nilotpal-n7/NanoD1/Project Outputs for NanoD1/Assembly Assembly/PCB 3D Print/NanoD1(Assembly).png

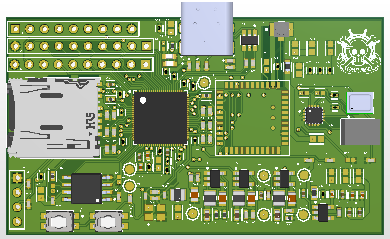
Project Outputs for NanoD1/Assembly Assembly/PCB 3D Print/NanoD1(Assembly).png
