nilotpal-n7/NanoD1/SBC/claude-gen/nano-d1-schematic.html

# Nano-D1

SG2002 · Schematic rev3 · I2S audio

—Parts

—Nets

—Pins

—Verify

Open items BOM Passives Clear

## Stackup

1.62 mm · 4L · 1 oz every layer. To scale. Click a copper layer to hide its nets.

Amber = verify before fab. Three items are unresolved and marked on the parts they affect.

Hover for value and notes · click to trace a net · drag to pan · scroll to zoom · Esc clears

+−⤢
