nilotpal-n7/NanoD1/Project Outputs for NanoD1/Assembly Assembly/Report Board Stack/NanoD1.xls

Board Stack Report
Stack Up |  | Layer Stack
Layer | Board Layer Stack | Name | Material | Thickness | Constant
1 |  | Top Overlay |  | 0mil
2 |  | Top Solder | SM-001 | 0.799mil | 3.8
3 |  | Top Layer | CF-004 | 1.378mil
4 |  | Dielectric 1 | PP-016 | 4.583mil | 4.16
5 |  | GND | CF-004 | 0.598mil
6 |  | Dielectric 2 | Core-043 | 49.803mil | 4.6
7 |  | POWER | CF-004 | 0.598mil
8 |  | Dielectric 3 | PP-016 | 4.583mil | 4.16
9 |  | Bottom Layer | CF-004 | 1.378mil
10 |  | Bottom Solder | SM-001 | 0.799mil | 3.8
11 |  | Bottom Overlay |  | 0mil
 | Height : 64.52mil
