nilotpal-n7/NanoD1/img0.bmp

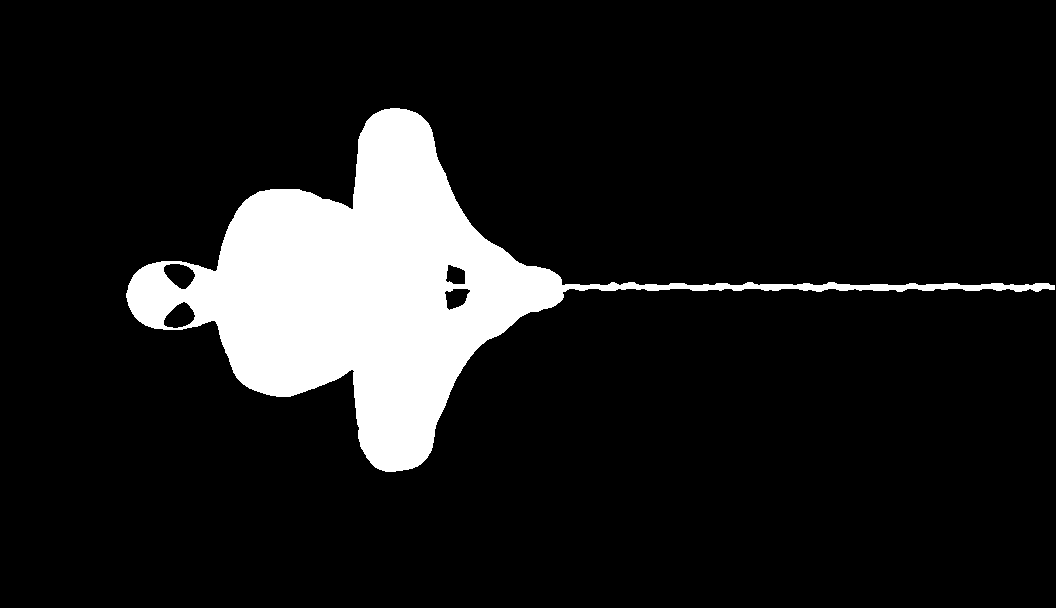
img0.bmp
