nilotpal-n7/NanoD1/img1.bmp

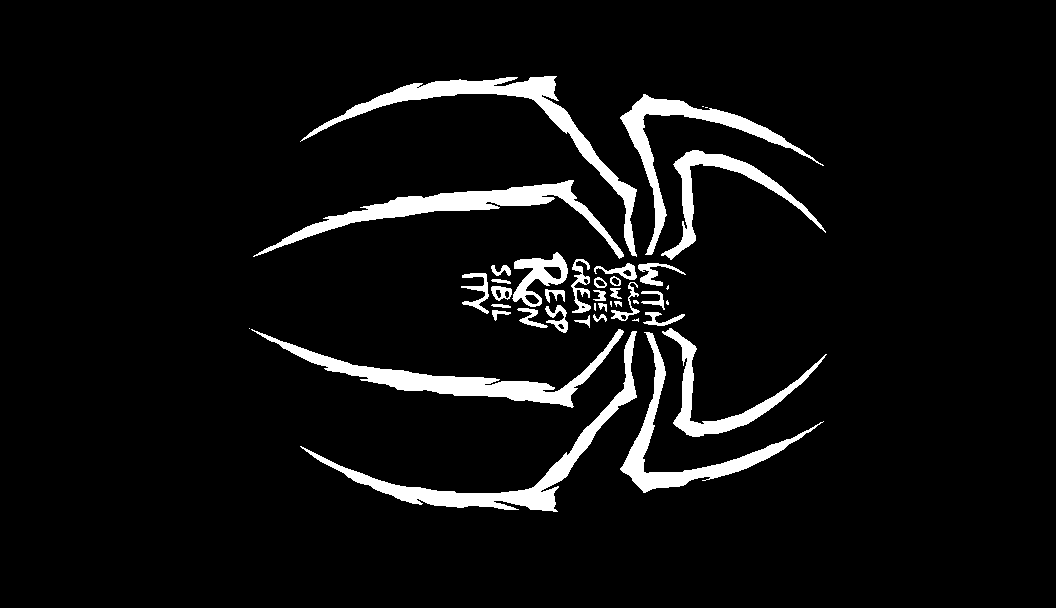
img1.bmp
