nilotpal-n7/NanoD1/Renders/NanoD1_bottom_black_nopour.png

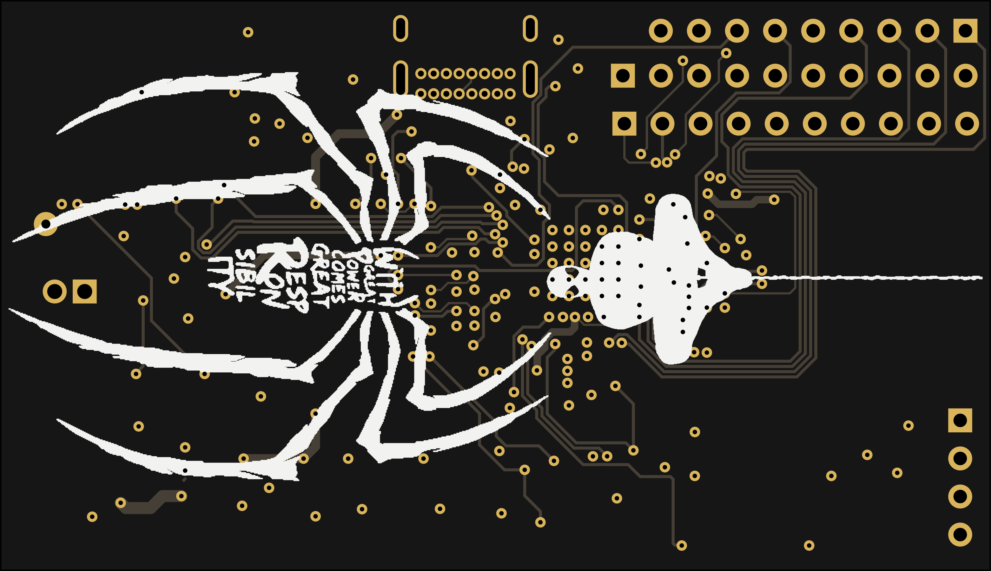
Renders/NanoD1_bottom_black_nopour.png
