nilotpal-n7/NanoD1/Renders/NanoD1_bottom_white_nopour.png

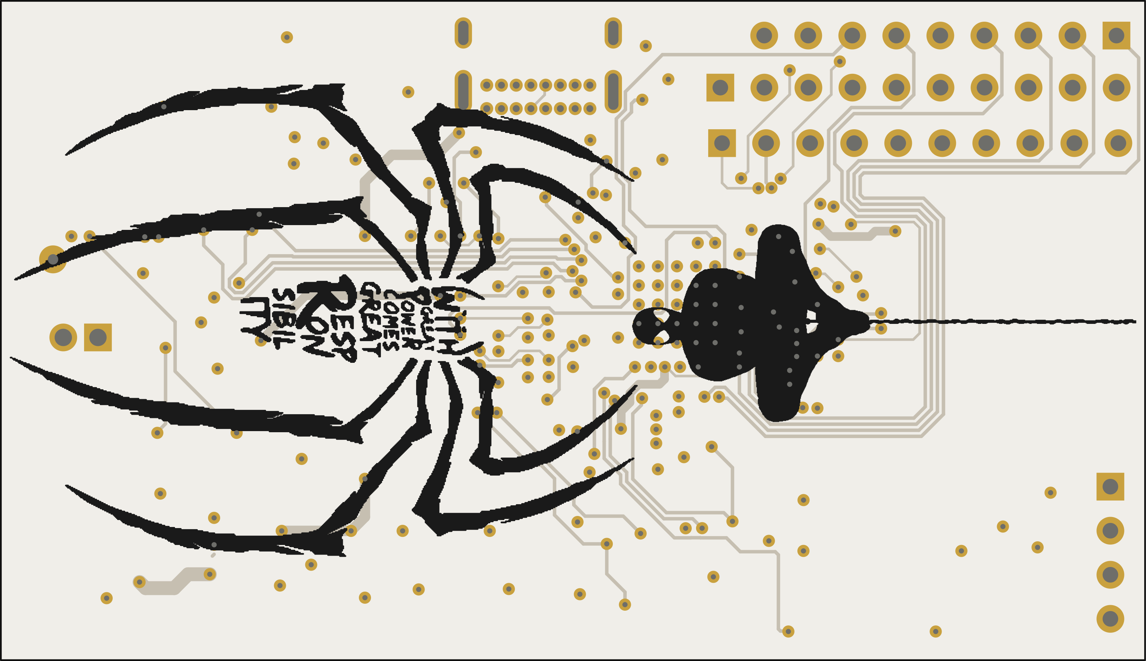
Renders/NanoD1_bottom_white_nopour.png
