nilotpal-n7/NanoD1/Renders/NanoD1_combined_top_black_pour_bottom_black_nopour.png

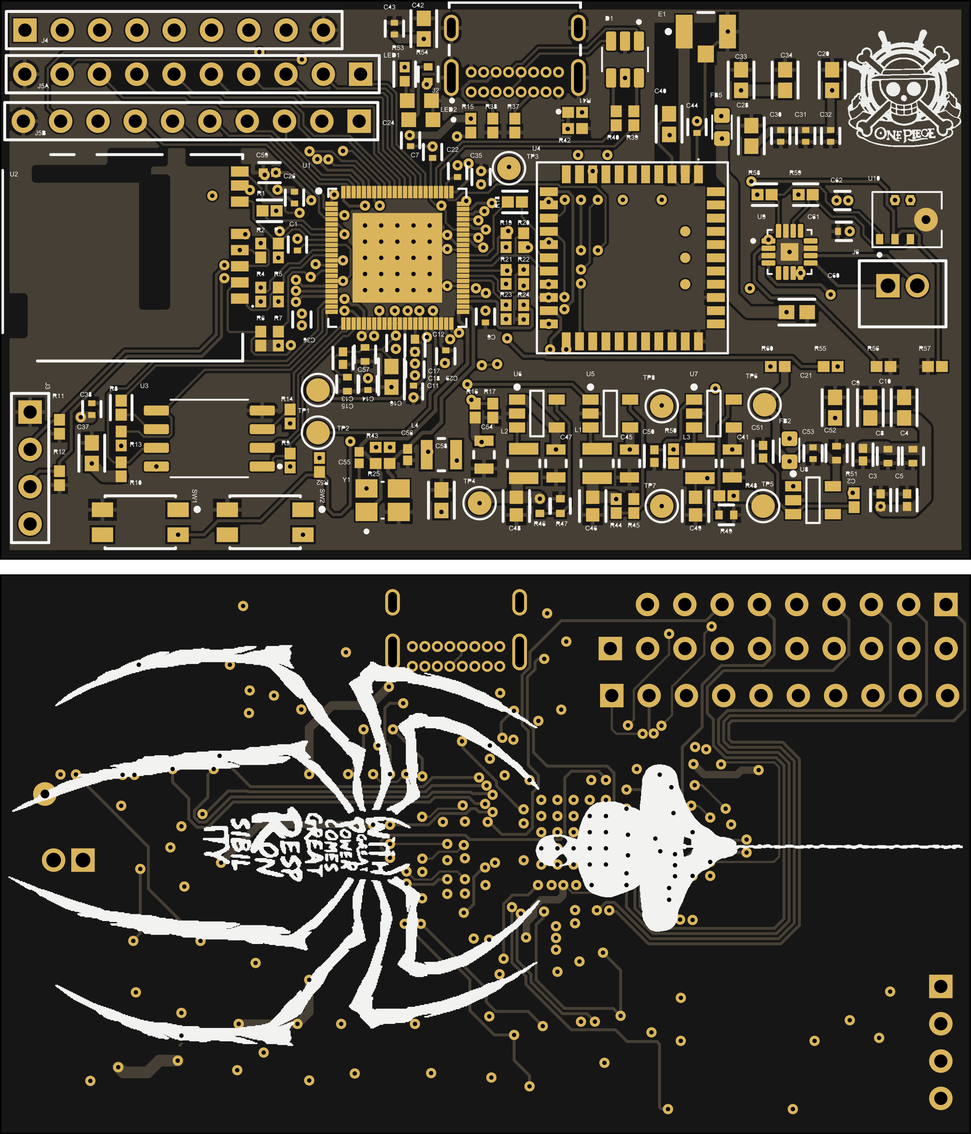
Renders/NanoD1_combined_top_black_pour_bottom_black_nopour.png
