nilotpal-n7/NanoD1/Renders/NanoD1_combined_top_white_pour_bottom_white_nopour.png

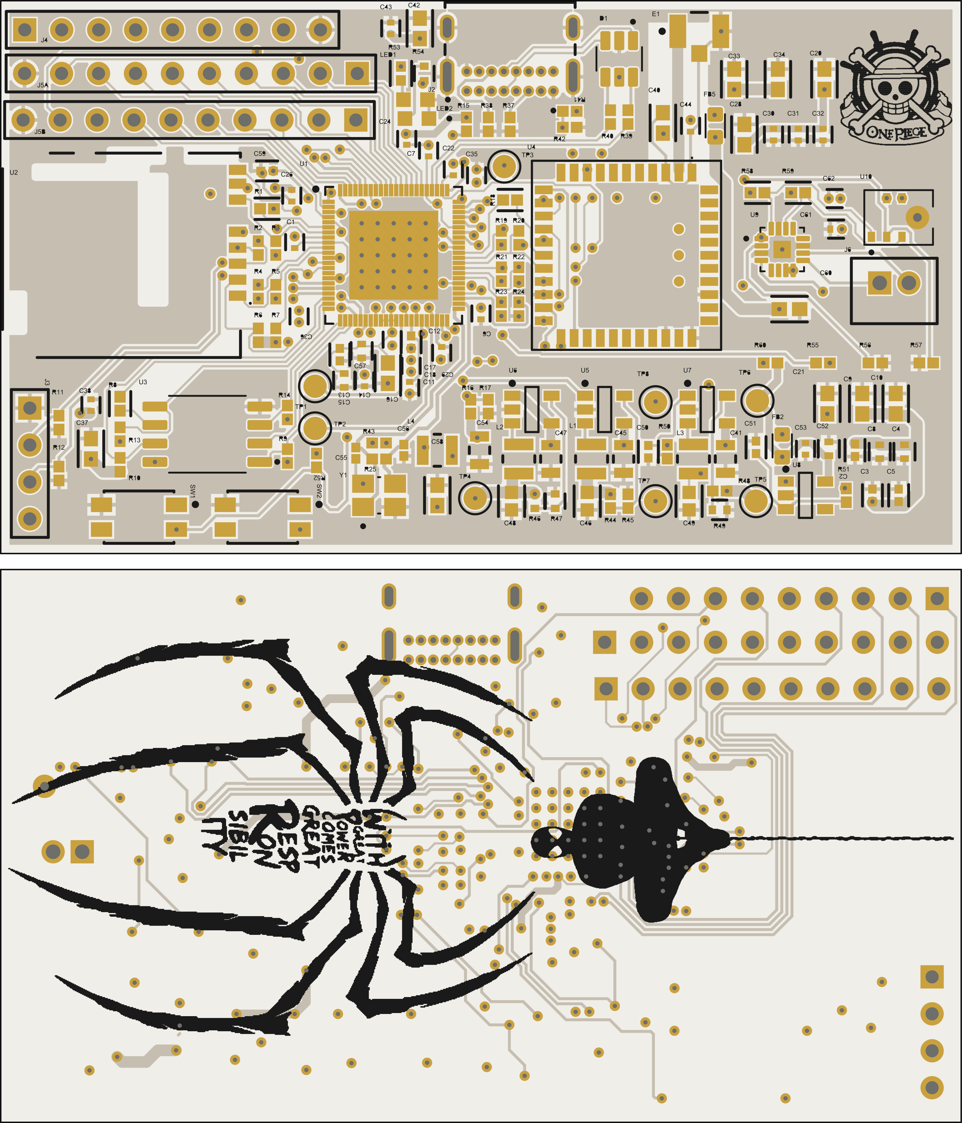
Renders/NanoD1_combined_top_white_pour_bottom_white_nopour.png
