nilotpal-n7/NanoD1/Renders/NanoD1_top_white_pour.png

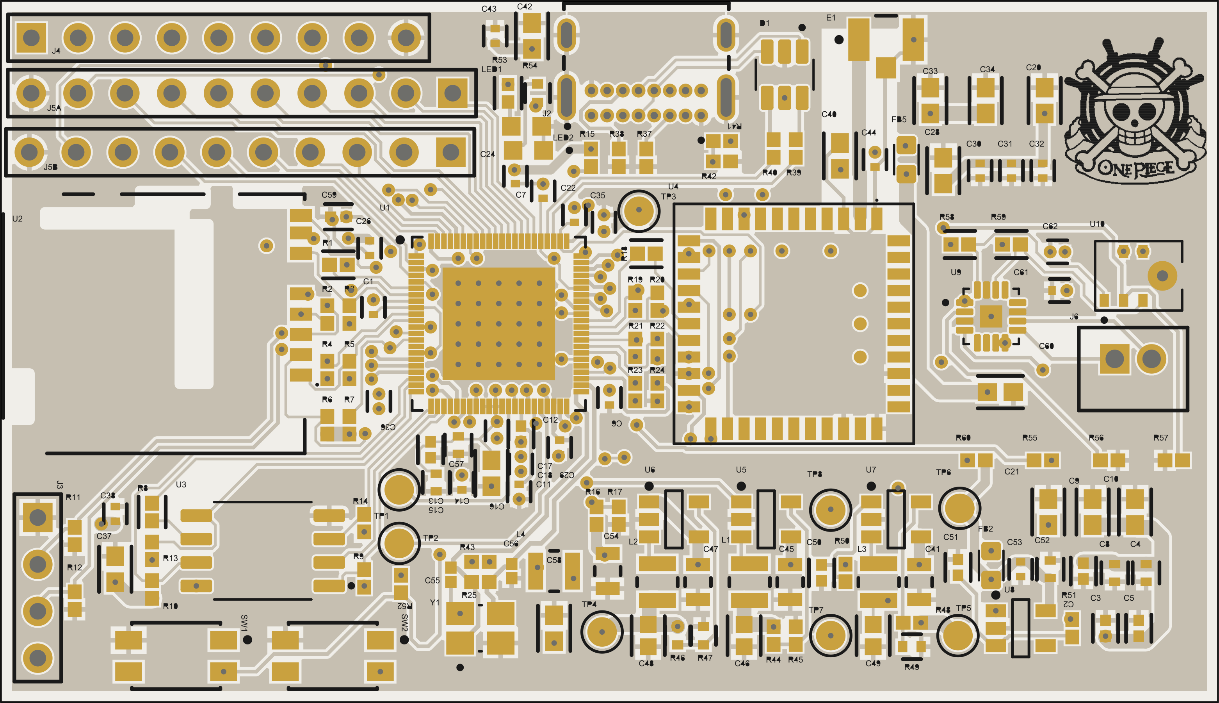
Renders/NanoD1_top_white_pour.png
