nilotpal-n7/NanoD1/SBC/components-doc/SCH_RK3576 SoM.pdf

RK3576 (Power) | RK3576 (GND)

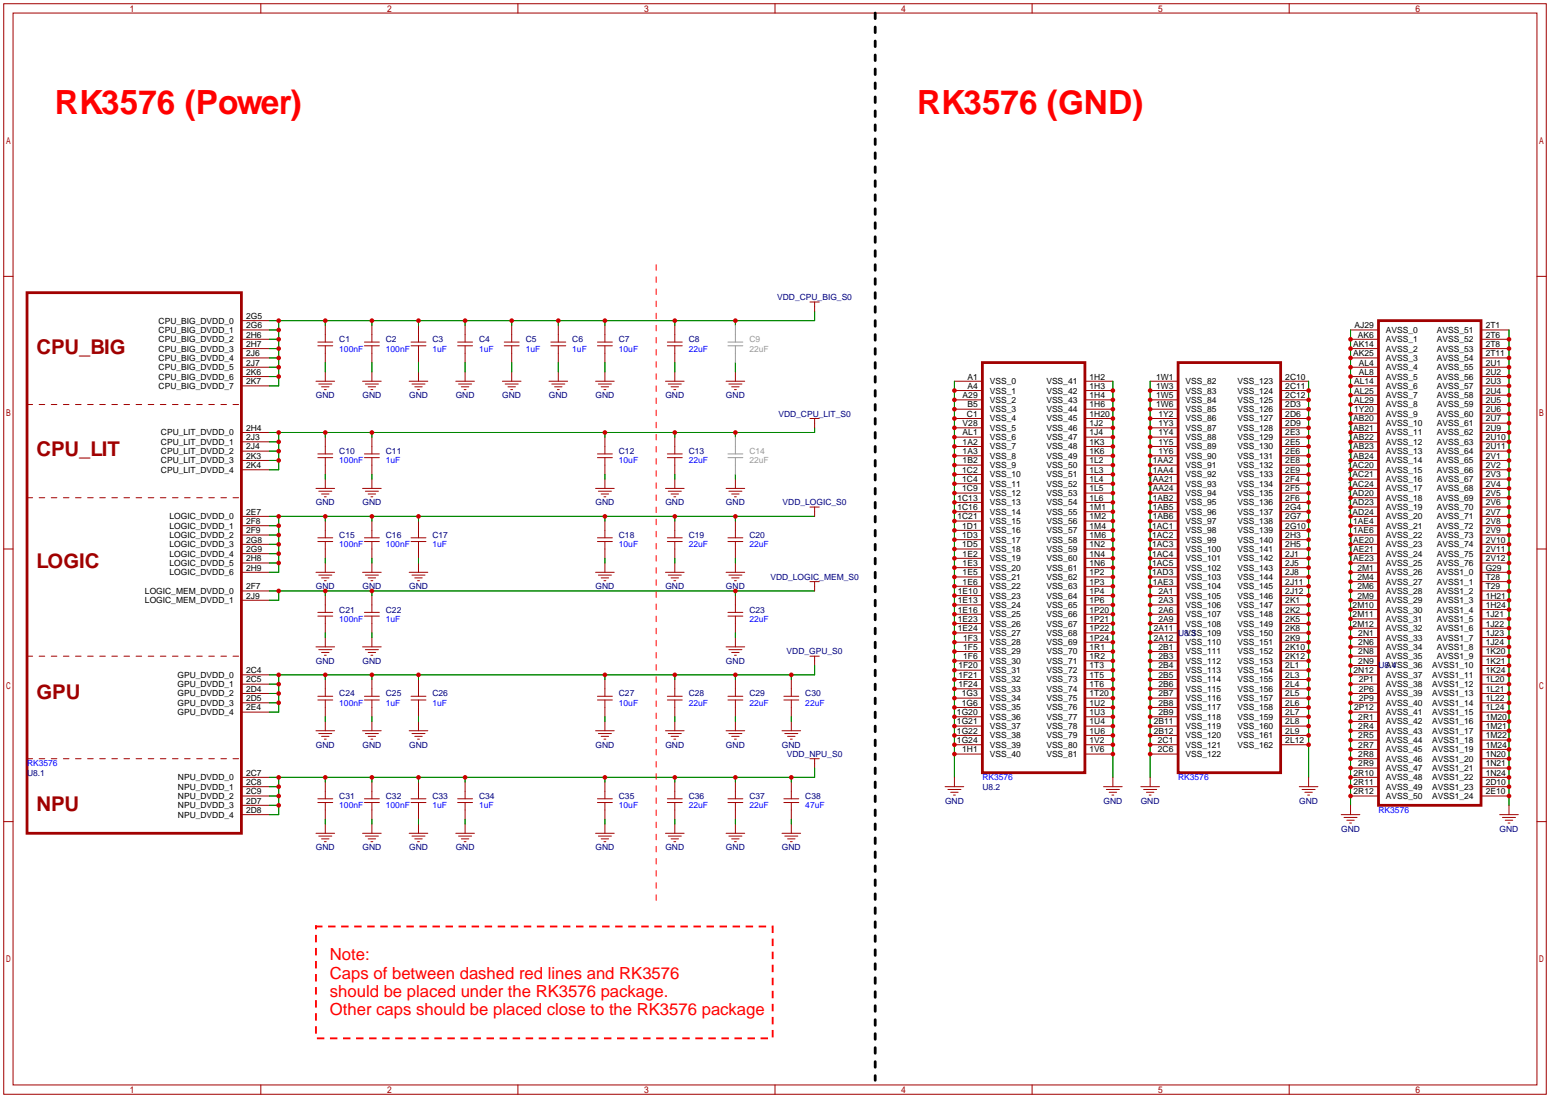
[picture p10: page 1]

Note:
Caps of between dashed red lines and RK3576
should be placed under the RK3576 package.
Other caps should be placed close to the RK3576 package

# PLL

## OSC PMUIO0 Domain

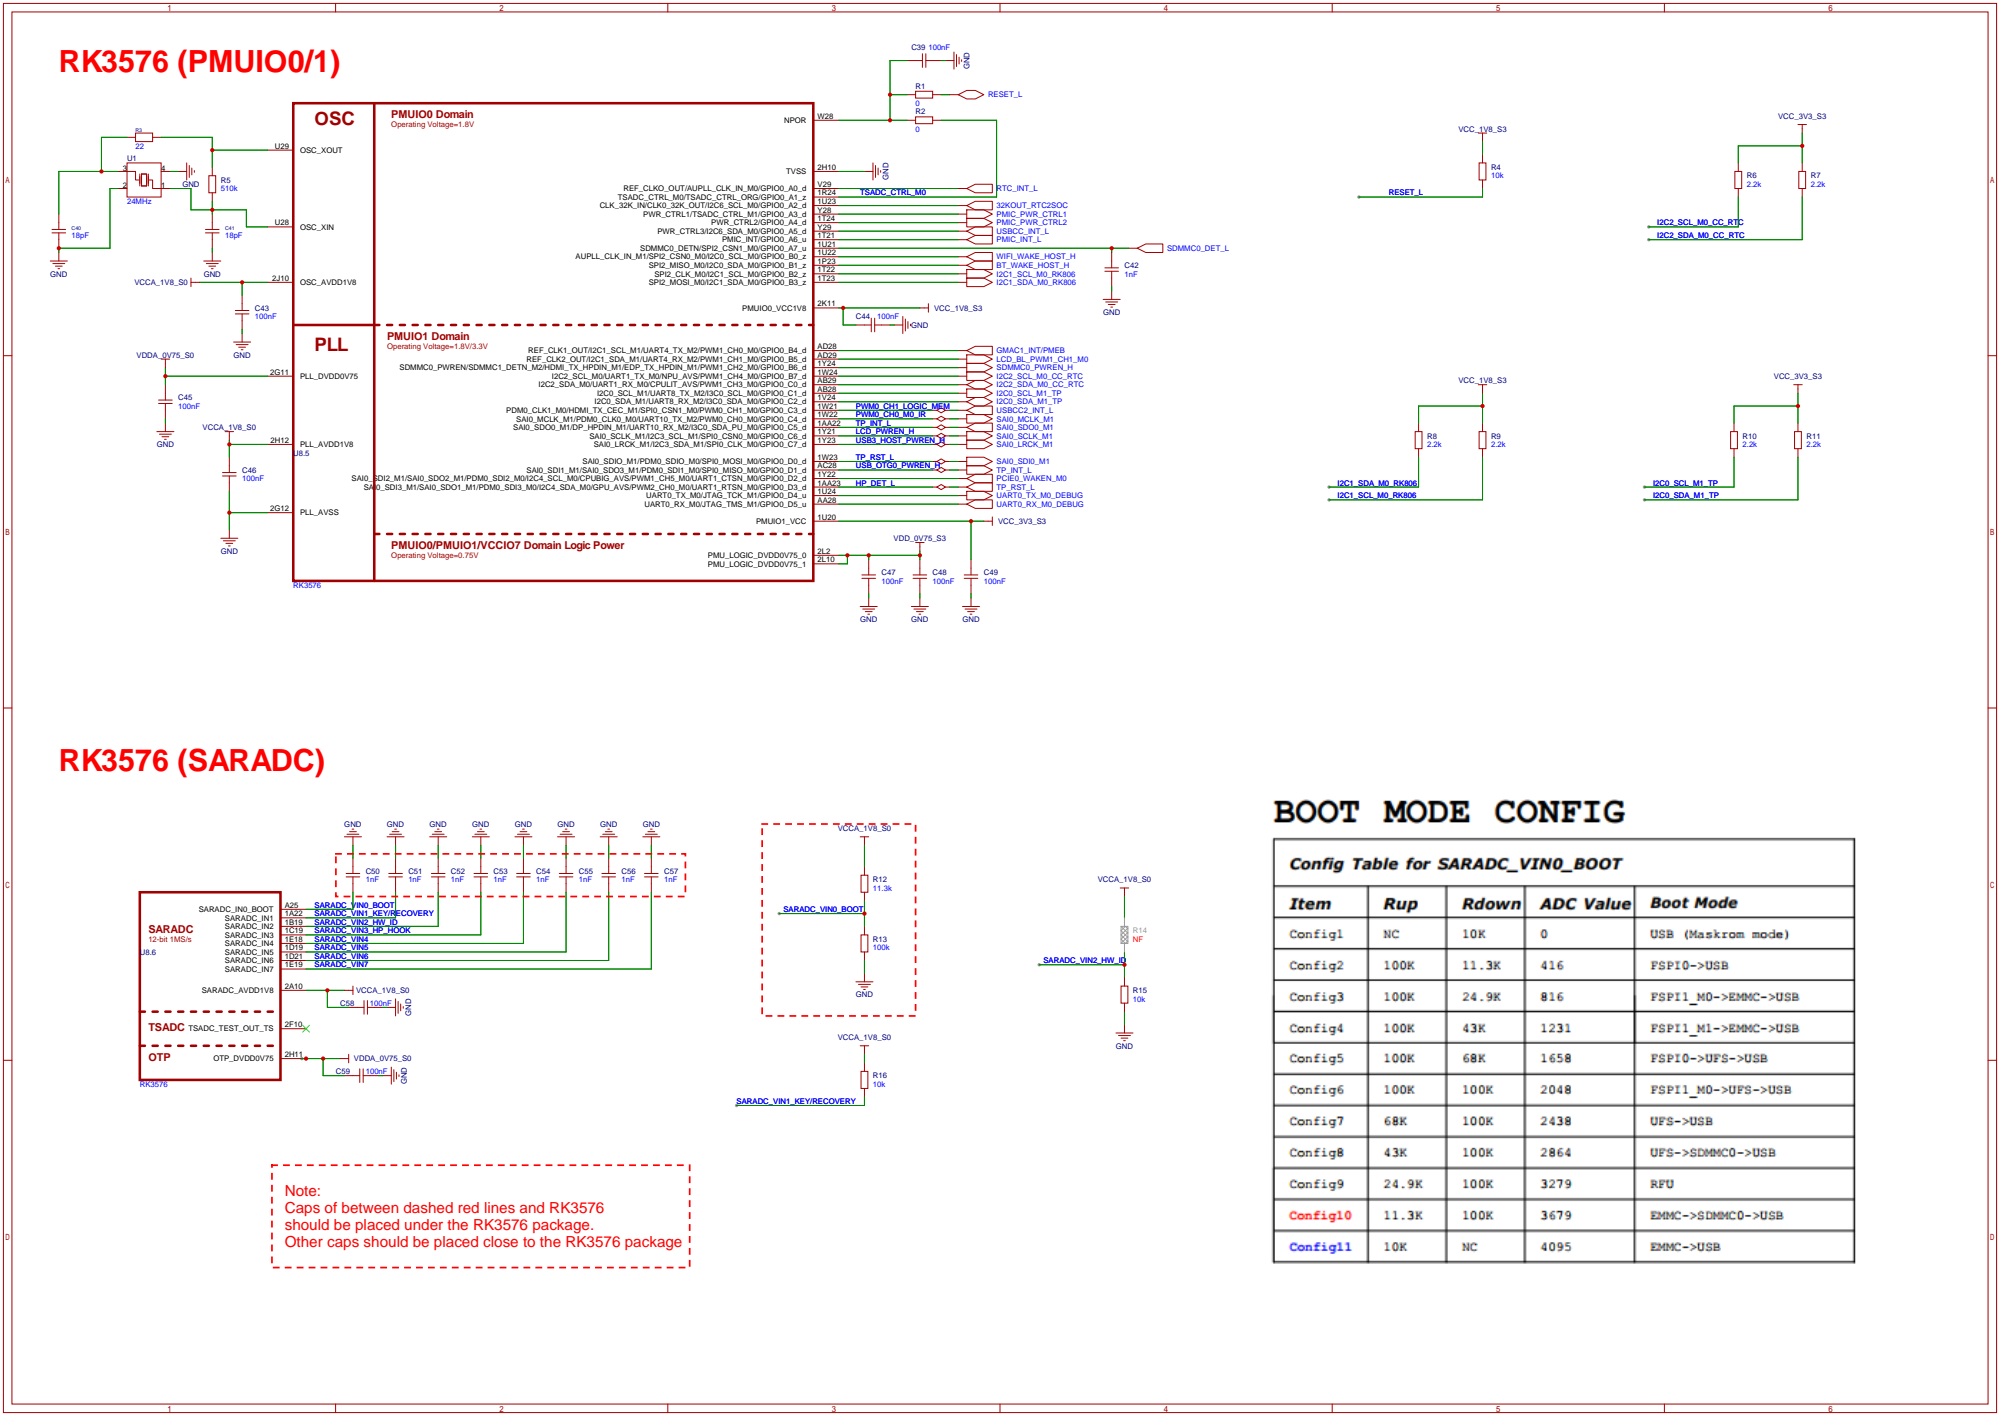
[picture p11: page 2]

Note:
Caps of between dashed red lines and RK3576
should be placed under the RK3576 package.
Other caps should be placed close to the RK3576 package

# RK3576 (DDRPHY)

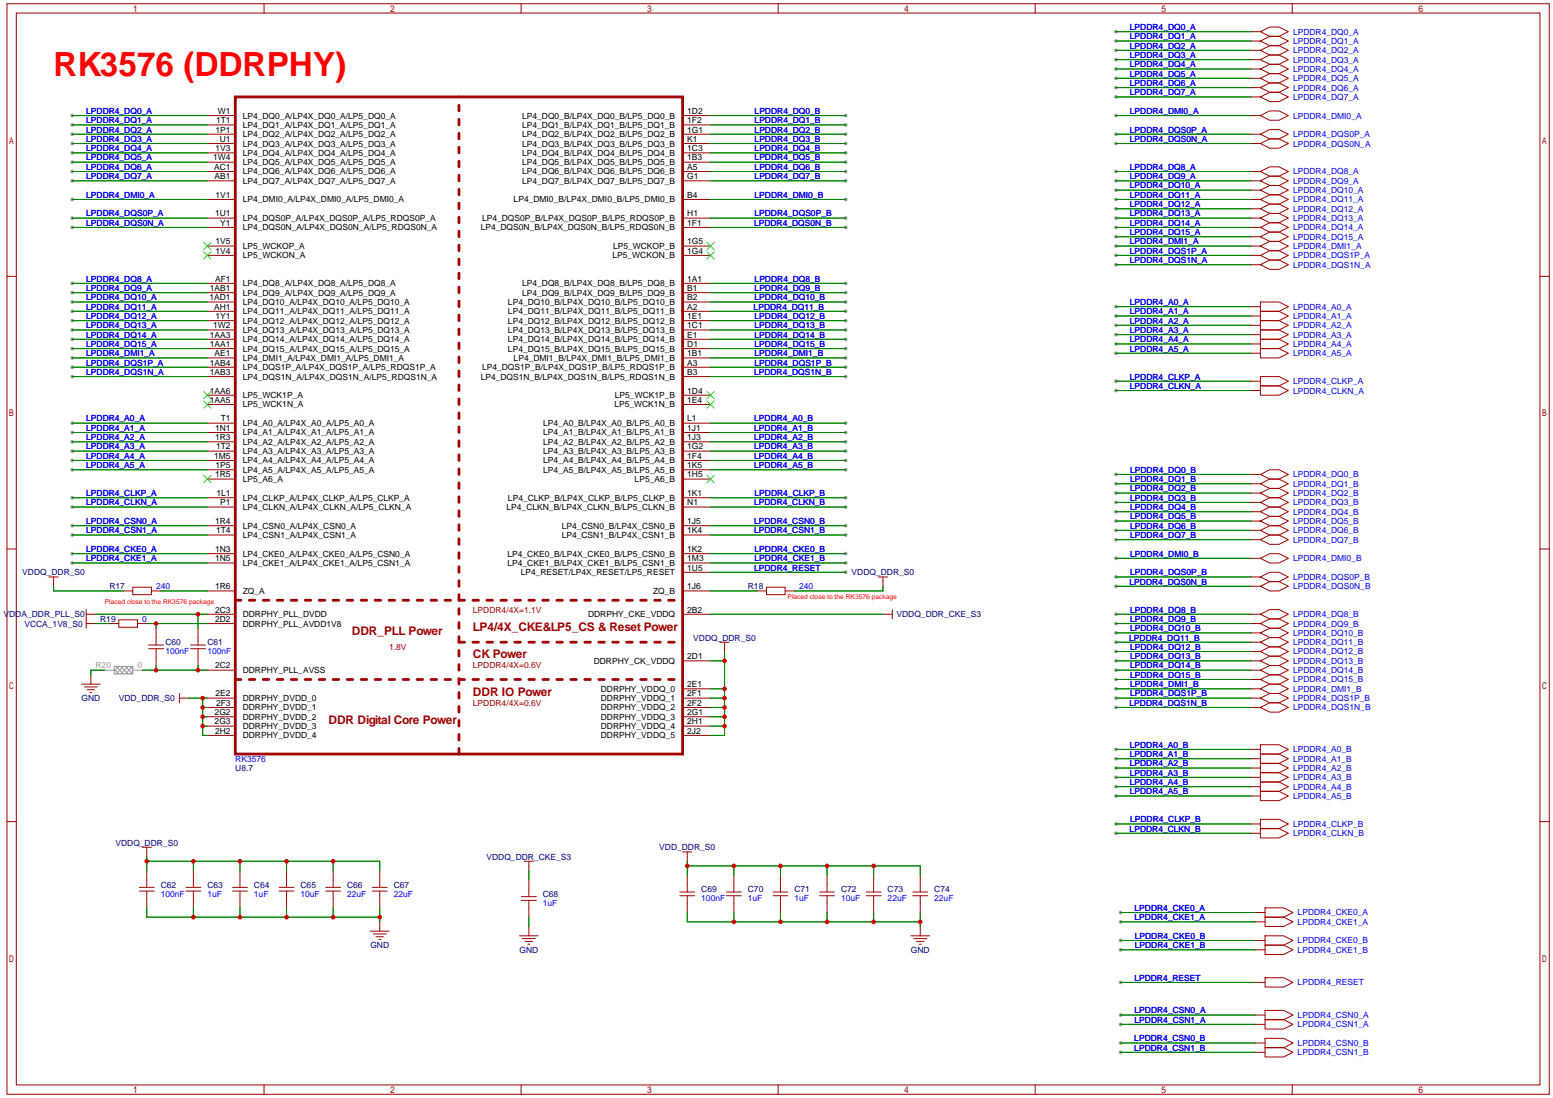
[picture p12: page 3]

Placed close to the RK3576 package

DDR Digital Core Power

## UFS2.1

## VCCIO7 Domain

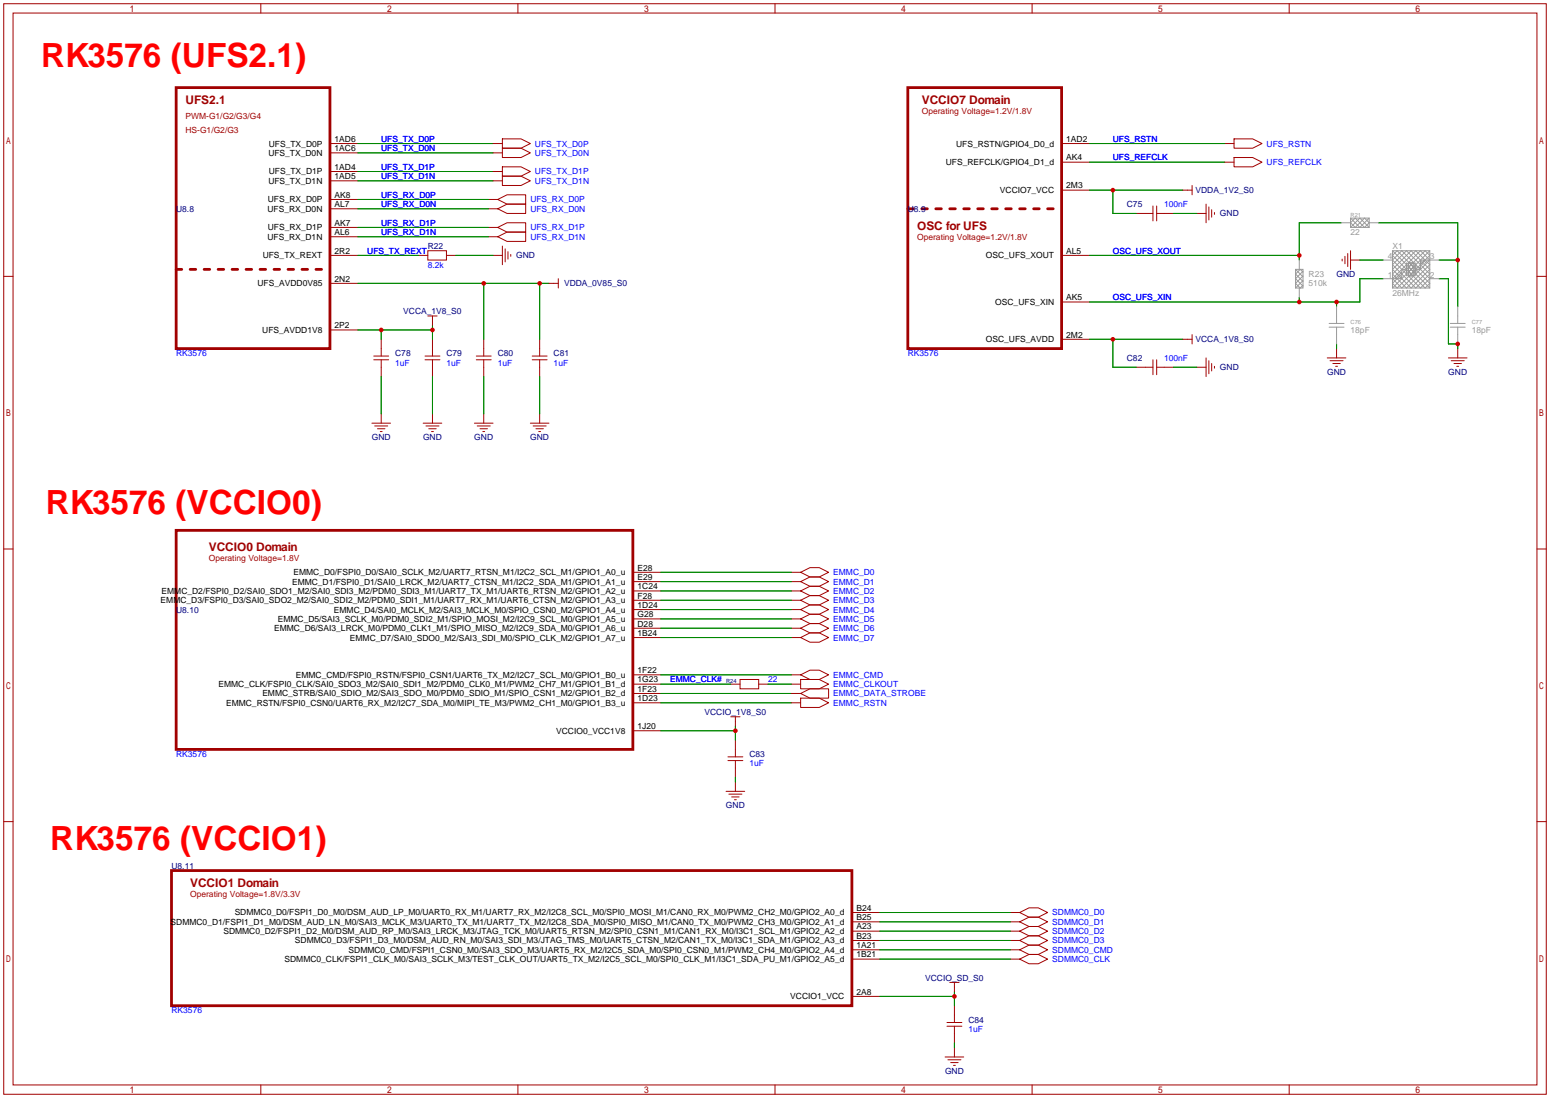
[picture p13: page 4]

# RK3576 (USB3/DP)

## USB3 OTG0/DP1.4 Alt

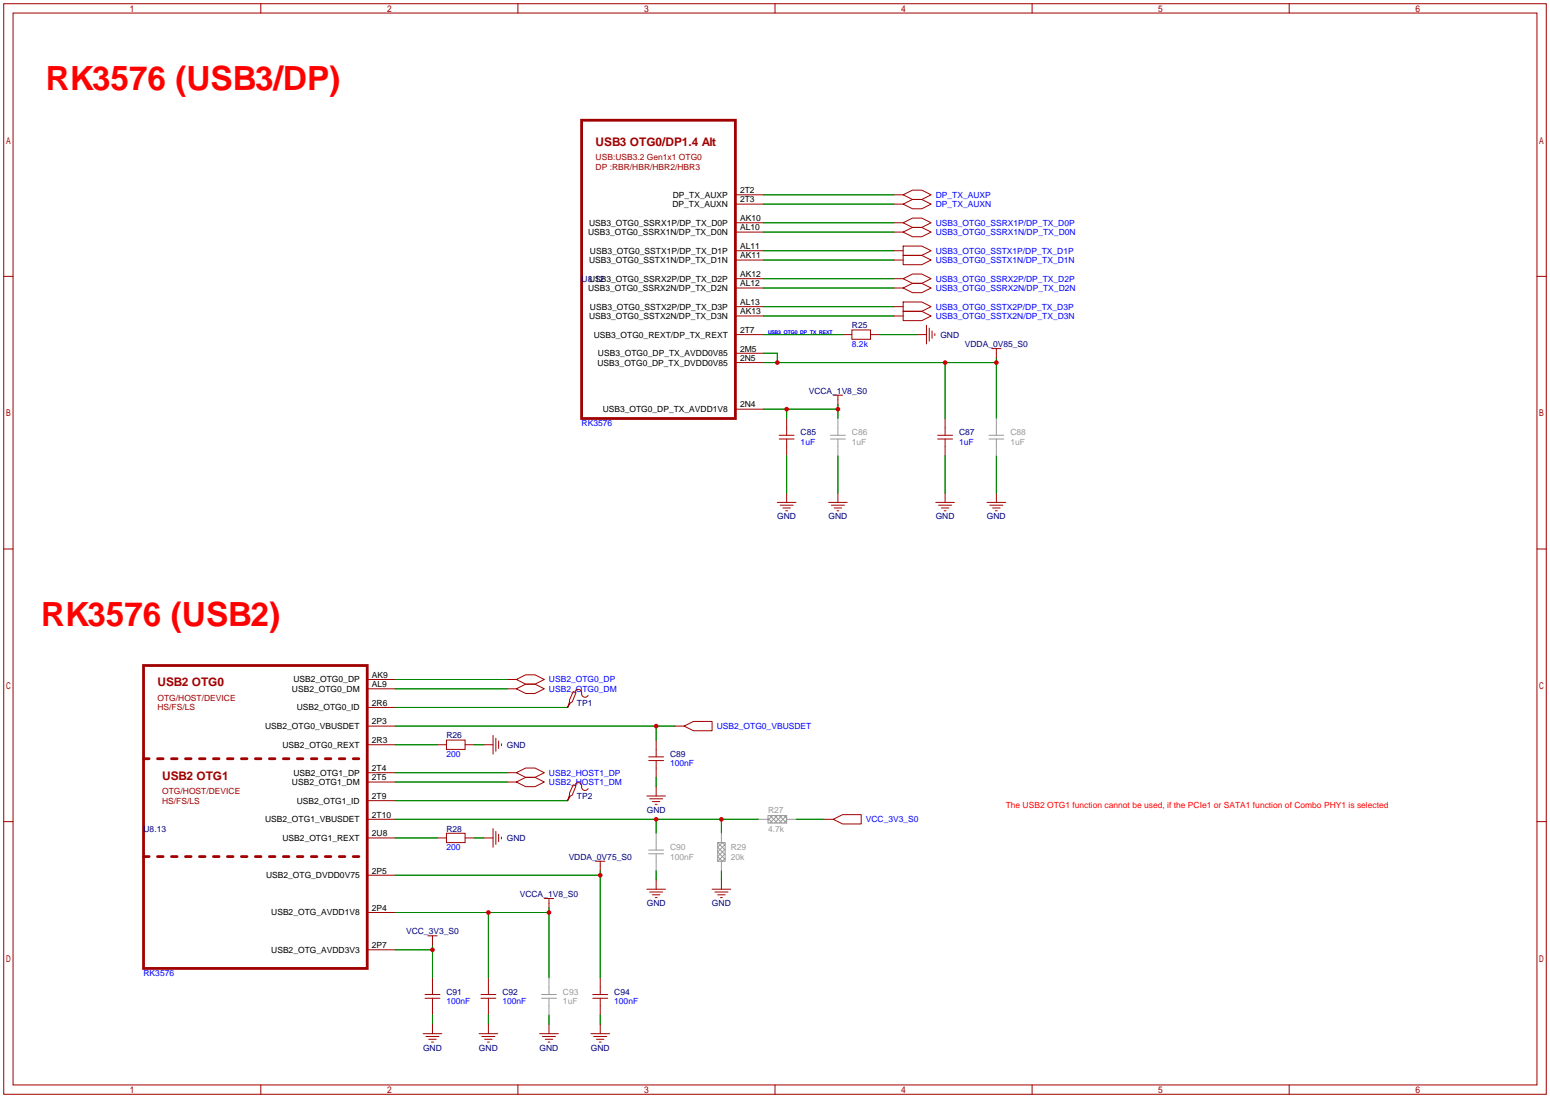
[picture p14: page 5]

The USB2 OTG1 function cannot be used, if the PCIe1 or SATA1 function of Combo PHY1 is selected

# RK3576 (MIPI DCPHY)

## MIPI DCPHY DSI TX

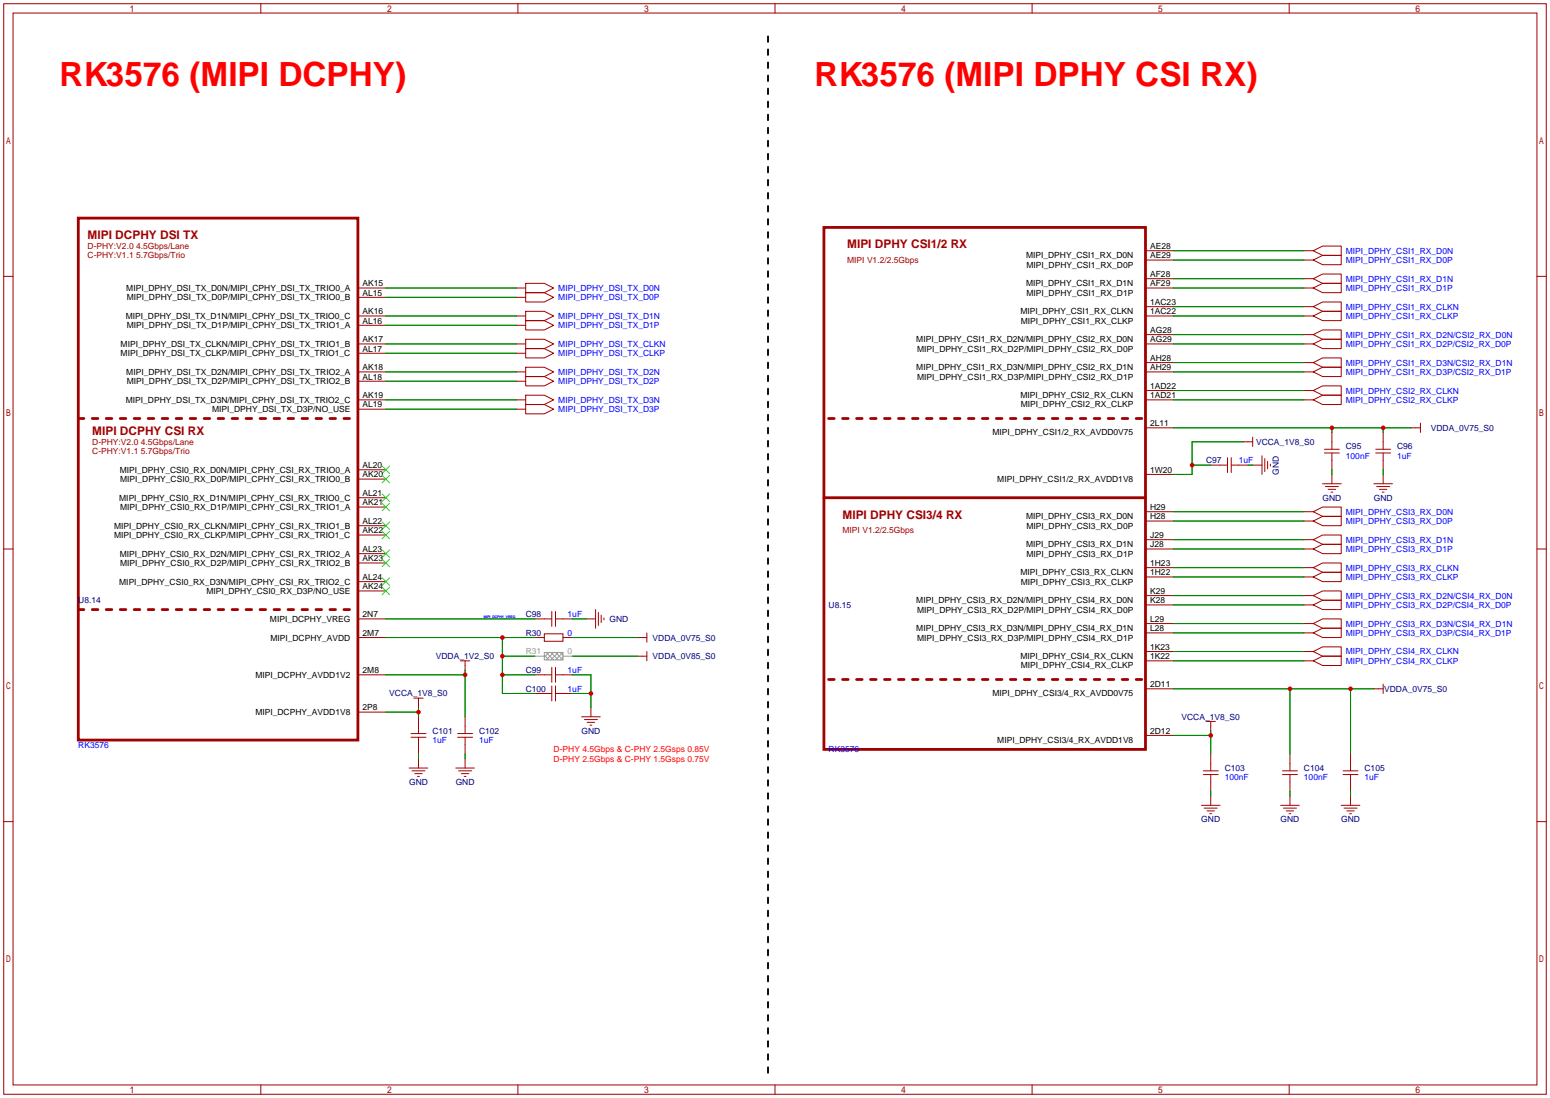
[picture p15: page 6]

RK3576 (MIPI DPHY CSI RX)

# RK3576 (HDMI/eDP)

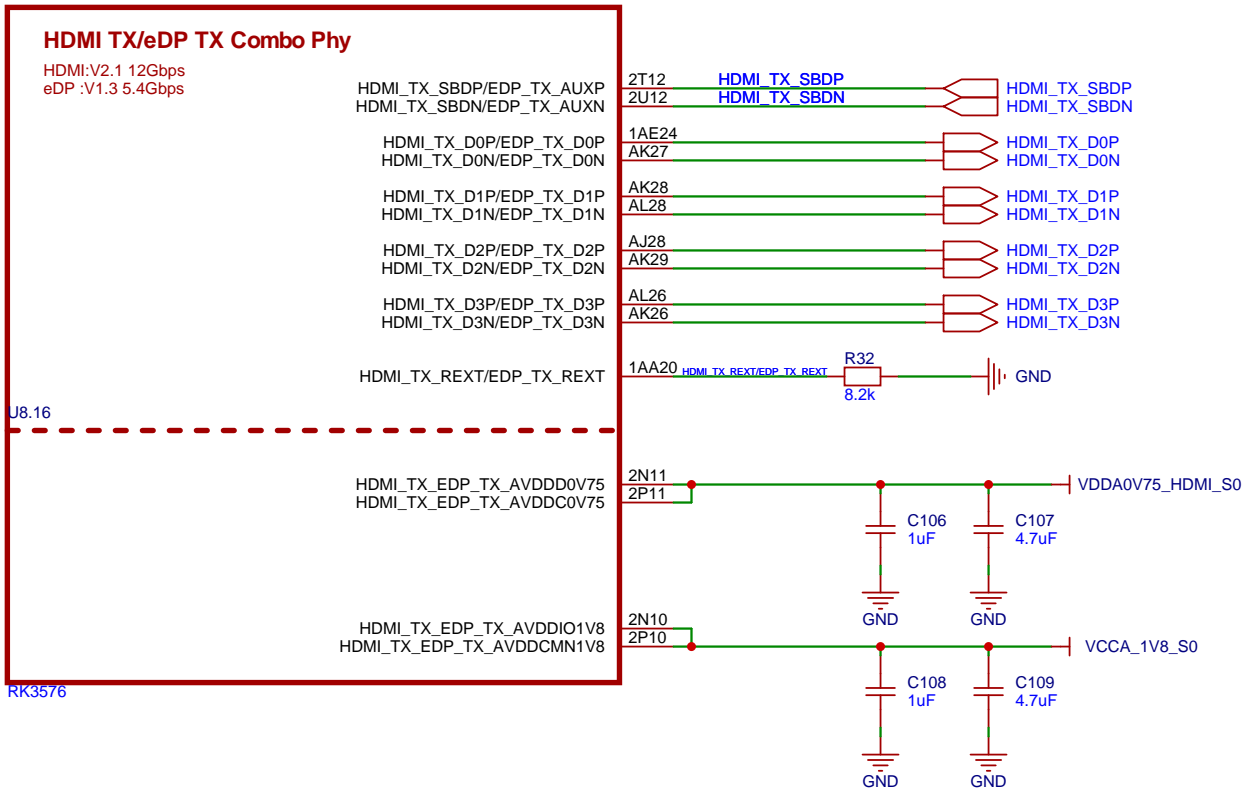
[picture p16: figure]
HDMI_TX_SBDP/EDP_TX_AUXP 2T12 HDMI_TX_SBDN/EDP_TX_AUXN 2U12; HDMI_TX_D0P/EDP_TX_D0P 1AE24 HDMI_TX_D0N/EDP_TX_D0N AK27; HDMI_TX_D1P/EDP_TX_D1P AK28 HDMI_TX_D1N/EDP_TX_D1N AL28; HDMI_TX_D2P/EDP_TX_D2P AJ28 HDMI_TX_D2N/EDP_TX_D2N AK29; HDMI_TX_D3P/EDP_TX_D3P AL26 HDMI_TX_D3N/EDP_TX_D3N AK26; HDMI_TX_REXT/EDP_TX_REXT 1AA20; HDMI_TX_EDP_TX_AVDDD0V75 2N11 HDMI_TX_EDP_TX_AVDDC0V75 2P11; HDMI_TX_EDP_TX_AVDDIO1V8 2N10 HDMI_TX_EDP_TX_AVDDCMN1V8 2P10; HDMI TX/eDP TX Combo Phy; HDMI:V2.1 12Gbps eDP :V1.3 5.4Gbps; HDMI_TX_D0P HDMI_TX_D0N; HDMI_TX_D1P HDMI_TX_D1N; HDMI_TX_D2P HDMI_TX_D2N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

# RK3576 (PCIe/SATA/USB3)

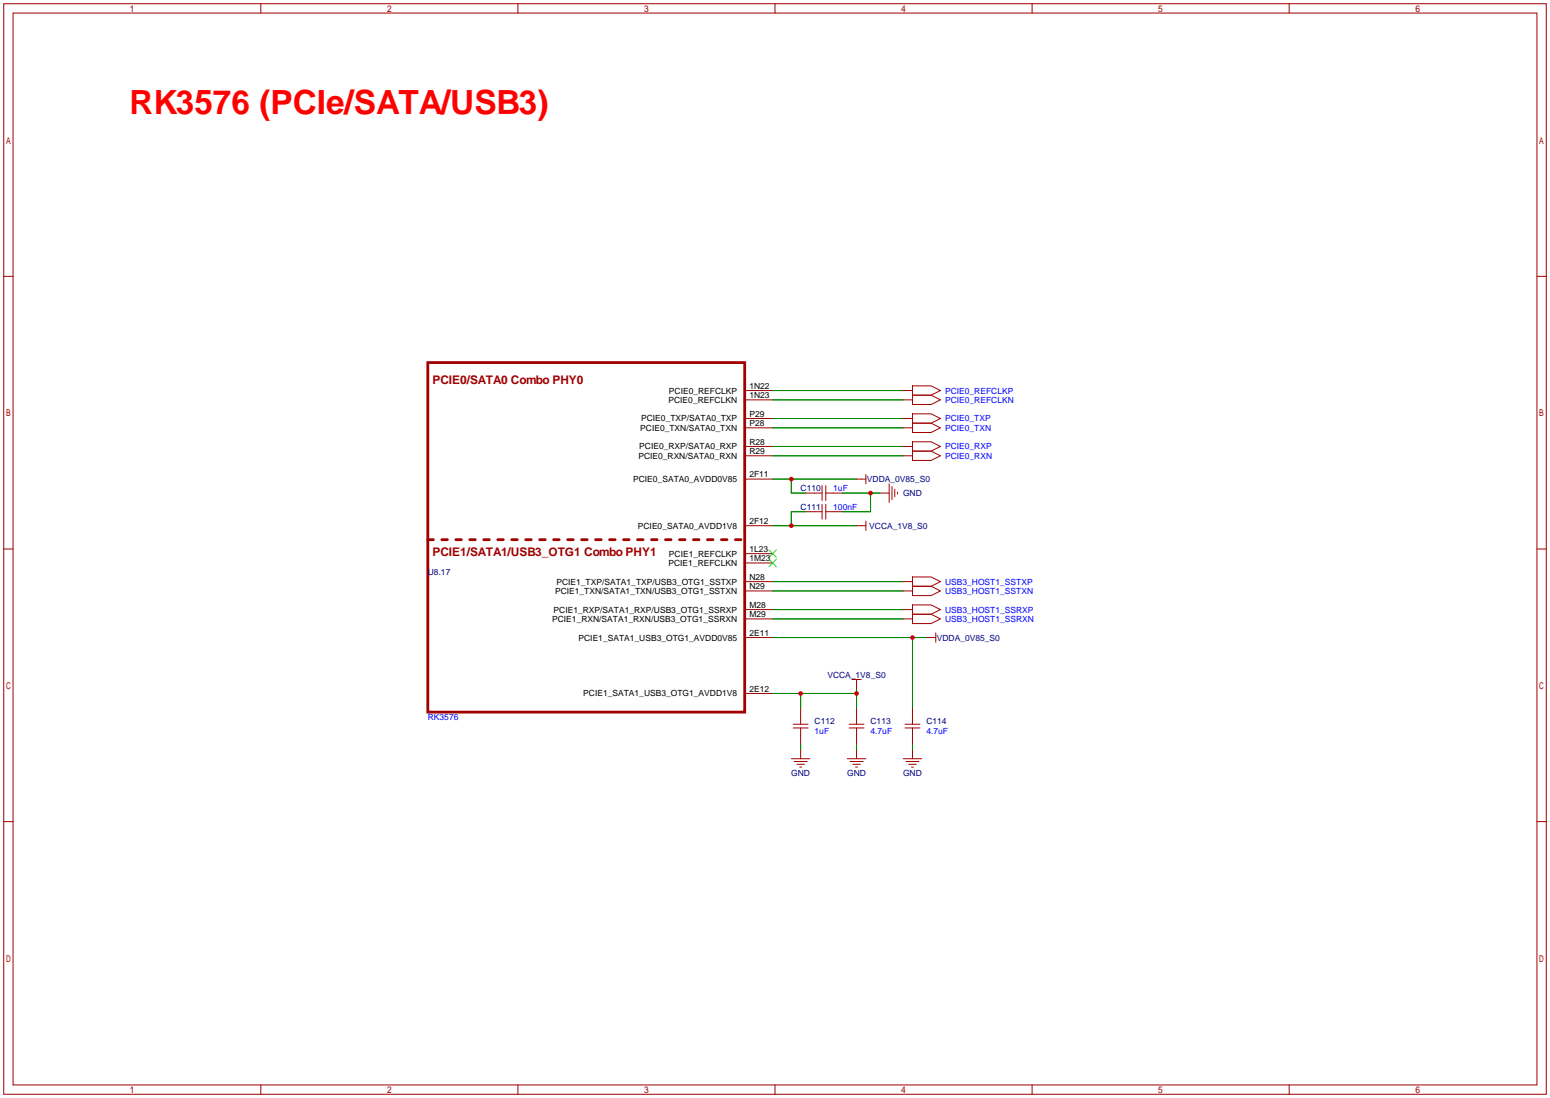
[picture p17: page 8]

SAI1_MCLK_M0/SAI4_MCLK_M0/AUPLL_CLK_IN_M2/PWM2_CH5_M0/GPIO4_A2_d 1D6 SAI1_SCLK_M0/FLEXBUS1_CSN_M4/SPI3_CSN0_M2/UART5_RTSN_M1/I2C2_SCL_M2/PWM2_CH4_M1/GPIO4_A3_d 1C6 SAI4_SCLK_M0/PDM1_SDI3_M1/FLEXBUS0_D13_M1/SPI3_MOSI_M2/UART6_TX_M0/I2C4_SCL_M1/CAN0_TX_M2/GPIO4_A4_d 1C5 SAI1_LRCK_M0/FLEXBUS1_D12_M1/SPI4_CSN1_M2/UART5_CTSN_M1/I2C2_SDA_M2/PCIE1_CLKREQN_M2/GPIO4_A5_d 1B6 SAI4_LRCK_M0/PDM1_CLK0_M1/FLEXBUS0_D14_M1/SPI3_MISO_M2/UART6_RX_M0/I2C4_SDA_M1/CAN0_RX_M2/GPIO4_A6_d 1B5 SAI1_SDO0_M0/SAI4_SDI_M0/SPI3_CLK_M2/PWM2_CH6_M0/GPIO4_A7_d A7 SAI1_SDO1_M0/SAI1_SDI3_M0/PDM1_CLK1_M1/FLEXBUS1_D13_M1/SPI4_CLK_M2/UART5_TX_M1/UART6_RTSN_M0/UART2_RTSN_M1/GPIO4_B0_d 1A5 SAI1_SDO2_M0/SAI1_SDI2_M0/PDM1_SDI2_M1/FLEXBUS1_D14_M1/SPI4_MOSI_M2/UART5_RX_M1/UART6_CTSN_M0/UART2_CTSN_M1/GPIO4_B1_d B7 SAI1_SDO3_M0/SAI1_SDI1_M0/PDM1_SDI1_M1/FLEXBUS1_D15_M1/SPI4_MISO_M2/MIPI_TE_M0/GPIO4_B2_d B6 SAI1_SDI0_M0/SAI4_SDO_M0/PDM1_SDI0_M1/SPI4_CSN0_M2/SPI3_CSN1_M2/PWM2_CH7_M0/GPIO4_B3_d 1A6 SPDIF_RX0_M0/FLEXBUS0_CSN_M4/UART2_RX_M1/I2C3_SDA_M0/CAN1_RX_M2/GPIO4_B4_d B8 SPDIF_TX0_M0/FLEXBUS0_D15_M1/UART2_TX_M1/I2C3_SCL_M0/PCIE0_CLKREQN_M2/CAN1_TX_M2/GPIO4_B5_d 1A4

## VCCIO2 Domain

Operating Voltage=1.8V/3.3V

VCCIO2_VCC 2A2

U8.18

RK3576

ETH1_RXD2_M1/SDMMC1_D0_M0/SAI3_SCLK_M1/I2C9_SDA_M1/SPI1_CLK_M0/PCIE1_CLKREQN_M1/PWM1_CH0_M1/GPIO1_B4_d A28 ETH1_RXD3_M1/SDMMC1_D1_M0/SAI3_LRCK_M1/I2C9_SCL_M1/SPI1_MOSI_M0/PWM1_CH1_M1/GPIO1_B5_d B27 ETH1_RXCLK_M1/SDMMC1_D2_M0/SAI3_SDO_M1/UART3_CTSN_M2/SPI1_MISO_M0/PCIE0_CLKREQN_M1/GPIO1_B6_d 1A23 ETH1_TXD2_M1/SDMMC1_D3_M0/SAI3_SDI_M1/UART3_RTSN_M2/SPI1_CSN0_M0/GPIO1_B7_d A27 ETH1_TXD3_M1/SDMMC1_CMD_M0/PDM0_SDI2_M2/UART3_TX_M2/SPI1_CSN1_M0/PWM0_CH0_M1/GPIO1_C0_d B26 ETH1_TXCLK_M1/SDMMC1_CLK_M0/SAI3_MCLK_M1/PDM0_CLK0_M2/UART3_RX_M2/GPIO1_C1_d 1B22 ETH1_PPSCLK_M1/SDMMC1_PWREN_M0/FSPI1_RSTN_M1/FSPI1_CSN1_M1/UART4_RTSN_M1/I2C6_SCL_M1/SPI2_CSN1_M1/PWM1_CH2_M1/GPIO1_C2_u B29 ETH1_PPSTRIG_M1/SDMMC1_DETN_M0/FSPI1_CSN0_M1/UART4_CTSN_M1/I2C6_SDA_M1/SPI2_CSN0_M1/GPIO1_C3_u 1C23 ETH1_TXD0_M1/FSPI1_D0_M1/UART4_TX_M1/UART2_RTSN_M0/SPI2_MOSI_M1/PCIE0_BUTTONRSTN/GPIO1_C4_d 1B23 ETH1_TXD1_M1/FSPI1_D1_M1/UART4_RX_M1/UART2_CTSN_M0/SPI2_MISO_M1/PCIE1_BUTTONRSTN/GPIO1_C5_d B28 ETH1_TXCTL_M1/FSPI1_D2_M1/PDM0_SDIO_M2/UART2_TX_M0/I2C8_SCL_M1/SATA_CPPOD/GPIO1_C6_d A26 ETH1_RXD0_M1/FSPI1_D3_M1/PDM0_SDI1_M2/UART2_RX_M0/I2C8_SDA_M1/SATA_CPDET/GPIO1_C7_d 1C22 ETH1_RXD1_M1/SAI2_SDO_M0/UART10_TX_M1/GPIO1_D0_d C29 ETH1_RXCTL_M1/SAI2_SCLK_M0/UART10_RX_M1/I3C0_SDA_PU_M1/GPIO1_D1_d 1D22 ETH1_MDC_M1/SAI2_LRCK_M0/I3C0_SCL_M1/PWM1_CH3_M1/GPIO1_D2_d 1A24 ETH1_MDIO_M1/SAI2_SDI_M0/I3C0_SDA_M1/PWM1_CH4_M1/GPIO1_D3_d C28 ETH1_MCLK_M1/SAI2_MCLK_M0/PDM0_SDI3_M2/SPDIF_RX1_M2/UART10_RTSN_M1/I2C5_SCL_M1/GPIO1_D4_d 1E21 ETH_CLK1_25M_OUT_M1/FSPI1_CLK_M1/PDM0_CLK1_M2/SPDIF_TX1_M2/UART10_CTSN_M1/I2C5_SDA_M1/SPI2_CLK_M1/SATA_MPSWITCH/CLK1_32K_OUT/GPIO1_D5_d 1E22

## VCCIO3 Domain

Operating Voltage=1.8V/3.3V

VCCIO3_VCC 2B10

U8.19

RK3576

DSM_AUD_LP_M1/SAI4_MCLK_M2/HDMI_TX_CEC_M0/I2C7_SCL_M3/SPI4_CSN1_M0/UART11_TX_M2/PWM1_CH5_M1/GPIO4_C0_d AK3 DSM_AUD_LN_M1/HDMI_TX_HPDIN_M0/PCIE1_CLKREQN_M3/I2C7_SDA_M3/EDP_TX_HPDIN_M0/UART11_RX_M2/PWM0_CH1_M1/GPIO4_C1_d AK2 DSM_AUD_RP_M1/HDMI_TX_SCL/I2C2_SCL_M3/CAN0_TX_M1/UART9_TX_M2/PWM2_CH0_M1/GPIO4_C2_d AL2 DSM_AUD_RN_M1/HDMI_TX_SDA/I2C2_SDA_M3/CAN0_RX_M1/UART9_RX_M2/PWM2_CH1_M1/GPIO4_C3_d 1AE2 ISP_PRELIGHT_TRIG_M1/SAI4_LRCK_M2/DP_HPDIN_M0/I2C3_SCL_M3/SPI4_CSN0_M0/UART6_TX_M3/PWM2_CH6_M1/GPIO4_C4_d AL3 ISP_FLASH_TRIGOUT_M1/SAI4_SDO_M2/VP0_SYNC_OUT/SATA1_ACTLED_M1/I2C3_SDA_M3/SPI4_MOSI_M0/UART6_RX_M3/PWM2_CH5_M1/GPIO4_C5_d AK1 SAI4_SDI_M2/VP1_SYNC_OUT/PCIE0_CLKREQN_M3/SATA0_ACTLED_M1/I2C6_SCL_M3/SPI4_MISO_M0/CAN1_TX_M1/PWM2_CH2_M1/GPIO4_C6_d 1AE1 SAI4_SCLK_M2/VP2_SYNC_OUT/I2C6_SDA_M3/SPI4_CLK_M0/CAN1_RX_M1/PWM2_CH3_M1/GPIO4_C7_d AJ1

VCCIO6_VCC 2N3

## VCCIO6 Domain

Operating Voltage=1.8V/3.3V

U8.20

RK3576

SAI1_MCLK_M0
SAI1_SCLK_M0
USB3_HOST_PWREN_H
SAI1_LRCK_M0
USB_OTG0_PWREN_H
SAI1_SDO0_M0
HP_DET_L
LED_RED_EN
LED_GREEN_EN
SAI1_SDI0_M0
I2C3_SCL_M0_AUDIO

I2C3_SDA_M0_AUDIO

C115
100nF

GND

VCCIO_AUDIO

R33
2.2k

R34
2.2k

VCCIO_AUDIO

I2C3_SCL_M0_AUDIO

I2C3_SDA_M0_AUDIO

SDMMC1_D0_M0
SDMMC1_D1_M0
SDMMC1_D2_M0
SDMMC1_D3_M0
SDMMC1_CMD_M0
SDMMC1_CLK_M0
UART4_RTSN_M1
UART4_TX_M1
WIFI_REG_ON_H

UART4_CTSN_M1
UART4_RX_M1
BT_REG_ON_H
SAI2_SDO_M0
SAI2_SCLK_M0

LCD_PWREN_H

SAI2_LRCK_M0
SAI2_SDI_M0
HOST_WAKE_BT_H

C116
100nF

GND

VCCIO_WL

HDMI_TX_CEC_M0
HDMI_TX_HPDIN_M0
HDMI_TX_SCL
HDMI_TX_SDA
SPI4_CSN0_M0
SPI4_MOSI_M0
SPI4_MISO_M0
SPI4_CLK_M0

C117
100nF

VCC_3V3_S0

# RK3576 (VCCIO2)

# RK3576 (VCCIO3)

# RK3576 (VCCIO6)

## VCCIO4 Domain

# RK3576 (VCCIO4)

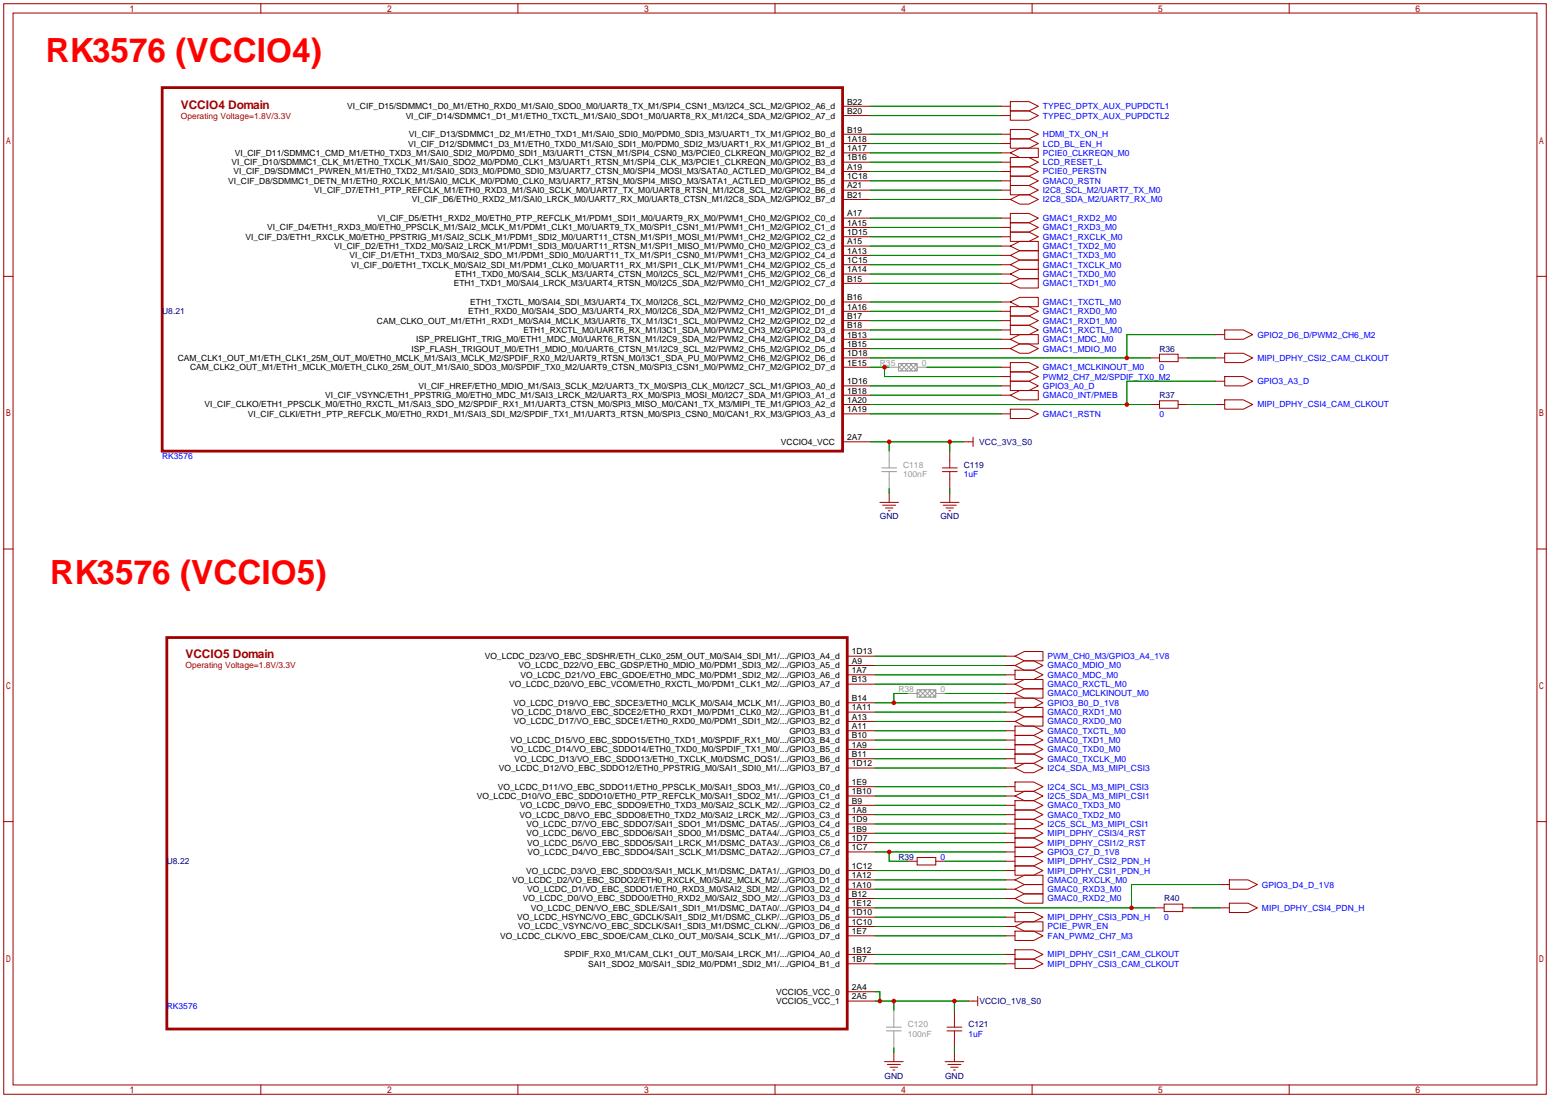
[picture p18: page 10]

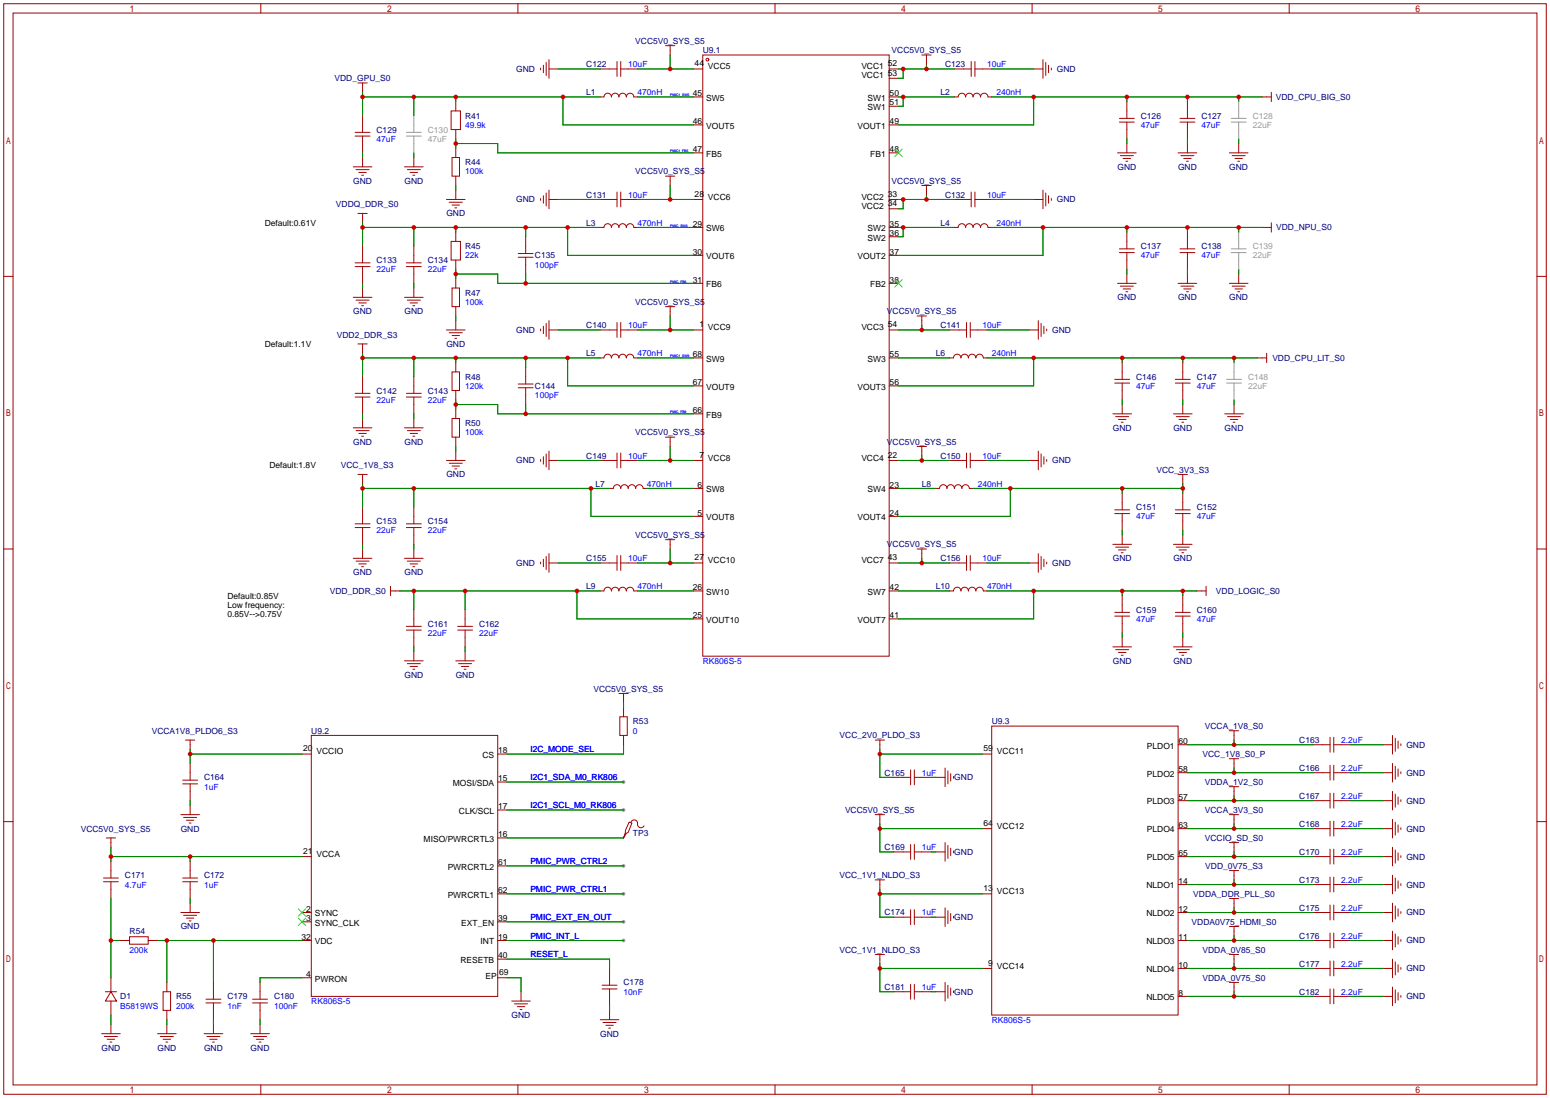
[picture p19: page 11]

VCC_2V0_PLDO_S3 | VCC_1V1_NLDO_S3

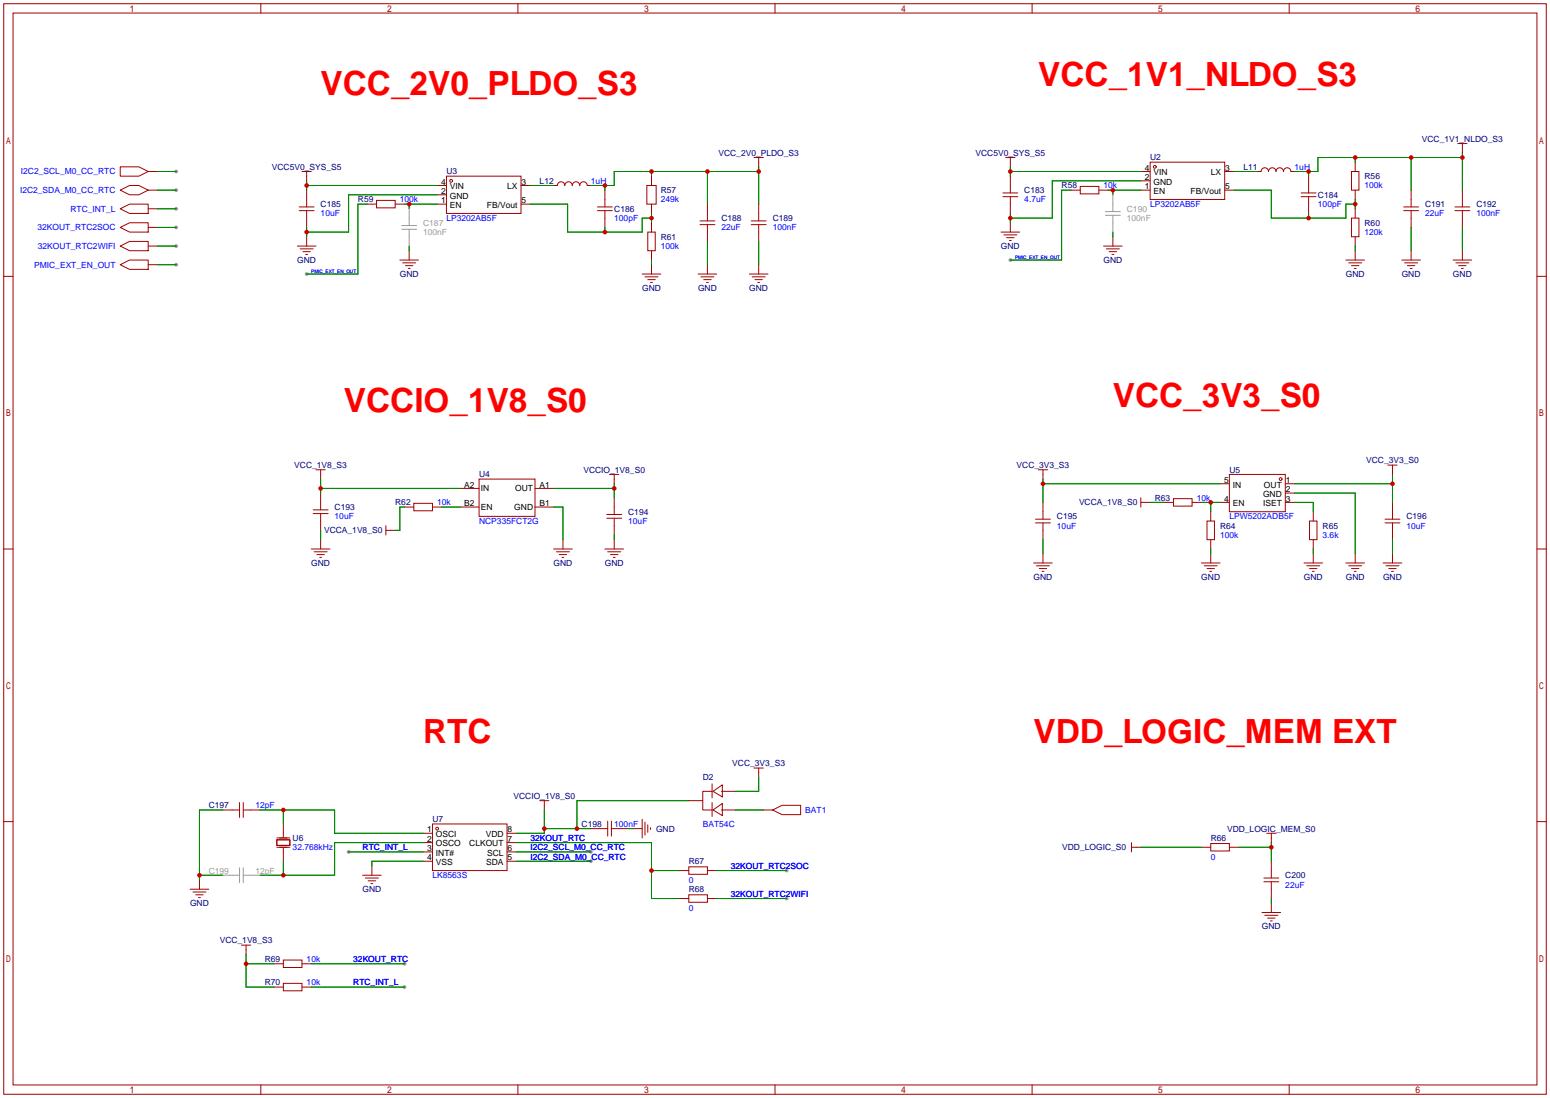
[picture p20: page 12]

# LPDDR4/4X

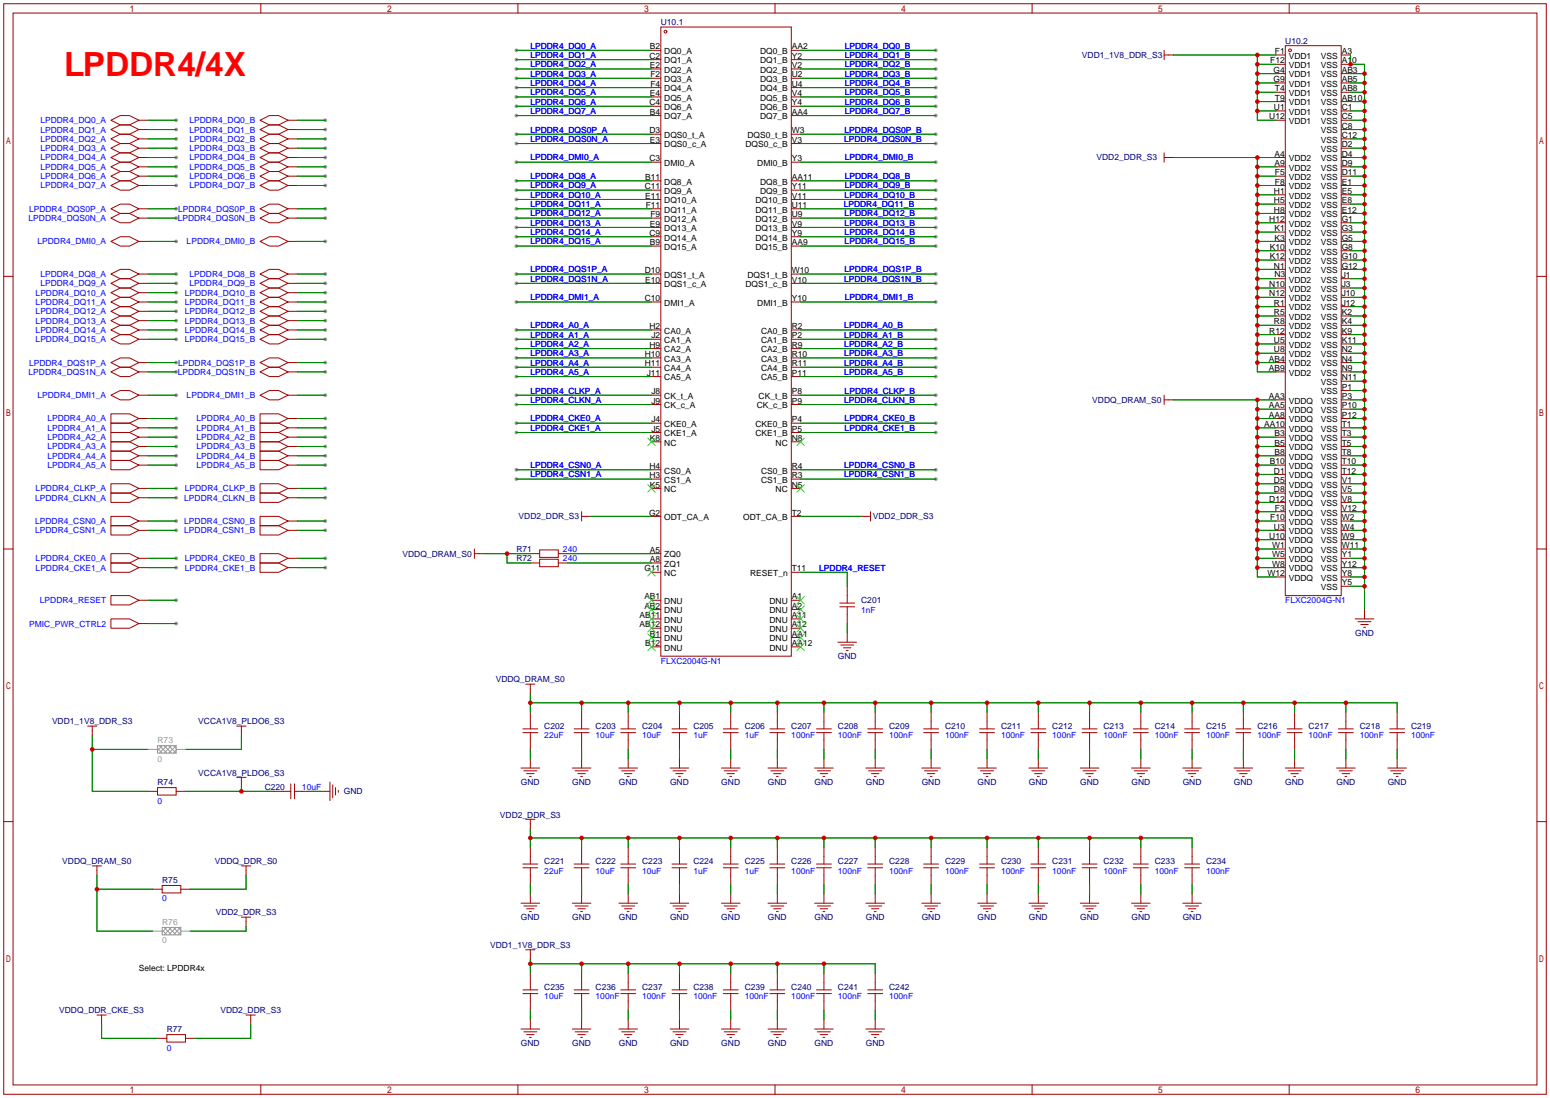
[picture p21: page 13]

DNU B12 DNU B1 DNU AB12 DNU AB11 DNU AB2 DNU AB1

DNU AA12 DNU AA1 DNU A12 DNU A11 DNU A2 DNU A1

# eMMC FLASH

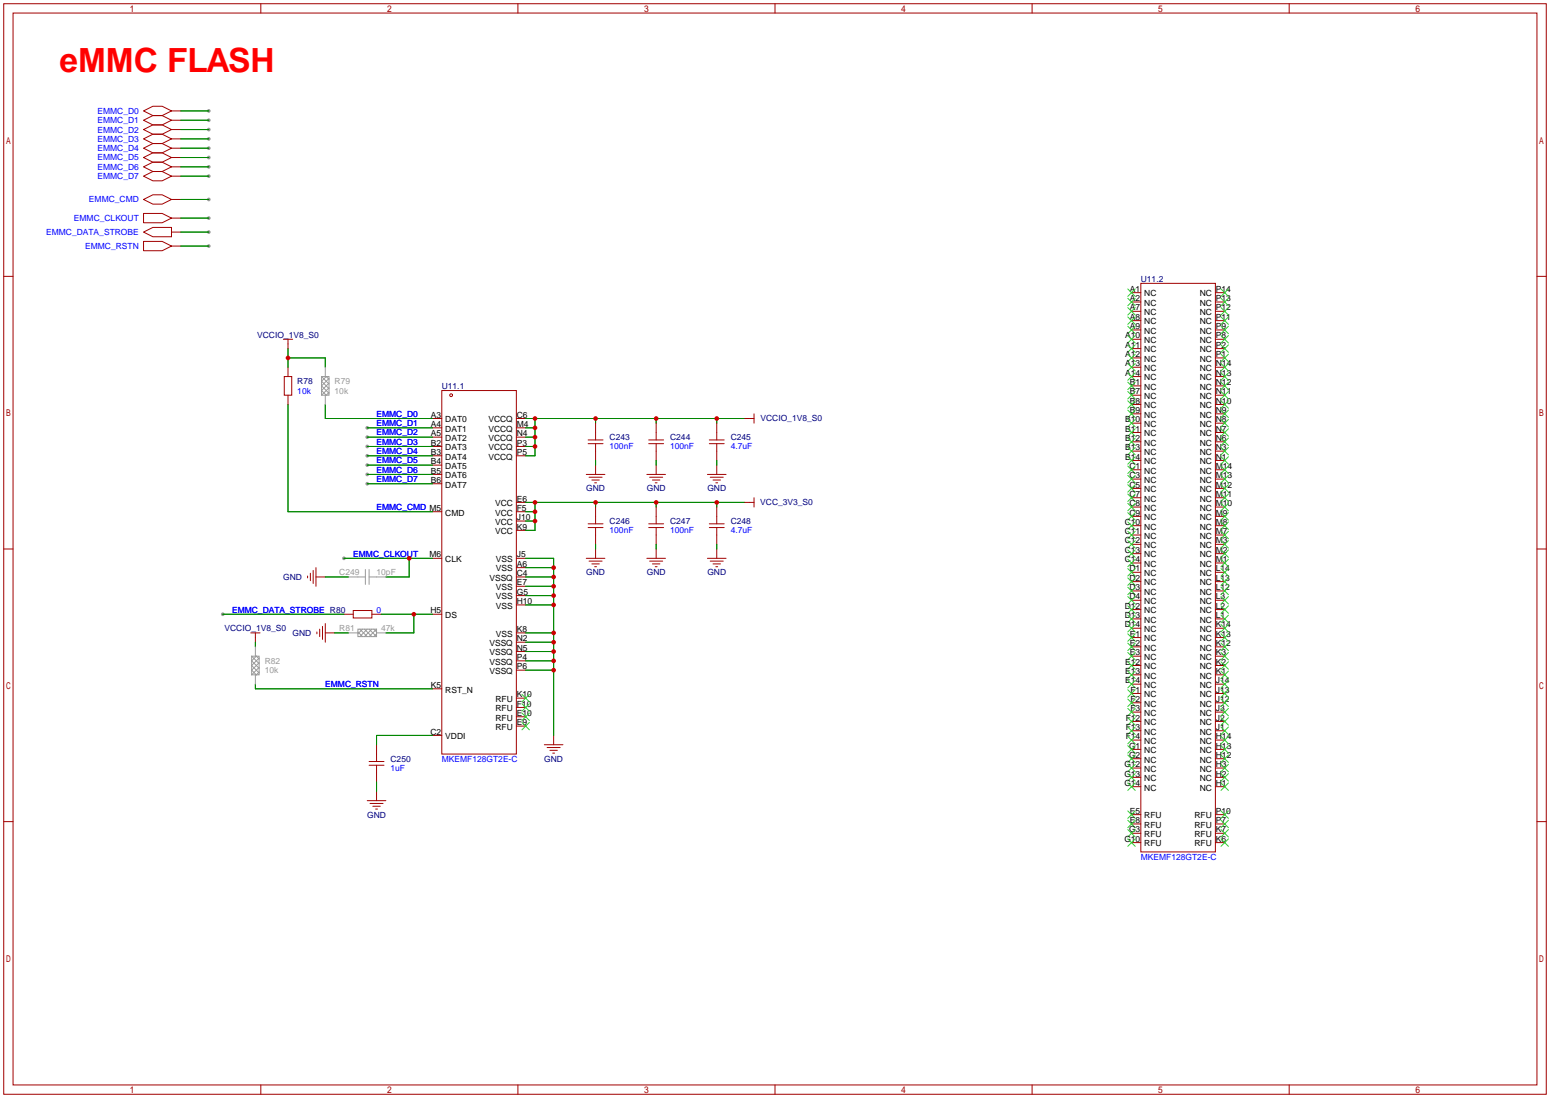
[picture p22: page 14]

50 50 51 51 52 52 53 53 54 54 55 55 56 56 57 57 58 58 59 59 60 60 61 61 62 62 63 63 64 64 65 65 66 66 67 67 68 68 69 69 70 70 71 71 72 72 73 73 74 74 75 75 76 76 77 77 78 78 79 79 80 80 81 81 82 82 83 83 84 84 85 85 86 86 87 87 88 88 89 89 90 90 91 91 92 92 93 93 94 94 95 95 96 96 97 97 98 98 99 99 100 100

# HDMI TX0

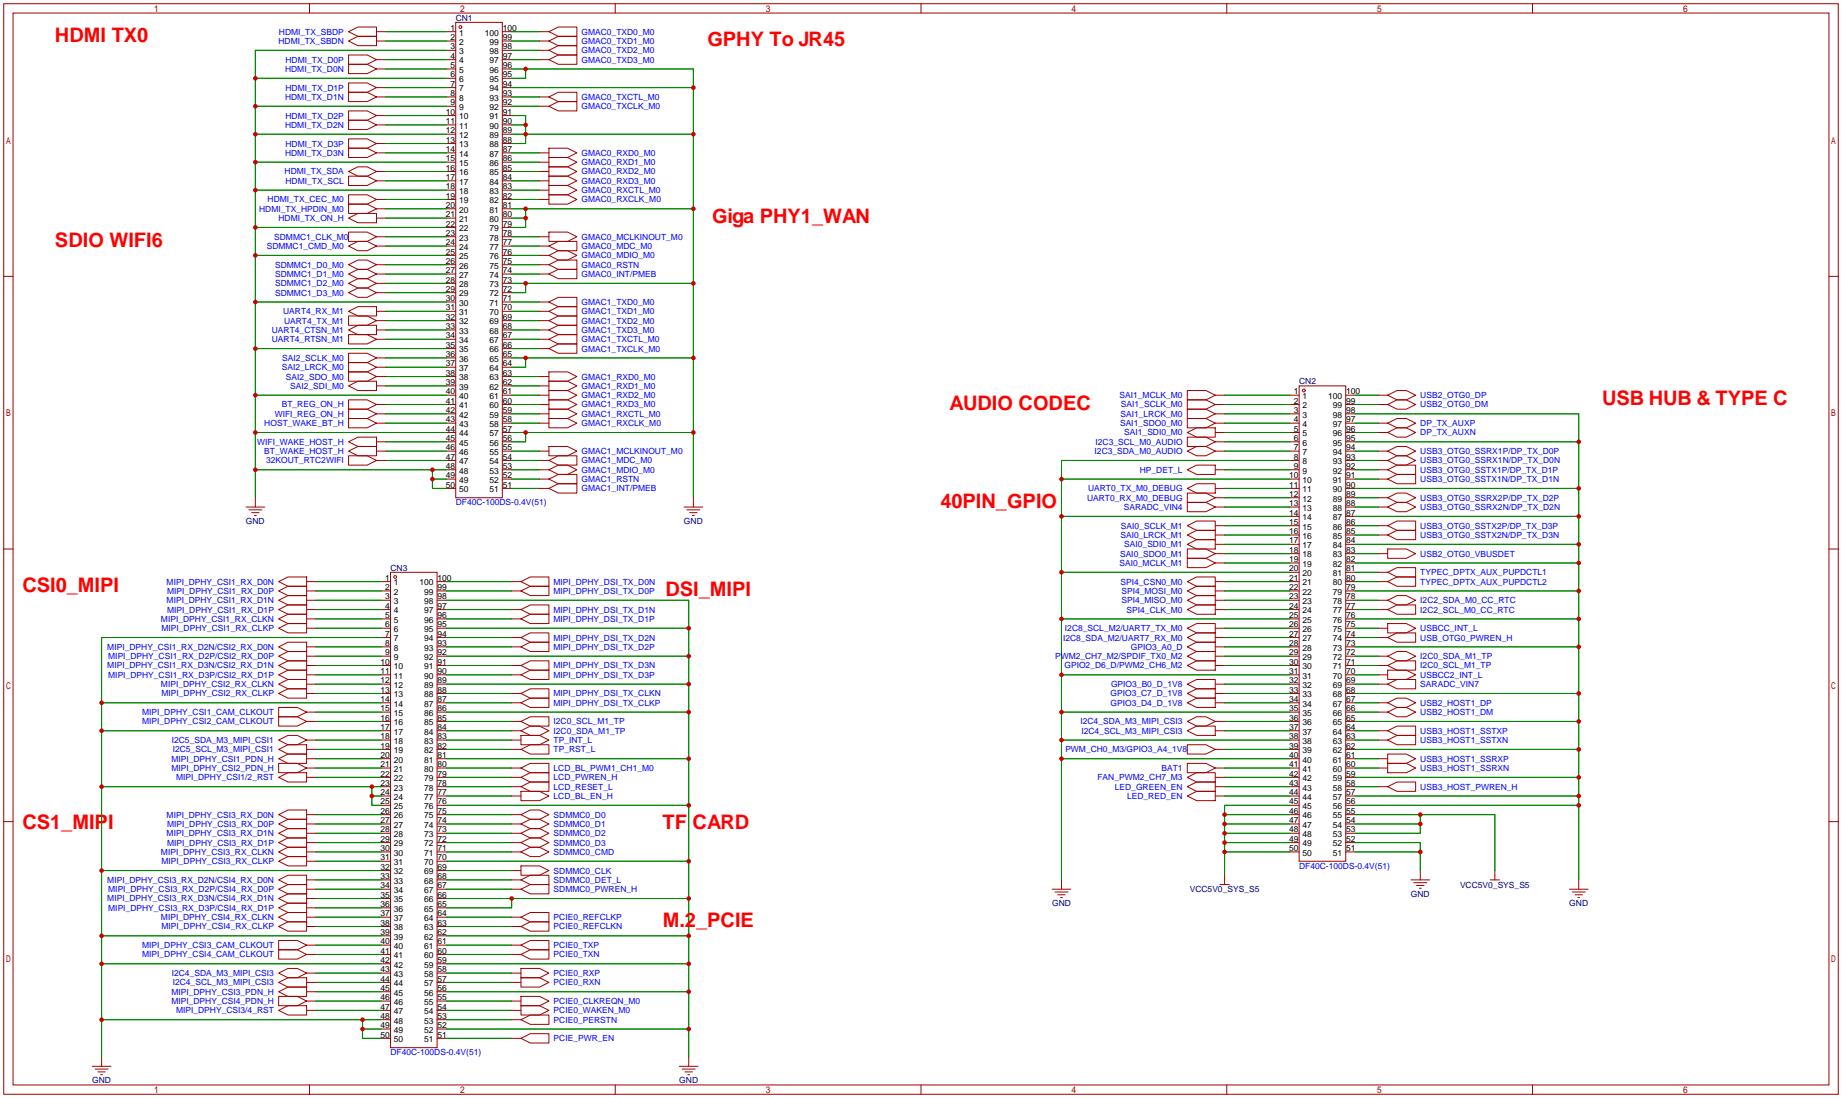
[picture p23: page 15]
