nilotpal-n7/NanoD1/Project Outputs for NanoD1/Assembly Assembly/BOM/Bill of Materials.PDF

Comment | Description | Designator | Footprint | LibRef | Quantity
100nF | CAPCER0.1UF16V
X7R0402

C1, C6, C7, C11, C12,
C18, C22, C24, C26,
C29, C30, C31, C32,
C35, C36, C38, C43,
C44, C53, C57, C61,
C62
FP-GRM15-MFG | CMP-2100-03641-2 | 22
1uF | CAPCER1UF10VX5R 0402 | C2, C3, C5, C13, C17, C50, C51, C59 | FP-GRM15-0_1-IPC_B | CMP-2008-04556-2 | 8
4.7uF | Chip Multilayer Ceramic Capacitors for General Purpose, 0402, 4.7uF, X5R, 15%, 20%, 10V | C4, C8, C14, C15, C52 | FP-GRM155-0_15-MFG | CMP-06035-003573-1 | 5
10uF | Chip Multilayer Ceramic Capacitors for General Purpose, 0603, 10uF, X5R, 15%, 20%, 10V | C9, C10, C16, C20, C21, C28, C33, C34, C37, C40, C42, C58, C60 | FP-GRM188-0_15-IPC_B | CMP-06035-003612-1 | 13
22uF | Chip Multilayer Ceramic Capacitors for General Purpose, 0805, 22uF, X5R, 15%, 20%, 10V | C41, C45, C47, C54 | FP-GRM21B-0_15-MFG | CMP-2000-06340-2 | 4
22uF | Chip Multilayer Ceramic Capacitors for General Purpose, 0603, 22uF, X5R, 15%, 20%, 10V | C46, C48, C49 | FP-GRM188-0_2-IPC_C | CMP-2000-06337-3 | 3
18pF | | C55, C56 | CAPC1005X55X25LL0 5T10 | CMP-2008-03918-1 | 2
USBLC6-2SC6 | 17VClamp5A (8/20Âµs) IppTvs DiodeSurface Mount SOT-23-6 | D1 | SOT95P280X145-6N | USBLC6-2SC6 | 1
U.FL-R-SMT-1(01) | UltraSmall Coaxial Connector, 6GHz, -40 to90degC, 3-Pin SMD, RoHS, Bulk | E1 | HRS-U.FL-R-SMT-3_V | CMP-2000-05153-1 | 1
600R@100MHz | 600Ohms@100MHz 1Power LineFerrite Bead0603(1608 Metric) 1A150mOhm | FB2, FB5 | INDC1608X95N | MPZ1608S601ATA00 | 2
USB4085-GF-A_REVA4 | USB-C(USBTYPE-C) USB2.0 Receptacle Connector 24(16+8 Dummy) Position ThroughHole, Right Angle, lowcost, 3.46mmprofile, 16 pin, horizontal, Top mount | J2 | GCT_USB4085-GF-A_REVA4 | USB4085-GF-A_REVA4 | 1
Header 4 | Header, 4-Pin | J3 | HDR1X4 | Header 4 | 1
Header 9 | Header, 9-Pin | J4 | HDR1X9 | Header 9 | 1
Header 10 | Header, 10-Pin | J5A, J5B | HDR1X10 | Header 10 | 2
B2B-PH-K-S(LF)(SN) | Male Header, Pitch 2 mm, 1x2Position, Height 6mm, Tail Length3.4 mm, -25to 85degC, RoHS, Bulk | J6 | JST-B2B-PH-K-S_V | CMP-2000-05162-1 | 1
2.2uH2A | Inductor | L1, L3 | FP-DFE252010C-MFG | Inductor | 2
1.0uH4A | Inductor | L2 | FP-DFE252010C-MFG | Inductor | 1
4.7uH | ShieldedWirewound Inductor 4.7uH 1100mA0.27Ω1008 (2520) | L4 | FP-DFE252010C-MFG | CMP-06042-014898-1 | 1
KP-1608SGC | KP-1608SGCGreen LED, 568nm1608 (0603), Rectangle LensSMDpackage | LED1, LED2 | LED_KP-1608SGC | KP-1608SGC | 2
22R | | R1, R8, R18 | FP-RC0402-0_4-IPC_A | CMP-2002-07520-2 | 3
10K | | R2, R3, R4, R5, R6, R19, R20, R21, R22, R23, R24, R25, R52 | RESC1005X40X25ML0 5T10 | CMP-2002-07353-1 | 13
10K1% | | R7, R17 | RESC1005X40X25ML0 5T10 | CMP-2002-07353-1 | 2
4.7K | | R9, R10, R11, R12, R15 | RESC1005X40X25ML0 5T10 | CMP-1011-00586-2 | 5
30K1% | | R16 | RESC1005X40X25ML0 5T10 | CMP-2002-07602-1 | 1
5K1 | | R37, R38 | RESC1005X40X25ML0 5T10 | CMP-2002-07753-1 | 2
5R1 | | R39, R40 | RESC1005X40X25ML0 5T10 | CMP-2002-07068-1 | 2
100K | | R41, R57 | RESC1005X40X25ML0 5T10 | CMP-2002-07343-1 | 2
47K | | R42 | RESC1005X40X25ML0 5T10 | CMP-2002-07701-1 | 1
1M | | R43 | RESC1005X40X25ML0 5T10 | CMP-2002-07490-1 | 1
100K1% | | R44 | RESC1005X40X25ML0 5T10 | CMP-2002-07343-1 | 1
22K61% | | R45 | RESC1005X40X25ML0 5T10 | CMP-2002-07516-1 | 1
11K81% | | R46 | FP-RC0402-0_4-MFG | CMP-2002-07909-2 | 1
20K1% | | R47 | FP-RC0402-0_4-MFG | CMP-2002-07501-2 | 1
15K1% | | R48 | RESC1005X40X25ML0 5T10 | CMP-2002-07410-1 | 1
12K1% | RESSMD12KOHM1% 1/16W0402 | R49 | FP-RC0402-0_4-MFG | CMP-2002-07378-2 | 1
33K | | R50, R51 | RESC1005X40X25ML0 5T10 | CMP-2002-07617-1 | 2
2K | RESSMD2KOHM1% 1/16W0402 | R53 | FP-RC_L0402-IPC_A | CMP-2002-07580-2 | 1
1K | RES1KOHM1% 1/16W0402 | R54 | FP-RC0402-0_4-MFG | CMP-2002-07472-3 | 1
300K | | R55 | RESC1005X40X25ML0 5T10 | CMP-2002-07008-1 | 1
0R | | R60 | RESC1005X40X25ML0 5T10 | CMP-1011-00001-2 | 1
Reset | EVQ-P2002MSwitch Tactile N.O. SPST ButtonJ-Bend0.02A 15VDC1NSMD AutomotiveEmbossed T/R | SW1 | FP-EVQ-P2002M-MFG | CMP-00287-40010164-1 | 1
Boot | EVQ-P2002MSwitch Tactile N.O. SPST ButtonJ-Bend0.02A 15VDC1NSMD AutomotiveEmbossed T/R | SW2 | FP-EVQ-P2002M-MFG | CMP-00287-40010164-1 | 1
TP | Test point, 1.5 mm exposedpad | TP1, TP2, TP3, TP4, TP5, TP6, TP7, TP8 | TP-1.5mm | TestPoint | 8
SG2002 | RISC-VC906/ Cortex-A53SoC, 256MBDDR3 SiP, QFN889x9 0.35mm | U1 | QFN88-9x9-0.35 | SG2002 | 1
DM3AT-SF-PEJM5(40) | CONNMICROSDR/A PUSH-PUSHSMD | U2 | FP-DM3AT-SF-PEJM5_40-MFG | CMP-11597-000006-1 | 1
W25Q128JVSIM_TR | FLASH- NORMemory IC128Mb(16Mx8) SPI - QuadI/O, QPI, DTR 133MHz8-SOIC | U3 | SOIC127P790X216-8N | W25Q128JVSIM_TR | 1
AP6212 | | U4 | AP6212-12x12 | AP6212 | 1
ETA3414S2F | 1.5A3MHz synchronous step-downconverter, SOT23-5 | U5, U6, U7 | SOT23-5 | ETA3414 | 3
ETA5050V18S2F | 1.8VfixedLDO, SOT23-5 | U8 | SOT23-5 | ETA5050V18 | 1
MAX98357AETE+T | Tiny, Low-Cost, PCM ClassDAmplifier with ClassABPerformance | U9 | QFN50P300X300X80-17N | MAX98357AETE+T | 1
INMP441ACEZ-R7 | 60Hz~15kHzDigital, I2SMicrophoneMEMS (Silicon) 1.62V~3.63 VOmnidirectional (-26dBÂ±3dB@94dB SPL) Solder Pads | U10 | MIC_INMP441ACEZ-R7 | INMP441ACEZ-R7 | 1
TSX-3225_25.0000MF20X-W | | Y1 | XTAL_TSX-3225_25.0000MF20X-W | TSX-3225_25.0000MF20X-W | 1
