nilotpal-n7/NanoD1/SBC/claude-gen/bom-corrected.csv

Designator | Value | Package | Footprint | MPN | Fitted | Height | Block | Status | Note
C1 | 100nF | 0402 | FP-GRM15-MFG | GRM155R71C104KA88D | Fitted |  |  | on board | X7R 16V
C2 | 1uF | 0402 | FP-GRM15-0_1-IPC_B | GRM155R61A105KE15D | Fitted |  |  | on board | X5R 10V
C3 | 1uF | 0402 | FP-GRM15-0_1-IPC_B | GRM155R61A105KE15D | Fitted |  |  | on board | X5R 10V
C4 | 4.7uF | 0402 | FP-GRM155-0_15-MFG | GRM155R61A475MEAAD | Fitted |  |  | on board | X5R 10V
C5 | 1uF | 0402 | FP-GRM15-0_1-IPC_B | GRM155R61A105KE15D | Fitted |  |  | on board | X5R 10V
C6 | 100nF | 0402 | FP-GRM15-MFG | GRM155R71C104KA88D | Fitted |  |  | on board | X7R 16V
C7 | 100nF | 0402 | FP-GRM15-MFG | GRM155R71C104KA88D | Fitted |  |  | on board | X7R 16V
C8 | 4.7uF | 0402 | FP-GRM155-0_15-MFG | GRM155R61A475MEAAD | Fitted |  |  | on board | X5R 10V
C9 | 10uF | 0603 | FP-GRM188-0_15-IPC_B | GRM188R61A106ME69D | Fitted |  |  | on board | X5R 10V
C10 | 10uF | 0603 | FP-GRM188-0_15-IPC_B | GRM188R61A106ME69D | Fitted |  |  | on board | X5R 10V
C11 | 100nF | 0402 | FP-GRM15-MFG | GRM155R71C104KA88D | Fitted |  |  | on board | X7R 16V
C12 | 100nF | 0402 | FP-GRM15-MFG | GRM155R71C104KA88D | Fitted |  |  | on board | X7R 16V
C13 | 1uF | 0402 | FP-GRM15-0_1-IPC_B | GRM155R61A105KE15D | Fitted |  |  | on board | X5R 10V
C14 | 4.7uF | 0402 | FP-GRM155-0_15-MFG | GRM155R61A475MEAAD | Fitted |  |  | on board | X5R 10V
C15 | 4.7uF | 0402 | FP-GRM155-0_15-MFG | GRM155R61A475MEAAD | Fitted |  |  | on board | X5R 10V
C16 | 10uF | 0603 | FP-GRM188-0_15-IPC_B | GRM188R61A106ME69D | Fitted |  |  | on board | X5R 10V
C17 | 1uF | 0402 | FP-GRM15-0_1-IPC_B | GRM155R61A105KE15D | Fitted |  |  | on board | X5R 10V
C18 | 100nF | 0402 | FP-GRM15-MFG | GRM155R71C104KA88D | Fitted |  |  | on board | X7R 16V
C20 | 10uF | 0603 | FP-GRM188-0_15-IPC_B | GRM188R61A106ME69D | Fitted |  |  | on board | X5R 10V
C21 | 10uF | 0603 | FP-GRM188-0_15-IPC_B | GRM188R61A106ME69D | Fitted |  |  | on board | X5R 10V
C22 | 100nF | 0402 | FP-GRM15-MFG | GRM155R71C104KA88D | Fitted |  |  | on board | X7R 16V
C24 | 100nF | 0402 | FP-GRM15-MFG | GRM155R71C104KA88D | Fitted |  |  | on board | X7R 16V
C26 | 100nF | 0402 | FP-GRM15-MFG | GRM155R71C104KA88D | Fitted |  |  | on board | X7R 16V
C28 | 10uF | 0603 | FP-GRM188-0_15-IPC_B | GRM188R61A106ME69D | Fitted |  |  | on board | X5R 10V
C29 | 100nF | 0402 | FP-GRM15-MFG | GRM155R71C104KA88D | Fitted |  |  | on board | X7R 16V
C30 | 100nF | 0402 | FP-GRM15-MFG | GRM155R71C104KA88D | Fitted |  |  | on board | X7R 16V
C31 | 100nF | 0402 | FP-GRM15-MFG | GRM155R71C104KA88D | Fitted |  |  | on board | X7R 16V
C32 | 100nF | 0402 | FP-GRM15-MFG | GRM155R71C104KA88D | Fitted |  |  | on board | X7R 16V
C33 | 10uF | 0603 | FP-GRM188-0_15-IPC_B | GRM188R61A106ME69D | Fitted |  |  | on board | X5R 10V
C34 | 10uF | 0603 | FP-GRM188-0_15-IPC_B | GRM188R61A106ME69D | Fitted |  |  | on board | X5R 10V
C35 | 100nF | 0402 | FP-GRM15-MFG | GRM155R71C104KA88D | Fitted |  |  | on board | X7R 16V
C36 | 100nF | 0402 | FP-GRM15-MFG | GRM155R71C104KA88D | Fitted |  |  | on board | X7R 16V
C37 | 10uF | 0603 | FP-GRM188-0_15-IPC_B | GRM188R61A106ME69D | Fitted |  |  | on board | X5R 10V
C38 | 100nF | 0402 | FP-GRM15-MFG | GRM155R71C104KA88D | Fitted |  |  | on board | X7R 16V
C40 | 10uF | 0603 | FP-GRM188-0_15-IPC_B | GRM188R61A106ME69D | Fitted |  |  | on board | X5R 10V
C41 | 22uF | 0805 | FP-GRM21B-0_15-MFG | GRM21BR61A226ME51L | Fitted |  |  | on board | X5R 10V
C42 | 10uF | 0603 | FP-GRM188-0_15-IPC_B | GRM188R61A106ME69D | Fitted |  |  | on board | X5R 10V
C43 | 100nF | 0402 | FP-GRM15-MFG | GRM155R71C104KA88D | Fitted |  |  | on board | X7R 16V
C44 | 100nF | 0402 | FP-GRM15-MFG | GRM155R71C104KA88D | Fitted |  |  | on board | X7R 16V
C45 | 22uF | 0805 | FP-GRM21B-0_15-MFG | GRM21BR61A226ME51L | Fitted |  |  | on board | X5R 10V
C46 | 22uF | 0603 | FP-GRM188-0_2-IPC_C | GRM188R61A226ME15D | Fitted |  |  | on board | X5R 10V
C47 | 22uF | 0805 | FP-GRM21B-0_15-MFG | GRM21BR61A226ME51L | Fitted |  |  | on board | X5R 10V
C48 | 22uF | 0603 | FP-GRM188-0_2-IPC_C | GRM188R61A226ME15D | Fitted |  |  | on board | X5R 10V
C49 | 22uF | 0603 | FP-GRM188-0_2-IPC_C | GRM188R61A226ME15D | Fitted |  |  | on board | X5R 10V
C50 | 1uF | 0402 | FP-GRM15-0_1-IPC_B | GRM155R61A105KE15D | Fitted |  |  | on board | X5R 10V
C51 | 1uF | 0402 | FP-GRM15-0_1-IPC_B | GRM155R61A105KE15D | Fitted |  |  | on board | X5R 10V
C52 | 4.7uF | 0402 | FP-GRM155-0_15-MFG | GRM155R61A475MEAAD | Fitted |  |  | on board | X5R 10V
C53 | 100nF | 0402 | FP-GRM15-MFG | GRM155R71C104KA88D | Fitted |  |  | on board | X7R 16V
C54 | 22uF | 0805 | FP-GRM21B-0_15-MFG | GRM21BR61A226ME51L | Fitted |  |  | on board | X5R 10V
C55 | 18pF | 0402 | CAPC1005X55X25LL05T10 | GRM1555C1H180JA01D | Fitted | 0.55 |  | on board | C0G/NP0 — must not be X7R
C56 | 18pF | 0402 | CAPC1005X55X25LL05T10 | GRM1555C1H180JA01D | Fitted | 0.55 |  | on board | C0G/NP0 — must not be X7R
C57 | 100nF | 0402 | FP-GRM15-MFG | GRM155R71C104KA88D | Fitted |  |  | on board | X7R 16V
C58 | 10uF | 0603 | FP-GRM188-0_15-IPC_B | GRM188R61A106ME69D | Fitted |  |  | on board | X5R 10V
C59 | 1uF | 0402 | FP-GRM15-0_1-IPC_B | GRM155R61A105KE15D | Fitted |  |  | on board | X5R 10V
C60 | 10uF | 0603 | C0603 | GRM188R61A106ME69D | Fitted |  | Audio | NOT YET PLACED | Amp VDD bulk, at pins 7/8. 0603 reuses a part already in the BOM
C61 | 100nF | 0402 | C0402 | GRM155R71C104KA88D | Fitted |  | Audio | NOT YET PLACED | Amp VDD, at the pin
C62 | 100nF | 0402 | C0402 | GRM155R71C104KA88D | Fitted |  | Audio | NOT YET PLACED | Mic VDD bypass — datasheet asks for pin 7 decoupled to PIN 6 specifically
D1 | USBLC6-2SC6 | SOT23-6 | SOT95P280X145-6N | USBLC6-2SC6 | Fitted |  |  | on board
E1 | U.FL-R-SMT-1(01) | U.FL | HRS-U.FL-R-SMT-3_V | U.FL-R-SMT-1(01) | Fitted | 1.25 | Wireless | on board | WiFi antenna connector
FB2 | 600R@100MHz | 0603 | INDC1608X95N | MPZ1608S601ATA00 | Fitted |  |  | on board
FB5 | 600R@100MHz | 0603 | INDC1608X95N | MPZ1608S601ATA00 | Fitted |  |  | on board
J2 | USB4085-GF-A | USB-C 24P | GCT_USB4085-GF-A_REVA4 | USB4085-GF-A | Fitted | 3.46 | USB | on board | USB 2.0 receptacle, sink only, no PD
J3 | Header 4 | 2.54mm 1x4 | HDR1X4 | HDR1X4 | Fitted |  | Debug | on board | UART0: GND / TX / RX / 3V3, square pad on pin 1
J4 | Header 9 | 2.54mm 1x9 | HDR1X9 | HDR1X9 | Fitted |  | IO | on board | Was P4. Renamed — confirm this was intentional
J6 | JST-PH 2-pin | PH 2.0mm | TO BE ADDED | B2B-PH-K-S | Fitted |  | Audio | NOT YET PLACED | Speaker. >=2 vias on the amp-to-connector run
L1 | 2.2uH 2A | 2520 | FP-DFE252010C-MFG | WPN252012H2R2MT | Fitted |  |  | on board
L2 | 1.0uH 4A | 2520 | FP-DFE252010C-MFG | WPN252012H1R0MT | Fitted |  |  | on board
L3 | 2.2uH 2A | 2520 | FP-DFE252010C-MFG | WPN252012H2R2MT | Fitted |  |  | on board
L4 | 4.7uH | 2520 | FP-DFE252010C-MFG | DFE252010P-4R7M | Fitted |  |  | on board | AP6212 internal buck
LED1 | green | 0603 | LED_KP-1608SGC | KP-1608SGC | Fitted | 1.10 |  | on board
LED2 | green | 0603 | LED_KP-1608SGC | KP-1608SGC | Fitted | 1.10 |  | on board
R1 | 22R | 0402 | FP-RC0402-0_4-IPC_A | RC0402FR-0722RL | Fitted |  |  | on board
R2 | 10k | 0402 | RESC1005X40X25ML05T10 | RC0402FR-0710KL | Fitted | 0.40 |  | on board
R3 | 10k | 0402 | RESC1005X40X25ML05T10 | RC0402FR-0710KL | Fitted | 0.40 |  | on board
R4 | 10k | 0402 | RESC1005X40X25ML05T10 | RC0402FR-0710KL | Fitted | 0.40 |  | on board
R5 | 10k | 0402 | RESC1005X40X25ML05T10 | RC0402FR-0710KL | Fitted | 0.40 |  | on board
R6 | 10k | 0402 | RESC1005X40X25ML05T10 | RC0402FR-0710KL | Fitted | 0.40 |  | on board
R7 | 10k | 0402 | RESC1005X40X25ML05T10 | RC0402FR-0710KL | Fitted | 0.40 |  | on board
R8 | 22R | 0402 | FP-RC0402-0_4-IPC_A | RC0402FR-0722RL | Fitted |  |  | on board
R9 | 4.7k | 0402 | RESC1005X40X25ML05T10 | RC0402FR-074K7L | Fitted | 0.40 |  | on board
R10 | 4.7k | 0402 | RESC1005X40X25ML05T10 | RC0402FR-074K7L | Fitted | 0.40 |  | on board
R11 | 4.7k | 0402 | RESC1005X40X25ML05T10 | RC0402FR-074K7L | Fitted | 0.40 |  | on board
R12 | 4.7k | 0402 | RESC1005X40X25ML05T10 | RC0402FR-074K7L | Fitted | 0.40 |  | on board
R13 | 4.7k | 0402 | RESC1005X40X25ML05T10 | RC0402FR-074K7L | NotFitted | 0.40 |  | on board | boot strap — footprint only
R14 | 4.7k | 0402 | RESC1005X40X25ML05T10 | RC0402FR-074K7L | NotFitted | 0.40 |  | on board | boot strap — footprint only
R15 | 4.7k | 0402 | RESC1005X40X25ML05T10 | RC0402FR-074K7L | Fitted | 0.40 |  | on board
R16 | 30k 1% | 0402 | RESC1005X40X25ML05T10 | RC0402FR-0730KL | Fitted | 0.40 |  | on board | VBAT divider upper
R17 | 10k 1% | 0402 | RESC1005X40X25ML05T10 | RC0402FR-0710KL | Fitted | 0.40 |  | on board | VBAT divider lower
R18 | 22R | 0402 | FP-RC0402-0_4-IPC_A | RC0402FR-0722RL | Fitted |  |  | on board
R19 | 10k | 0402 | RESC1005X40X25ML05T10 | RC0402FR-0710KL | Fitted | 0.40 |  | on board
R20 | 10k | 0402 | RESC1005X40X25ML05T10 | RC0402FR-0710KL | Fitted | 0.40 |  | on board
R21 | 10k | 0402 | RESC1005X40X25ML05T10 | RC0402FR-0710KL | Fitted | 0.40 |  | on board
R22 | 10k | 0402 | RESC1005X40X25ML05T10 | RC0402FR-0710KL | Fitted | 0.40 |  | on board
R23 | 10k | 0402 | RESC1005X40X25ML05T10 | RC0402FR-0710KL | Fitted | 0.40 |  | on board
R24 | 10k | 0402 | RESC1005X40X25ML05T10 | RC0402FR-0710KL | Fitted | 0.40 |  | on board
R25 | 10k | 0402 | RESC1005X40X25ML05T10 | RC0402FR-0710KL | Fitted | 0.40 |  | on board
R37 | 5k1 | 0402 | RESC1005X40X25ML05T10 | RC0402FR-075K1L | Fitted | 0.40 |  | on board
R38 | 5k1 | 0402 | RESC1005X40X25ML05T10 | RC0402FR-075K1L | Fitted | 0.40 |  | on board
R39 | 5R1 | 0402 | RESC1005X40X25ML05T10 | RC0402FR-075R1L | Fitted | 0.40 |  | on board
R40 | 5R1 | 0402 | RESC1005X40X25ML05T10 | RC0402FR-075R1L | Fitted | 0.40 |  | on board
R41 | 100k | 0402 | RESC1005X40X25ML05T10 | RC0402FR-07100KL | Fitted | 0.40 |  | on board
R42 | 47k | 0402 | RESC1005X40X25ML05T10 | RC0402FR-0747KL | Fitted | 0.40 |  | on board
R43 | 1M | 0402 | RESC1005X40X25ML05T10 | RC0402FR-071ML | Fitted | 0.40 |  | on board
R44 | 100k 1% | 0402 | RESC1005X40X25ML05T10 | RC0402FR-07100KL | Fitted | 0.40 |  | on board | 3V3 FB upper
R45 | 22k6 1% | 0402 | RESC1005X40X25ML05T10 | RC0402FR-0722K6L | Fitted | 0.40 |  | on board | 3V3 FB lower
R46 | 11k8 1% | 0402 | FP-RC0402-0_4-MFG | RC0402FR-0711K8L | Fitted |  |  | on board | CORE FB upper — sets 0.954V
R47 | 20k 1% | 0402 | FP-RC0402-0_4-MFG | RC0402FR-0720KL | Fitted |  |  | on board | CORE FB lower
R48 | 15k 1% | 0402 | RESC1005X40X25ML05T10 | RC0402FR-0715KL | Fitted | 0.40 |  | on board | 1V35 FB upper
R49 | 12k 1% | 0402 | FP-RC0402-0_4-MFG | RC0402FR-0712KL | Fitted |  |  | on board | 1V35 FB lower
R50 | 33k | 0402 | RESC1005X40X25ML05T10 | RC0402FR-0733KL | Fitted | 0.40 |  | on board | RC soft-start
R51 | 33k | 0402 | RESC1005X40X25ML05T10 | RC0402FR-0733KL | Fitted | 0.40 |  | on board | RC soft-start
R52 | 10k | 0402 | RESC1005X40X25ML05T10 | RC0402FR-0710KL | Fitted | 0.40 |  | on board
R53 | 2k | 0402 | FP-RC_L0402-IPC_A | RC0402FR-072KL | Fitted |  |  | on board
R54 | 1k | 0402 | FP-RC0402-0_4-MFG | RC0402FR-071KL | Fitted |  |  | on board
R55 | 300k | 0402 | R0402 | RC0402FR-07300KL | Fitted |  | Audio | NOT YET PLACED | SD_MODE pull-up to pin 48 = (L/2+R/2) mono downmix. 69k8 would give right channel only
R56 | 100k | 0402 | R0402 | RC0402FR-07100KL | NotFitted |  | Audio | NOT YET PLACED | GAIN_SLOT to GND. DNP = 9dB. Populated = 15dB
R57 | 100k | 0402 | R0402 | RC0402FR-07100KL | Fitted |  | Audio | NOT YET PLACED | Pull-down on I2S_DIN. Required by the INMP441 datasheet: SD tri-states when not driving
R58 | 22R | 0402 | R0402 | RC0402FR-0722RL | NotFitted |  | Audio | NOT YET PLACED | Series on I2S_BCLK near the SoC. DNP
R59 | 22R | 0402 | R0402 | RC0402FR-0722RL | NotFitted |  | Audio | NOT YET PLACED | Series on I2S_LRCK near the SoC. DNP
R60 | 0R | 0402 | R0402 | RC0402JR-070RL | Fitted |  | Audio | NOT YET PLACED | INMP441 CHIPEN (pin 8) tie to VDD1V8. NOT optional — low or floating = mic in power-down. 0R keeps the option of jumpering to SoC pin 49 later
SW1 | Reset | EVQ-P2002M | FP-EVQ-P2002M-MFG | EVQ-P2002M | Fitted |  | Control | on board | Tactile SPST
SW2 | Boot | EVQ-P2002M | FP-EVQ-P2002M-MFG | EVQ-P2002M | Fitted |  | Control | on board | Tactile SPST
TP1 | TP | 1.5mm pad | TP-1.5MM | — | Fitted |  | Test | on board | Rail test point — see 05-signoff-checklist D6
TP2 | TP | 1.5mm pad | TP-1.5MM | — | Fitted |  | Test | on board | Rail test point — see 05-signoff-checklist D6
TP3 | TP | 1.5mm pad | TP-1.5MM | — | Fitted |  | Test | on board | Rail test point — see 05-signoff-checklist D6
TP4 | TP | 1.5mm pad | TP-1.5MM | — | Fitted |  | Test | on board | Rail test point — see 05-signoff-checklist D6
TP5 | TP | 1.5mm pad | TP-1.5MM | — | Fitted |  | Test | on board | Rail test point — see 05-signoff-checklist D6
TP6 | TP | 1.5mm pad | TP-1.5MM | — | Fitted |  | Test | on board | Rail test point — see 05-signoff-checklist D6
TP7 | TP | 1.5mm pad | TP-1.5MM | — | Fitted |  | Test | on board | Rail test point — see 05-signoff-checklist D6
TP8 | TP | 1.5mm pad | TP-1.5MM | — | Fitted |  | Test | on board | Rail test point — see 05-signoff-checklist D6
U1 | SG2002 | QFN88 9x9 | QFN88-9X9-0.35 | SG2002 | Fitted | 0.90 | SoC | on board | RISC-V C906 / Cortex-A53, 256MB DDR3 SiP
U2 | DM3AT-SF-PEJM5(40) | microSD R/A | FP-DM3AT-SF-PEJM5_40-MFG | DM3AT-SF-PEJM5(40) | Fitted |  | Storage | on board | Hirose push-push, right-angle
U3 | W25Q128JVSIM_TR | SOIC-8 208mil | SOIC127P790X216-8N | W25Q128JVSIM_TR | Fitted | 2.16 | Storage | on board | MUST be the (1T) die per Sophgo flash support list — check the suffix
U4 | AP6212 | LGA 12x12 | AP6212-12X12 | AP6212 | Fitted |  | Wireless | on board | Only SDIO module on the validated list with a mainline driver
U5 | ETA3414S2F | SOT23-5 | SOT23-5 | ETA3414S2F | Fitted | 1.25 |  | on board
U6 | ETA3414S2F | SOT23-5 | SOT23-5 | ETA3414S2F | Fitted | 1.25 |  | on board
U7 | ETA3414S2F | SOT23-5 | SOT23-5 | ETA3414S2F | Fitted | 1.25 |  | on board
U8 | ETA5050V18S2F | SOT23-5 | SOT23-5 | ETA5050V18S2F | Fitted | 1.25 |  | on board
U9 | MAX98357A | TQFN 3x3 | TO BE ADDED | MAX98357AETE+T | Fitted |  | Audio | NOT YET PLACED | I2S class-D amp on VDD3V3. NOT the 1.345x1.435mm WLP
U10 | INMP441 | 6-pin bottom-port | TO BE ADDED | INMP441 | Fitted |  | Audio | NOT YET PLACED | MUST be on VDD1V8 - VIH is 0.7xVDD. Bottom port: needs an acoustic hole
Y1 | 25MHz | 3225 | XTAL_TSX-3225_25.0000MF20X-W | TSX-3225_25.0000MF20X-W | Fitted | 0.60 | Clock | on board | <+/-30ppm, 4-pad, both GND pads bonded
