nilotpal-n7/NanoD1/SBC/cadence-imports/Imported SG2002_QFN88_38_20230301_4L_V1.3_16.2.PrjPcb/Project Outputs for SG2002_QFN88_38_20230301_4L_V1.3_16.2/SG2002_QFN88_38_20230301_4L_V1.3_16.2.csv

Line # | Name | Description | Designator | Quantity | Manufacturer 1 | Manufacturer Part Number 1 | Manufacturer Lifecycle 1 | Supplier 1 | Supplier Part Number 1 | Supplier Unit Price 1 | Supplier Subtotal 1
 | 0.1uF | C0201 | C1, C9, C10, C11, C15, C16, C19, C23, C29, C30, C32 | 11
 | 2.2uF | C0402 | C2, C3, C7, C20, C21 | 5
 | 1uF | C0402 | C4, C13, C37, C69, C74 | 5
 | 4.7uF | C0603 | C5 | 1
 | 0.1uF | C0603 | C6, C40 | 2
 | 4.7uF | C0402 | C12, C25, C44, C68 | 4
 | 12pF | C0402 | C17, C18 | 2
 | 0.1uF | C0402 | C22, C36, C43, C45, C48, C53, C56, C60, C62, C66, C71, C73 | 12
 | 4.7uF | C0201 | C24 | 1
 | 1uF | C0201 | C26, C28, C31 | 3
 | NC_0.1uF | C0402 | C33, C75 | 2
 | 22uF | C0402 | C35 | 1
 | 22uF | C0603 | C39, C47 | 2
 | 100pF | C0603 | C41 | 1
 | 100pF | C0402 | C46, C57 | 2
 | 22uF/16V | C0805 | C49 | 1
 | 0.1uF/16V | C0402 | C50, C79 | 2
 | 10uF | C0805 | C51 | 1
 | NC/33pF | C0402 | C54 | 1
 | 10uF | C0603 | C55, C61, C65, C67, C70, C72 | 6
 | 22uF | C0805 | C58 | 1
 | NC_2.2uF | C0402 | C63 | 1
 | NC_0.1uF | 贴片电容 CAP CER 0.1UF 16V 10% X7R 0402 | C77, C78 | 2
 | 1nF/2KV | C1206 | C80 | 1
 | 0.1uF | CAP CER 0.1UF 16V 10% X7R 0402 | C81, C84, C86, C88, C98 | 5
 | 10uF | 22UF,16V,10%,X5R,0805 | C82 | 1
 | 10uF | 贴片电容 CAP CER 0.1UF 16V 10% X7R 0402 | C83, C85, C87, C89 | 4
 | 4.7uF | 贴片电容 CAP CER 0.1UF 16V 10% X7R 0402 | C90, C95, C106 | 3
 | 0.1uF | 贴片电容 CAP CER 0.1UF 16V 10% X7R 0402 | C91, C92, C96, C97, C100 | 5
 | 2.2uF | Cap, 1uF, +/-10%, 25V, X5R 0402 | C102, C103, C104, C105 | 4
 | NC_0.1uF | Cap, 1uF, +/-10%, 25V, X5R 0402 | C108 | 1
 | NC/GBLC03C |  | D2, D3 | 2
 | SMBJ14A |  | DA4 | 1
 | H1 |  | EPAD_HOLE1, H1, H2, H3, H4 | 5
 | FPC18/0.5MM |  | J1 | 1
 | WB1252B-02R-TAND |  | J2, J3 | 2
 | NC_1.25-4ALT |  | J4 | 1
 | 1.25-4ALT |  | J5 | 1
 | 1.25-8ALT |  | J6 | 1
 | 1.25-2ALT |  | J7 | 1
 | Header_M / 3X1 /1.25mm | JMP_1X3_2.0 | J8 | 1
 | WPN252012H2R2MT_2.2uH_2A |  | L1, L2 | 2
 | WPN252012H1R0MT_1uH_4A |  | L3 | 1
 | WPN252012E1R0MT_1uH_3A |  | L4 | 1
 | S9013 | S9013 SOT-23 | Q1 | 1
 | 0R | R0201 | R1 | 1
 | 33R | R0402 | R2, R29 | 2
 | 5.1R |  | R3, R5, R12, R13 | 4
 | 33K |  | R4, R47 | 2
 | 4.7K | R0402 | R6, R7, R15, R31, R32, R53, R54 | 7
 | 1M |  | R8 | 1
 | NC/4.7K | R0402 | R11, R14 | 2
 | NC_4.7K | R0402 | R16 | 1
 | NC_5.1R |  | R17, R21 | 2
 | 30K/1% | R0402 | R18 | 1
 | 4.7K |  | R19, R63, R65, R66 | 4
 | 10K/1% | R1206 | R20 | 1
 | 10K |  | R25 | 1
 | 470R |  | R26 | 1
 | 2K | R0402 | R27 | 1
 | 1K |  | R28, R58, R59 | 3
 | NC_0R |  | R33 | 1
 | 100K/1% |  | R34, R37 | 2
 | 100K |  | R35 | 1
 | 13K/1% |  | R36 | 1
 | 22.6K/1% |  | R38 | 1
 | 10K/1% |  | R39 | 1
 | NC_40.2K/1% | R0402 | R41 | 1
 | NC_1K | R1206 | R42 | 1
 | 20K/1% |  | R43 | 1
 | 15K/1% | R0402 | R44 | 1
 | 33K | R0402 | R45 | 1
 | 12K/1% | R0402 | R46 | 1
 | 10K | R0402 | R50 | 1
 | NC/1K | R0402 | R51 | 1
 | NC/6.8K | R0402 | R52 | 1
 | NC/22K | R0402 | R55 | 1
 | 12K | R0402 | R56 | 1
 | 75R/1% |  | R57 | 1
 | NC_30K/1% | RES SMD 680K OHM 1% 1/16W 0402 | R60 | 1
 | NC_12K/1% | 130K,OHM,1%,1/16W,R0402(1005) | R61 | 1
 | NC/0R |  | R64 | 1
 | 33R |  | R67 | 1
 | CV181xC_QFN88 |  | U1 | 1
 | SGM4890 |  | U2 | 1
 | NOR/FLASH/16MB/3.3V | ESMT_SPINOR_8-C WSON | U4 | 1
 | ETA8110 |  | U5 | 1
 | ETA3414S2F |  | U6, U7, U8 | 3
 | ETA5050V18S2F |  | U9 | 1
 | M1601AG |  | U10 | 1
 | ETA5050V28S2F |  | U11 | 1
 | ETA5050V12S2F |  | U12 | 1
 | SC200AI/GC4653 |  | U13 | 1
 | Holder_A02_037_026 |  | U14 | 1
 | MX6208 |  | U15 | 1
 | 25MHz/12.5pF | 25MHZ,3225 4PIN,SMT,12pF | Y1 | 1
