nilotpal-n7/NanoD1/Project Outputs for NanoD1/NanoD1-BOM-JLCPCB.csv

Comment | Designator | Footprint | JLCPCB Part # | Quantity | MPN | Note
100nF | C1,C6,C7,C11,C12,C18,C22,C24,C26,C29,C30,C31,C32,C35,C36,C38,C43,C44,C53,C57,C61,C62 | 0402 | C1525 | 22 | GRM155R71C104KA88D
1uF | C2,C3,C5,C13,C17,C50,C51,C59 | 0402 | C52923 | 8 | GRM155R61A105KE15D
4.7uF | C4,C8,C14,C15,C52 | 0402 | C23733 | 5 | GRM155R61A475MEAAD
10uF | C9,C10,C16,C20,C21,C28,C33,C34,C37,C40,C42,C58,C60 | 0603 | C19702 | 13 | GRM188R61A106ME69D
22uF | C41,C45,C47,C54 | 0805 | C45783 | 4 | GRM21BR61A226ME51L
22uF 16V | C46 | 0603 | C2762594 | 1 | GRM188R61A226ME15D
22uF | C48,C49 | 0603 | C59461 | 2 | GRM188R61A226ME15D
18pF | C55,C56 | 0402 | C1549 | 2 | GRM1555C1H180JA01D
USBLC6-2SC6 | D1 | SOT-23-6 | C2827654 | 1 | USBLC6-2SC6
U.FL-R-SMT(01) | E1 | SMD U.FL | C434812 | 1 | U.FL-R-SMT(01)
600R@100MHz 0603 | FB2,FB5 | 0603 | C88979 | 2 | BLM18HE601SN1D
USB4085-GF-A | J2 | SMD USB-C 16P | C7095263 | 1 | USB4085-GF-A
2.2uH | L1,L3 | 1008 (2520) | C3040393 | 2 | FXLB252012-2R2-M
1uH | L2 | 1008 (2520) | C435392 | 1 | DFE252012F-1R0M
4.7uH | L4 | 1008 (2520) | C5832360 | 1 | FTC252010S4R7MBCA
KP-1608SGC | LED1,LED2 | 0603 | C598263 | 2 | KP-1608SGC
22R | R1,R8,R18 | 0402 | C25092 | 3 | RC0402FR-0722RL
10K | R2,R3,R4,R5,R6,R7,R17,R19,R20,R21,R22,R23,R24,R25,R52 | 0402 | C25744 | 15 | RC0402FR-0710KL
4.7K | R9,R10,R11,R12,R15 | 0402 | C25900 | 5 | RC0402FR-074K7L
30K 1% | R16 | 0402 | C2909347 | 1 | RC0402FR-0730KL
5K1 | R37,R38 | 0402 | C25905 | 2 | RC0402FR-075K1L
5R1 | R39,R40 | 0402 | C2909363 | 2 | RC0402FR-075R1L
100K | R41,R57 | 0402 | C25741 | 2 | RC0402FR-07100KL
47K | R42 | 0402 | C25792 | 1 | RC0402FR-0747KL
1M | R43 | 0402 | C26083 | 1 | RC0402FR-071ML
100K 1% | R44 | 0402 | C728576 | 1 | RC0402FR-07100KL
22K6 1% | R45 | 0402 | C100316 | 1 | RC0402FR-0722K6L
11K8 1% | R46 | 0402 | C2929934 | 1 | RC0402FR-0711K8L
20K 1% | R47 | 0402 | C2906867 | 1 | RC0402FR-0720KL
15K 1% | R48 | 0402 | C2909322 | 1 | RC0402FR0715KL
12K 1% | R49 | 0402 | C2909316 | 1 | RC0402FR-0712KL
33K | R50,R51 | 0402 | C25779 | 2 | RC0402FR-0733KL
2K | R53 | 0402 | C4109 | 1 | RC0402FR-072KL
1K | R54 | 0402 | C11702 | 1 | RC0402FR-071KL
300K | R55 | 0402 | C25774 | 1 | RC0402FR-07300KL
0R | R60 | 0402 | C17168 | 1 | RC0402JR-070RL
EVQP2B02B | SW1,SW2 | SMD tactile 4.7x3.5 | C713480 | 2 | EVQP2B02B
SG2002 | U1 | QFN-88(9x9) |  | 1 | SG2002 | SELF-SUPPLY - not in JLC library
DM3AT-SF-PEJM5(40) | U2 | SMD microSD | C597971 | 1 | DM3AT-SF-PEJM5(40)
W25Q128JVSIM_TR | U3 | SOIC-8-208mil | C401671 | 1 | W25Q128JVSIM_TR
AP6212 | U4 | QFN-44(12x12) | C2798300 | 1 | AP6212
ETA3414S2F | U5,U6,U7 | SOT-23-5 | C7465522 | 3 | ETA3414S2F
ETA5050V18S2F | U8 | SOT-23-5 | C6269866 | 1 | ETA5050V18S2F
MAX98357AETE+T | U9 | TQFN-16-EP(3x3) | C910544 | 1 | MAX98357AETE+T
INMP441ACEZ-R7 | U10 | MIC_INMP441ACEZ-R7 | C22379536 | 1 | INMP441ACEZ-R7
25MHz SMD3225-4P | Y1 | SMD-3225-4P | C9006 | 1 | X322525MOB4SI
