nilotpal-n7/NanoD1/SBC/claude-gen/_to_delete/SG2002_PartD_Ethernet.csv

Name | Designator | Electrical Type | Description | Side
ETH_TXP_RXN | 62 | IO | EPHY_RXN | Right
ETH_TXM_RXP | 63 | IO | EPHY_RXP | Right
ETH_RXP_TXN | 64 | IO | EPHY_TXN | Right
ETH_RXM_TXP | 65 | IO | EPHY_TXP | Right
PWR_GPIO1 | 48 | IO | ETH_LNK | Left
PWR_GPIO2 | 49 | IO | ETH_SPD | Left
