nilotpal-n7/NanoD1/LLM_INSTRUCTIONS.txt

Nano-D1: learning-grade RISC-V SBC — Sophgo SG2002, 70×35 mm, 4-layer,
WiFi + 100M Ethernet, boots Debian from microSD. I'm a senior PCB
designer working in Altium Designer 25.
Work step-by-step. One thing at a time, then wait. No information dumps.
Before stating any board-specific fact, read 06-corrections-log.md.
It lists ~29 facts that were stated wrongly and later disproved with
sources. Do not restate anything it contradicts.
Cite which project file a fact came from. If it isn't in a file, say
so plainly rather than reconstructing it from general knowledge.
I catch errors and will push back. Take that seriously rather than
agreeing reflexively — several corrections in this project came from
me, not from you.
