nilotpal-n7/NanoD1/Project Outputs for NanoD1/Assembly Assembly/PCB 3D Print/PCB 3D Print.PDF

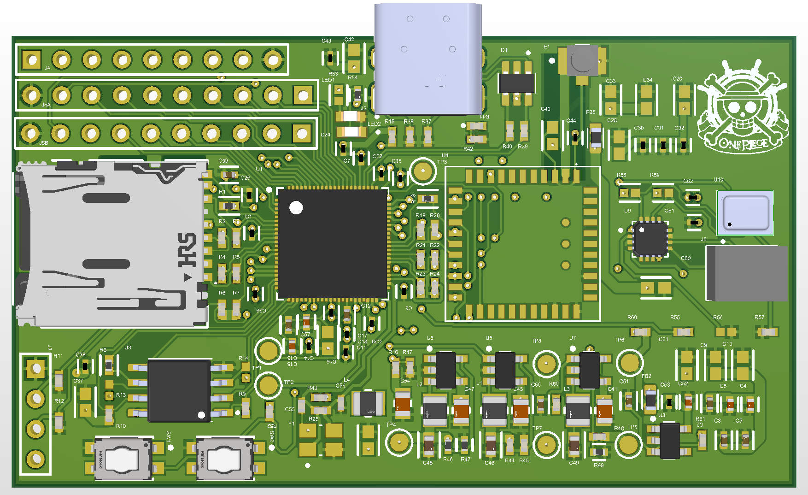
[picture p24: page 1]
