nilotpal-n7/NanoD1/Project Outputs for NanoD1/Assembly Assembly/PCB Print/Assembly Drawings.PDF

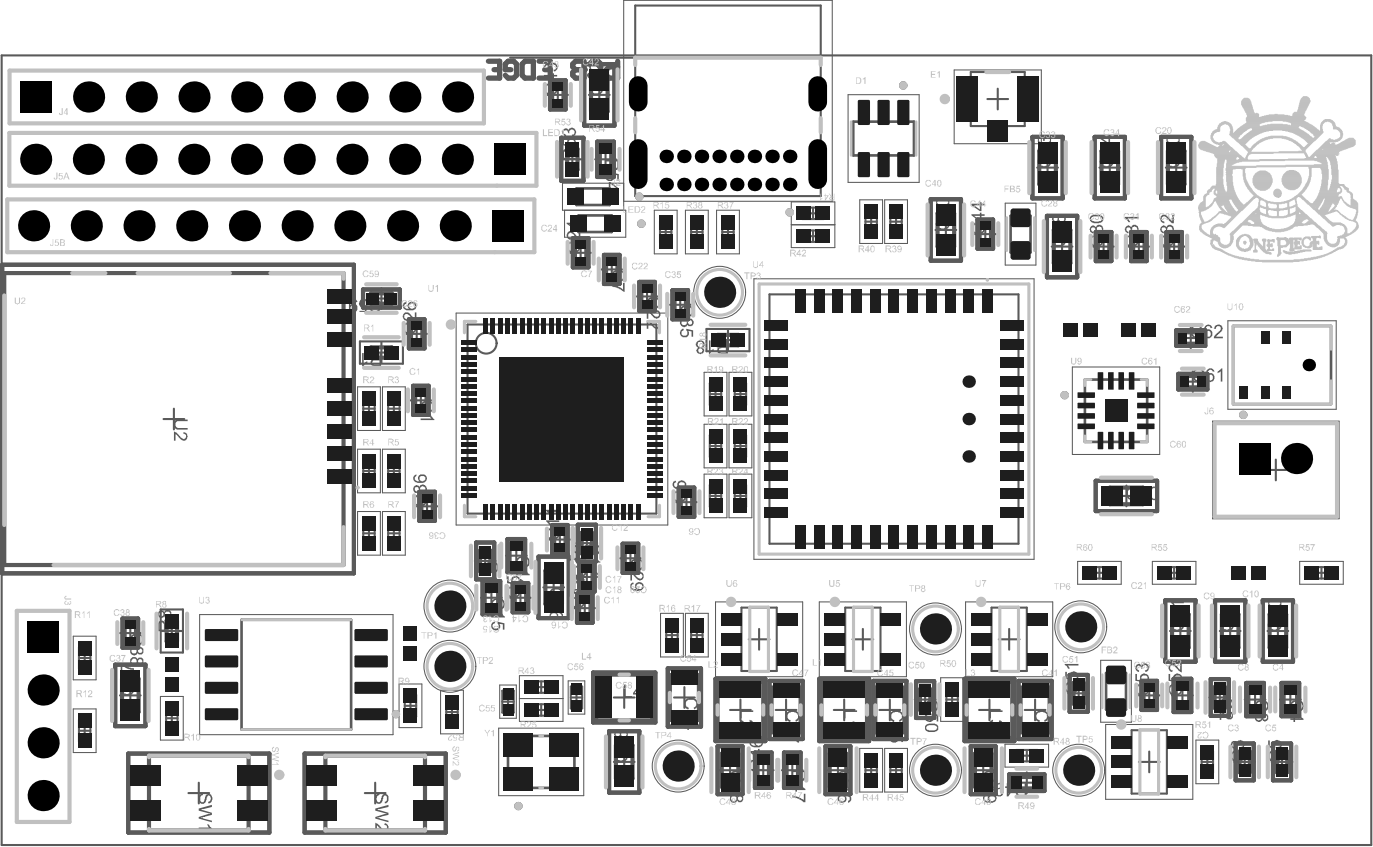
[picture p25: page 1]

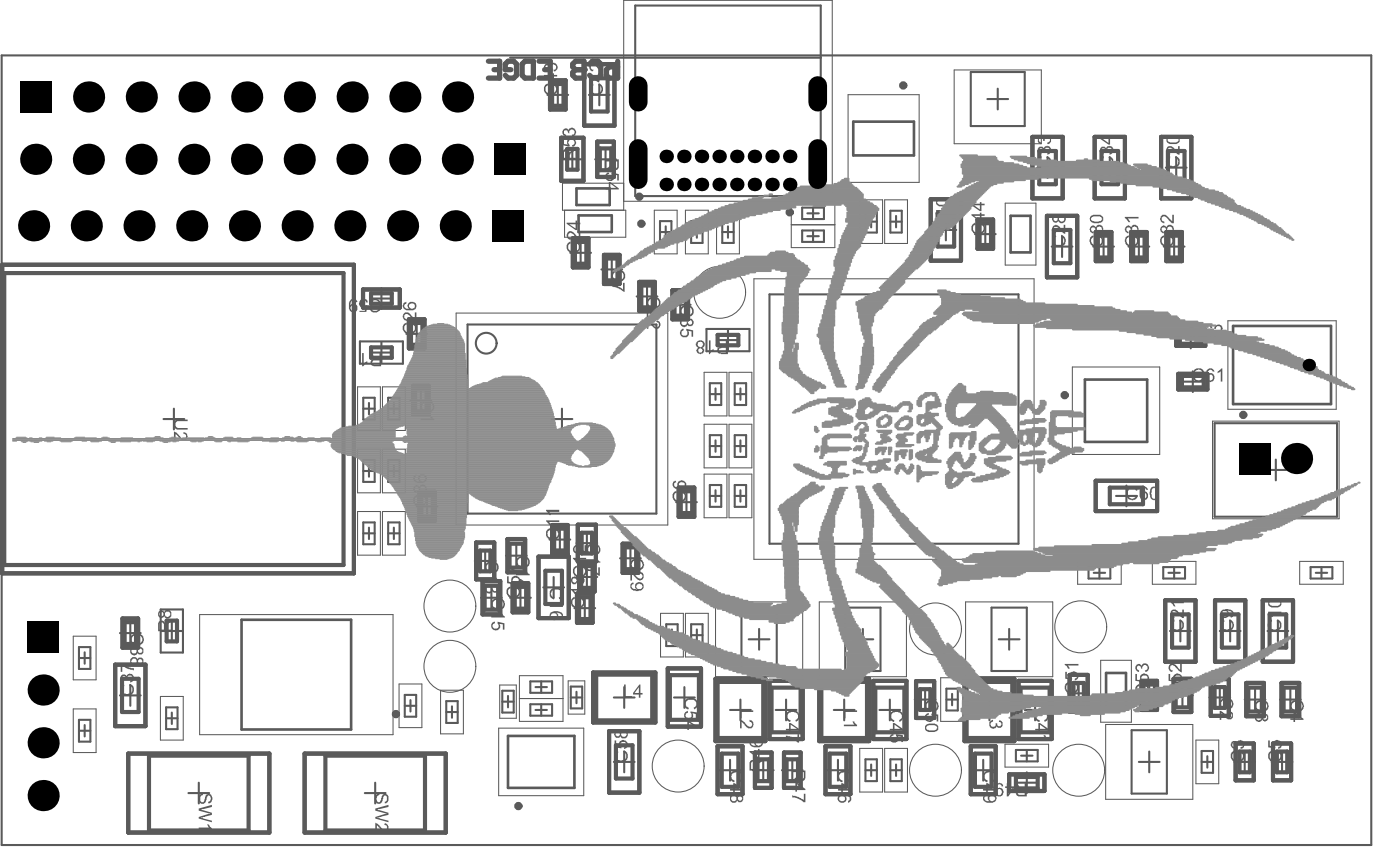
[picture p26: page 2]
