nilotpal-n7/NanoD1/Project Outputs for NanoD1/Assembly Assembly/PCB Print/Composite Drawing.PDF

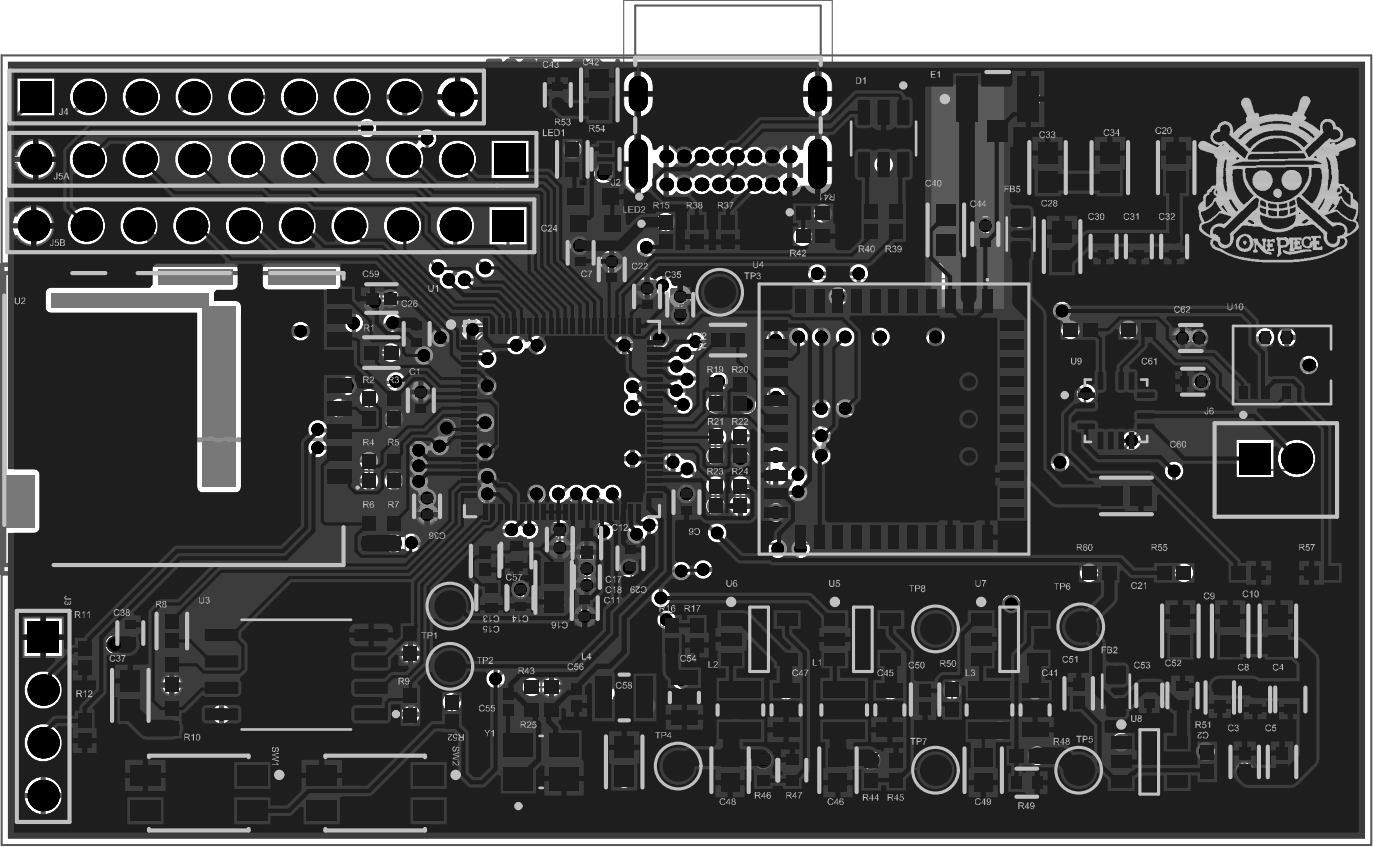
[picture p27: page 1]
