nilotpal-n7/NanoD1/Project Outputs for NanoD1/Assembly Assembly/PCB Print/Composite Drill Drawing.PDF

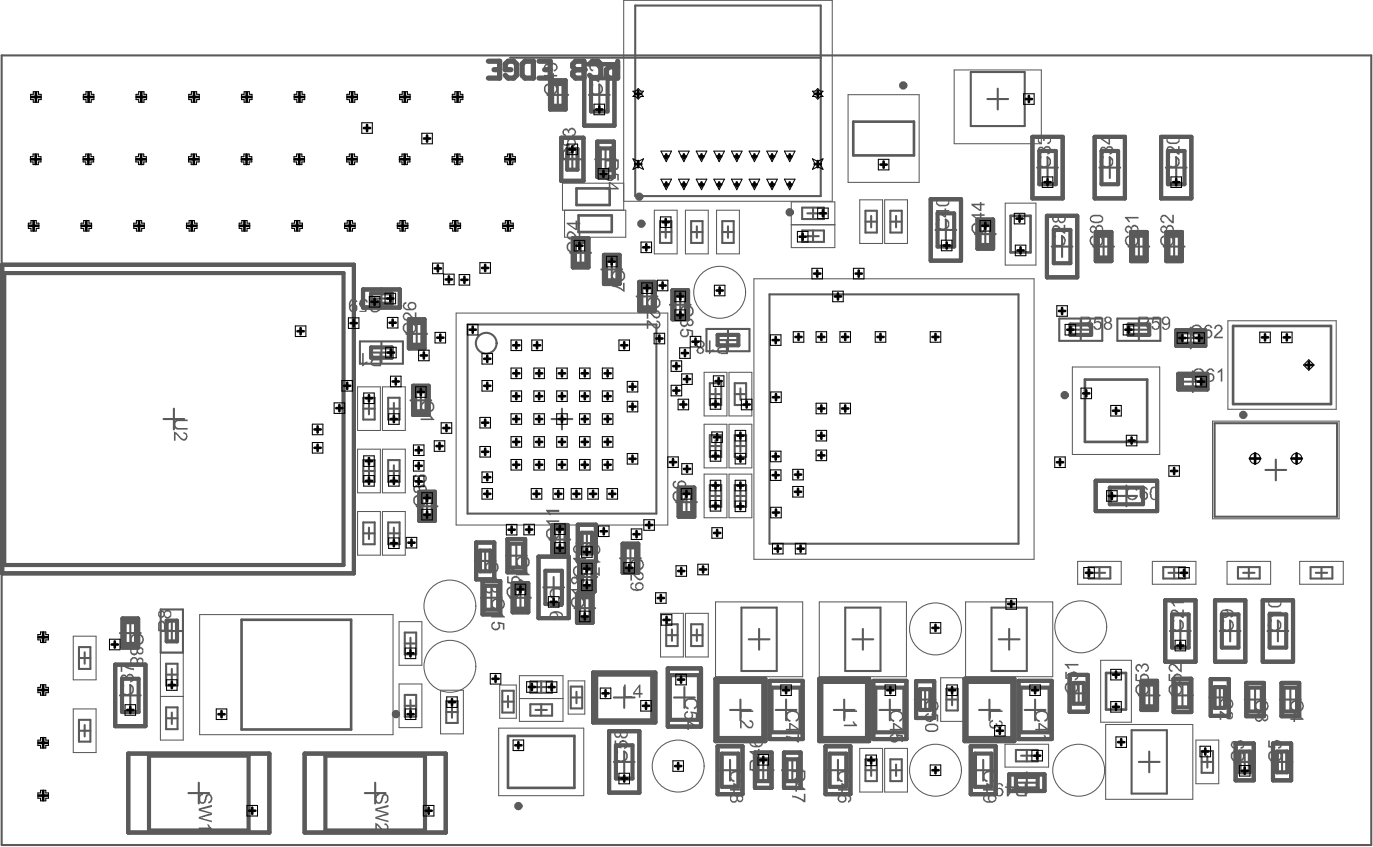
[picture p28: page 1]
