nilotpal-n7/NanoD1/Project Outputs for NanoD1/Assembly Assembly/PCB Print/Final Artwork Prints.PDF

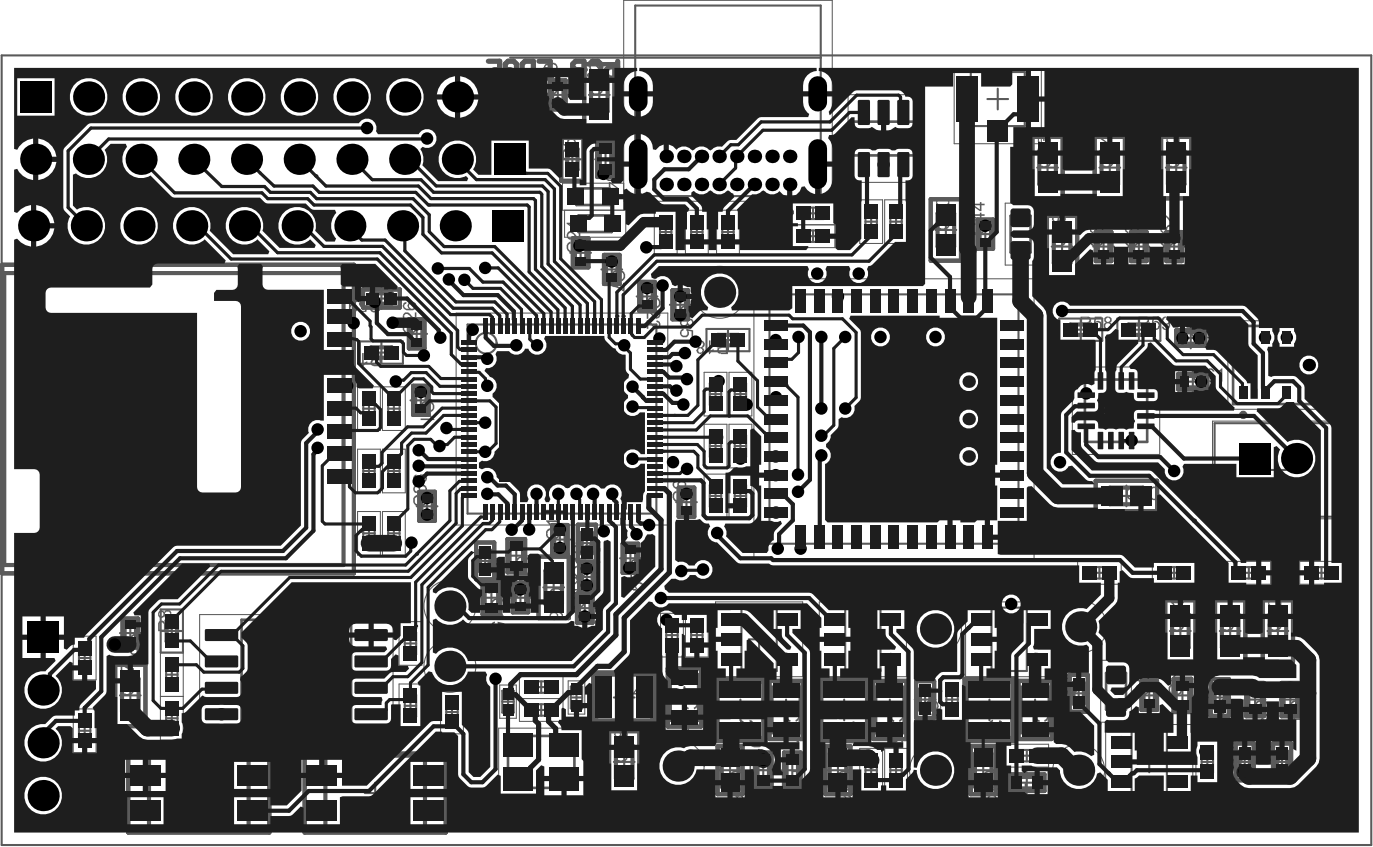
[picture p29: page 1]

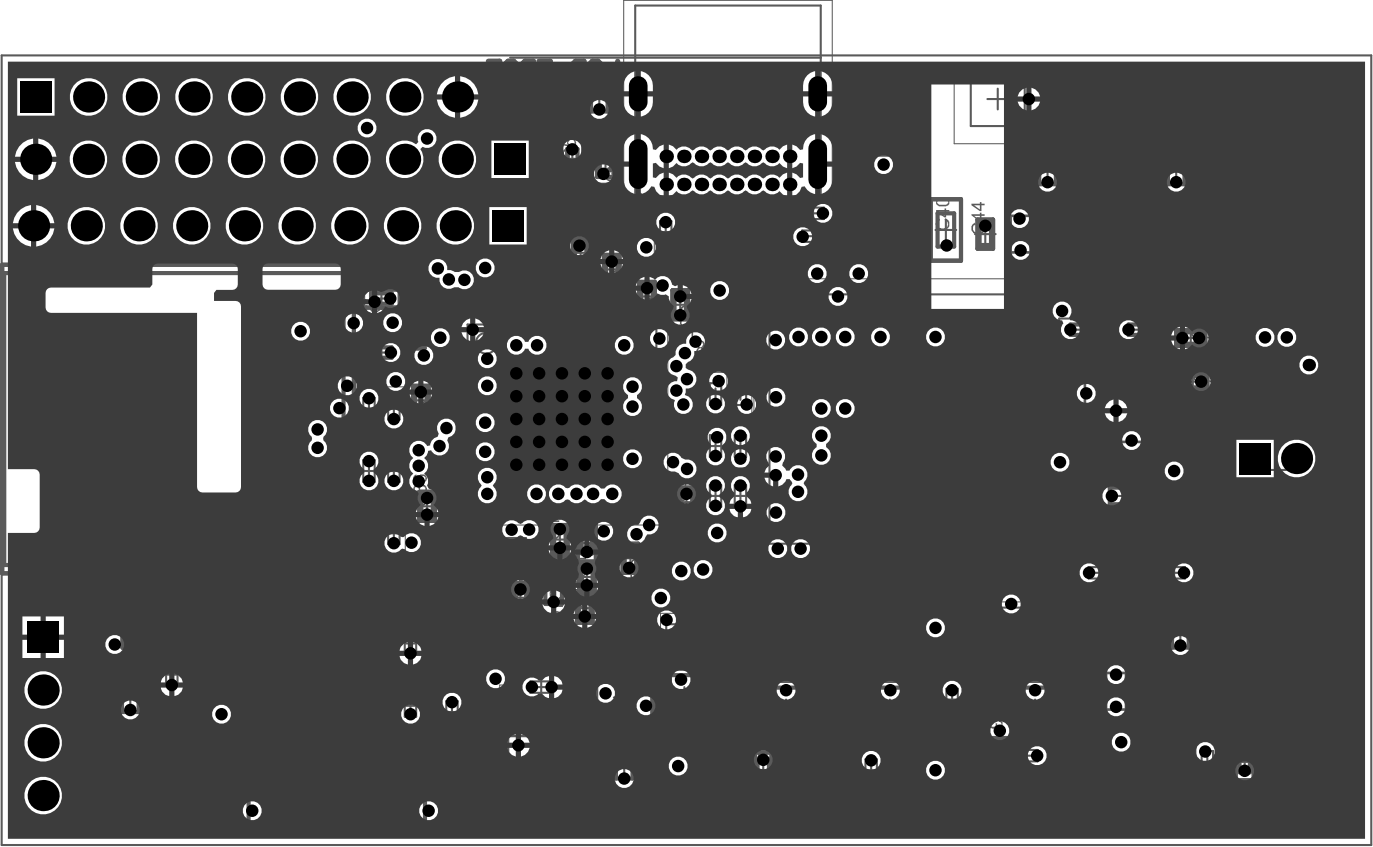
[picture p30: page 2]

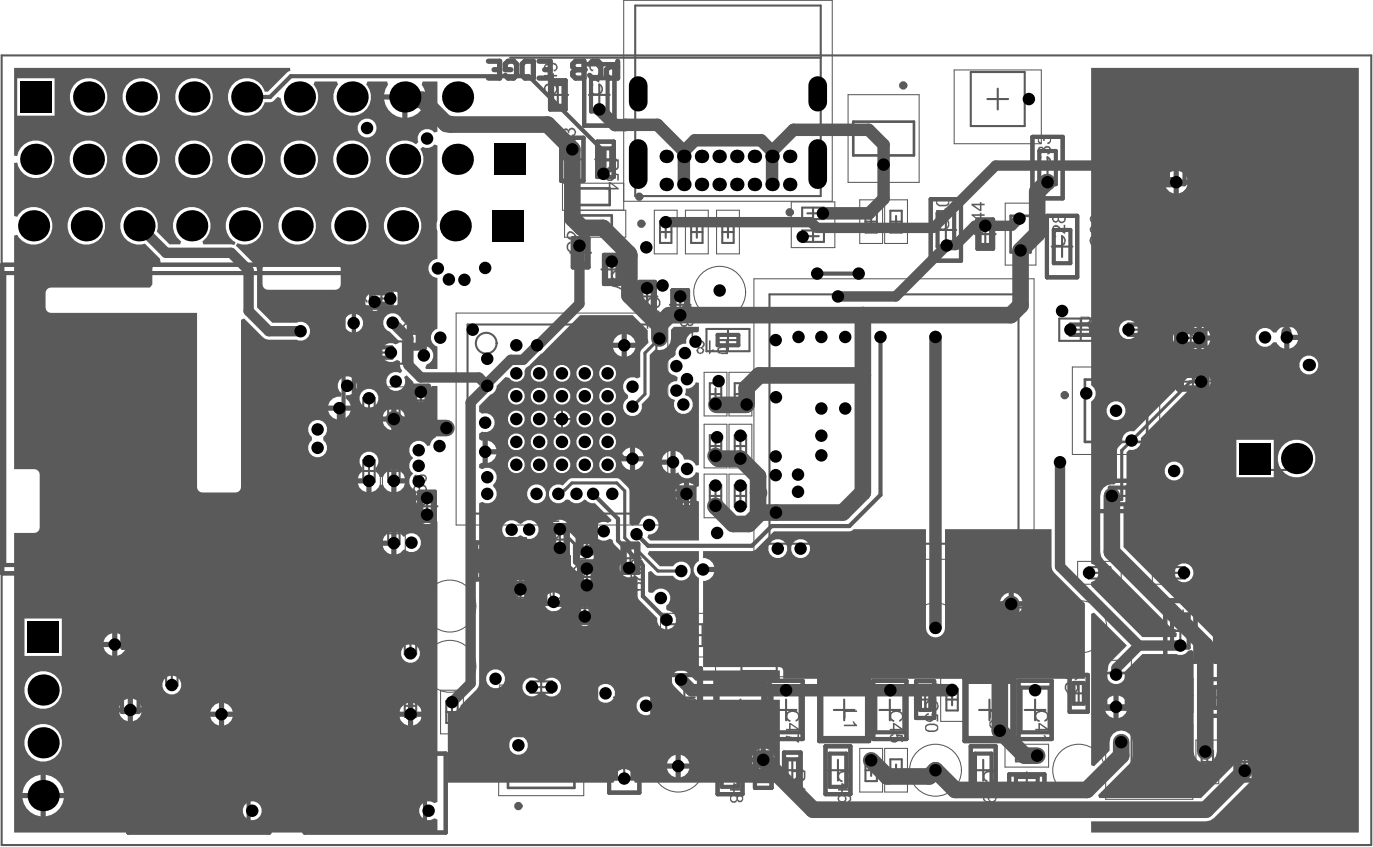
[picture p31: page 3]

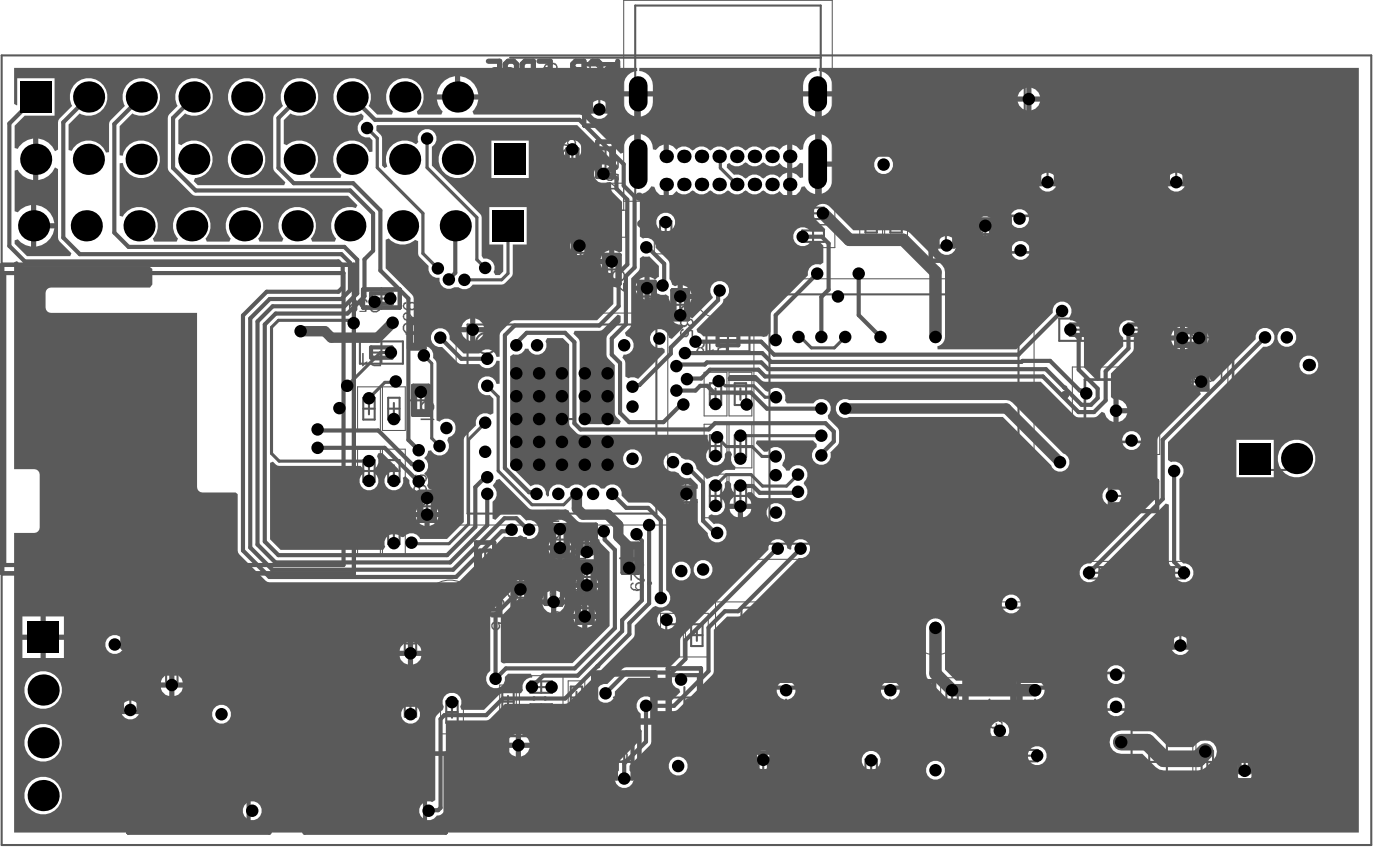
[picture p32: page 4]

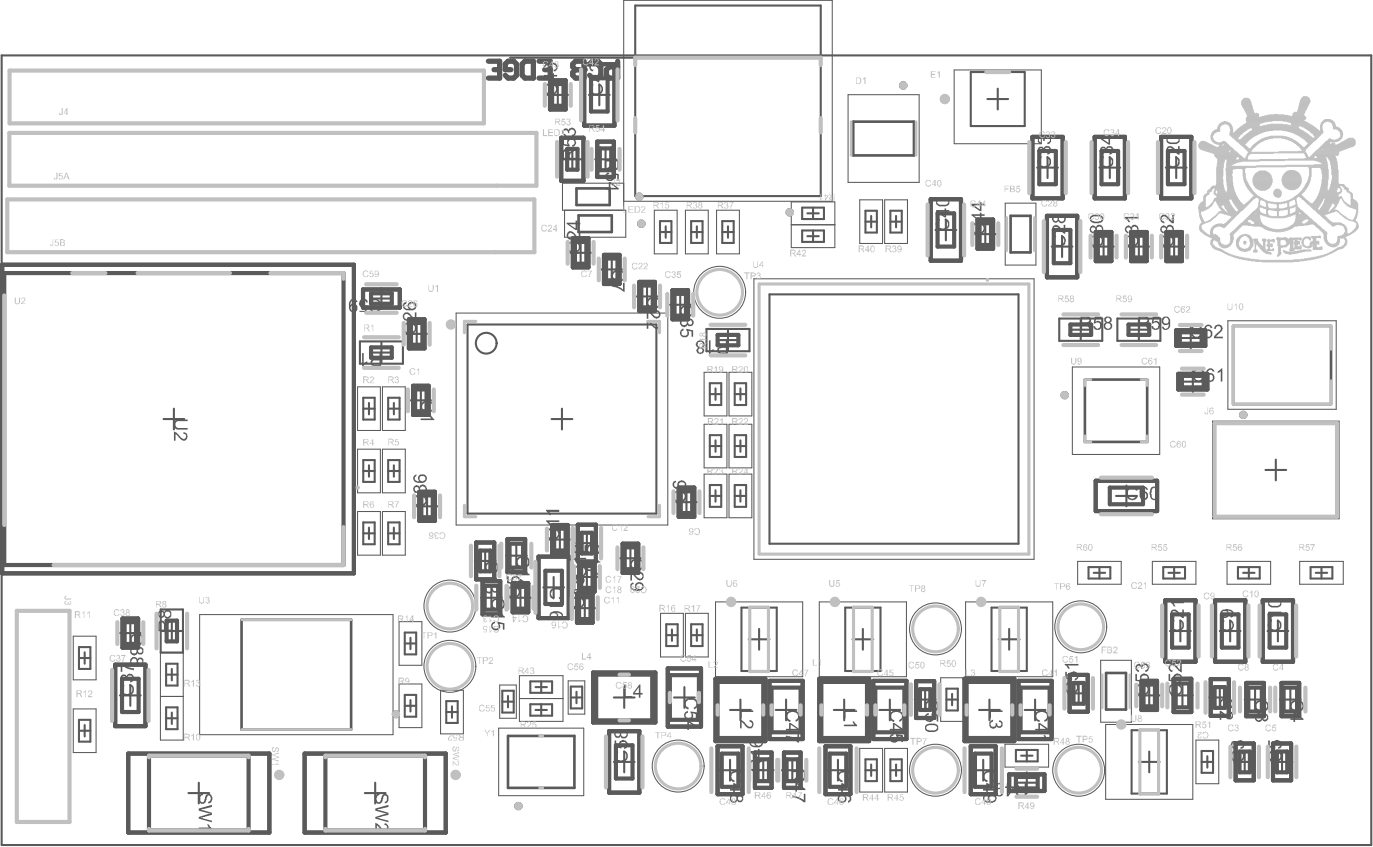
[picture p33: page 5]

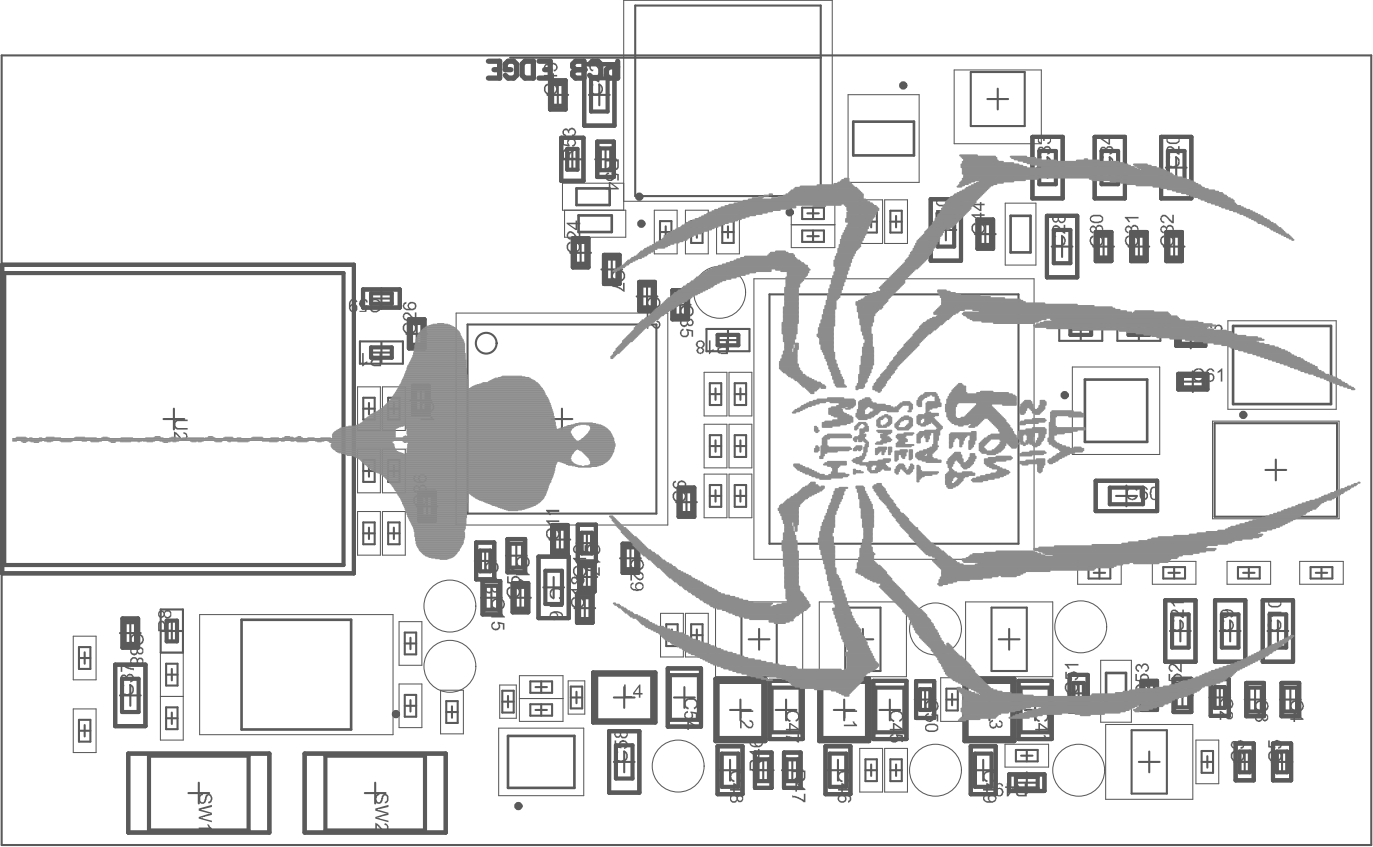
[picture p34: page 6]

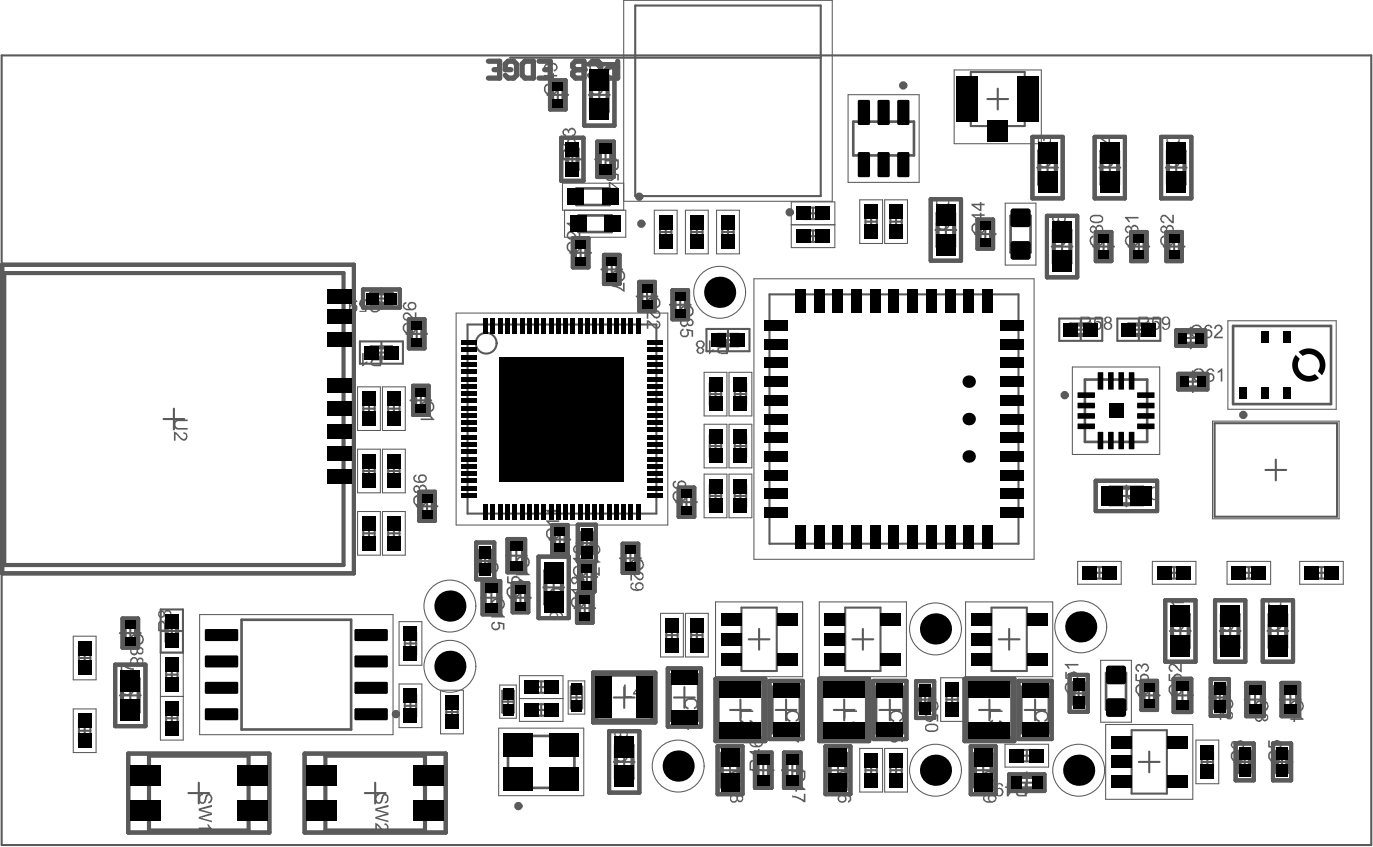
[picture p35: page 7]

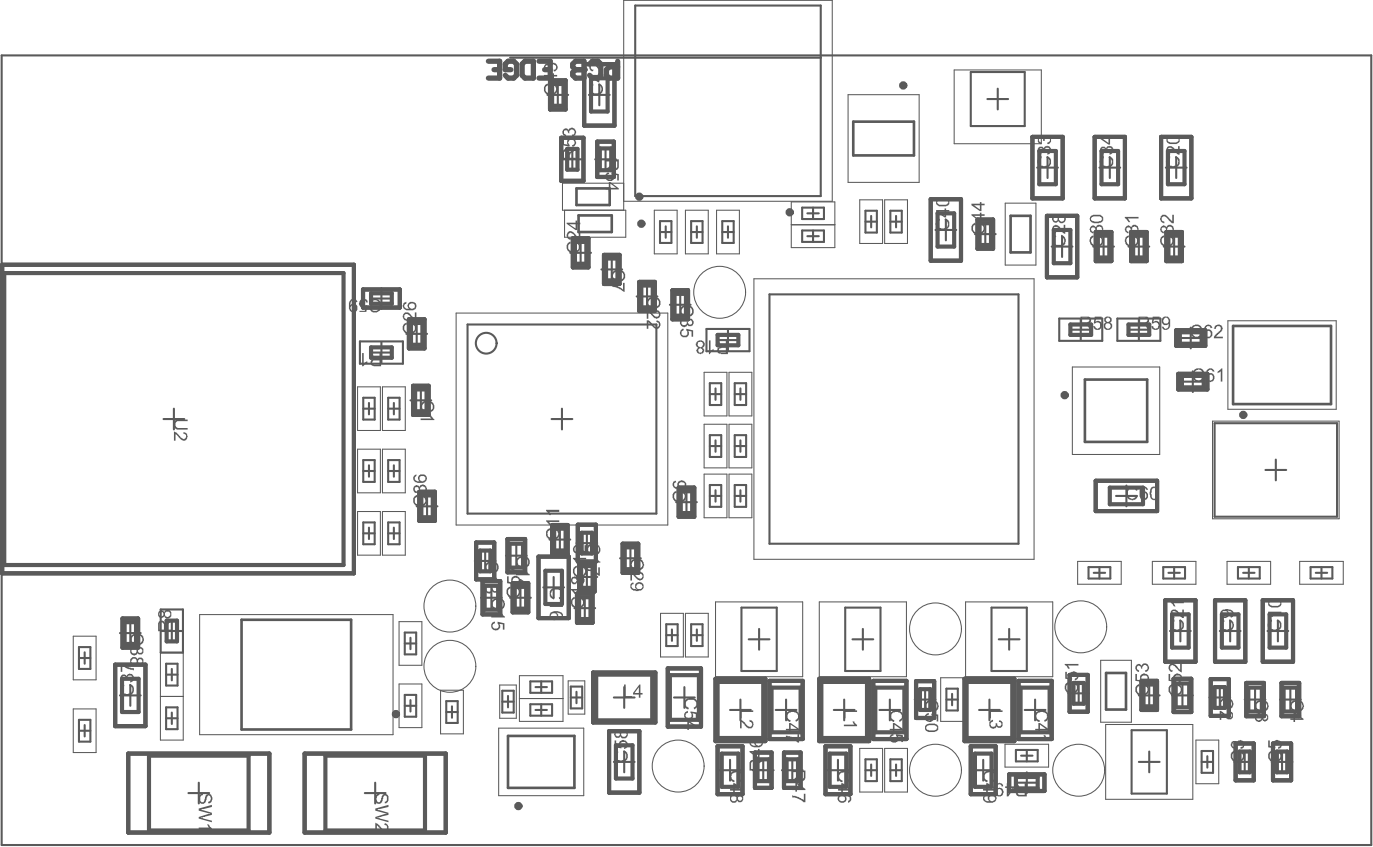
[picture p36: page 8]

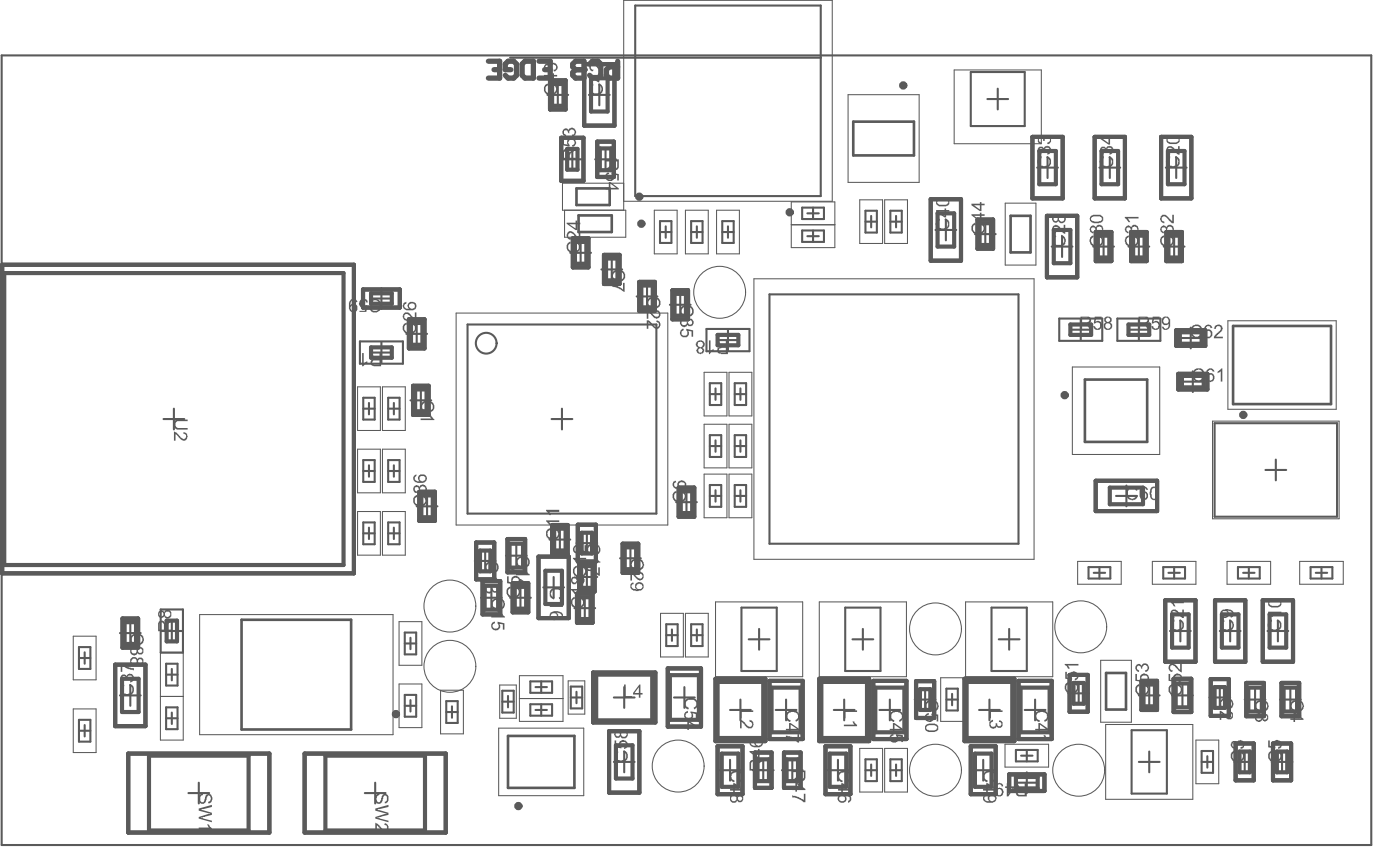
[picture p37: page 11]

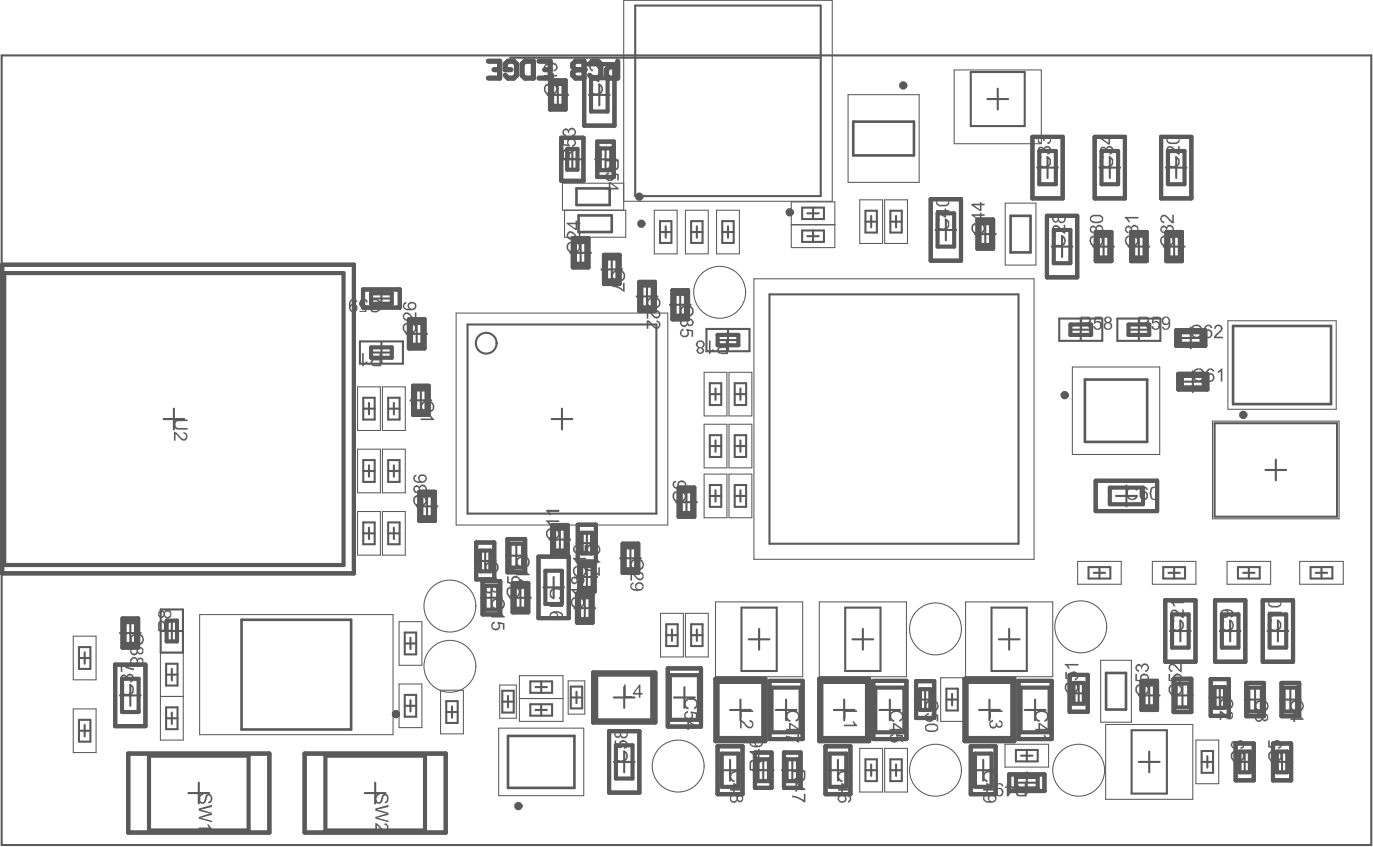
[picture p38: page 14]

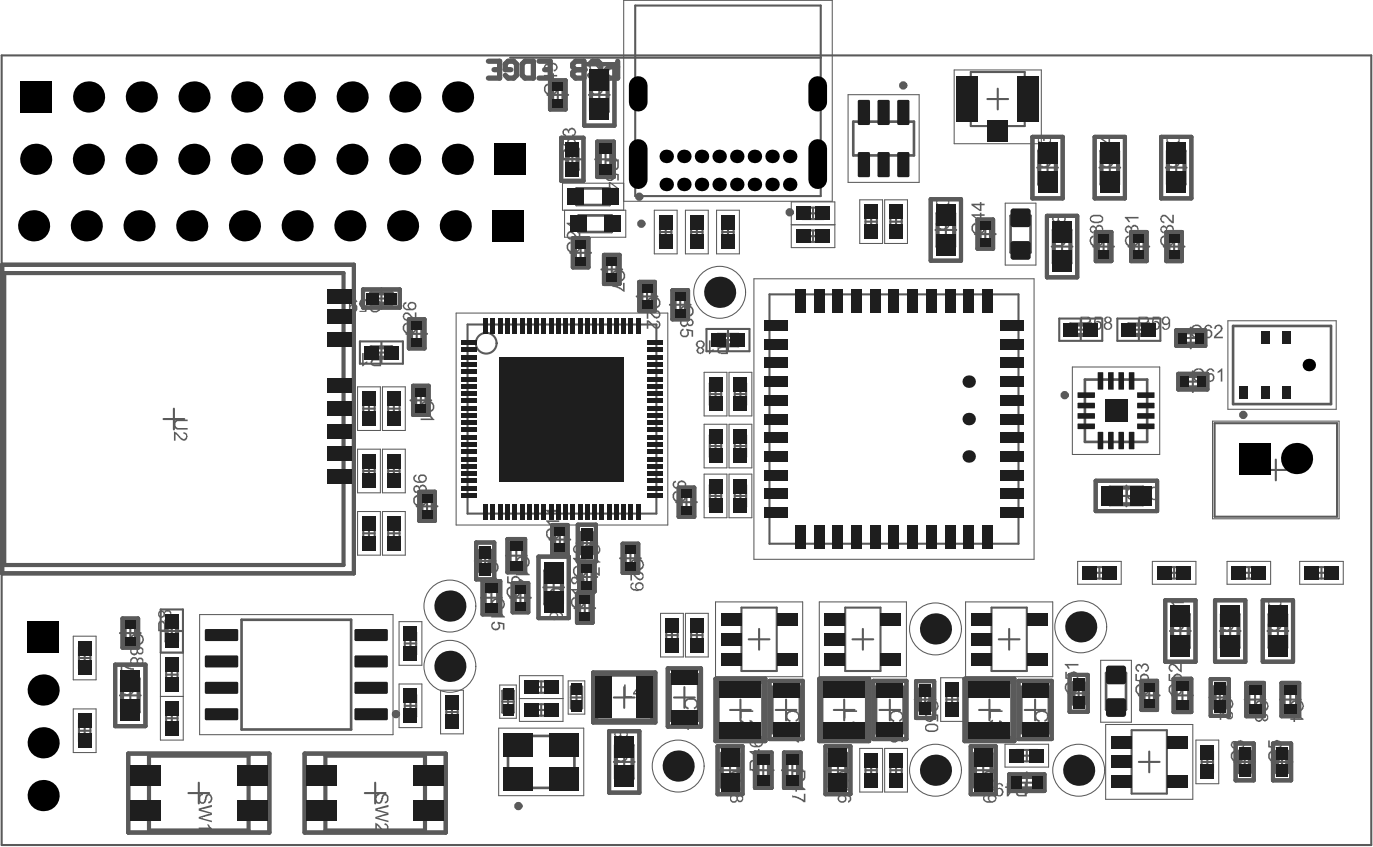
[picture p39: page 15]

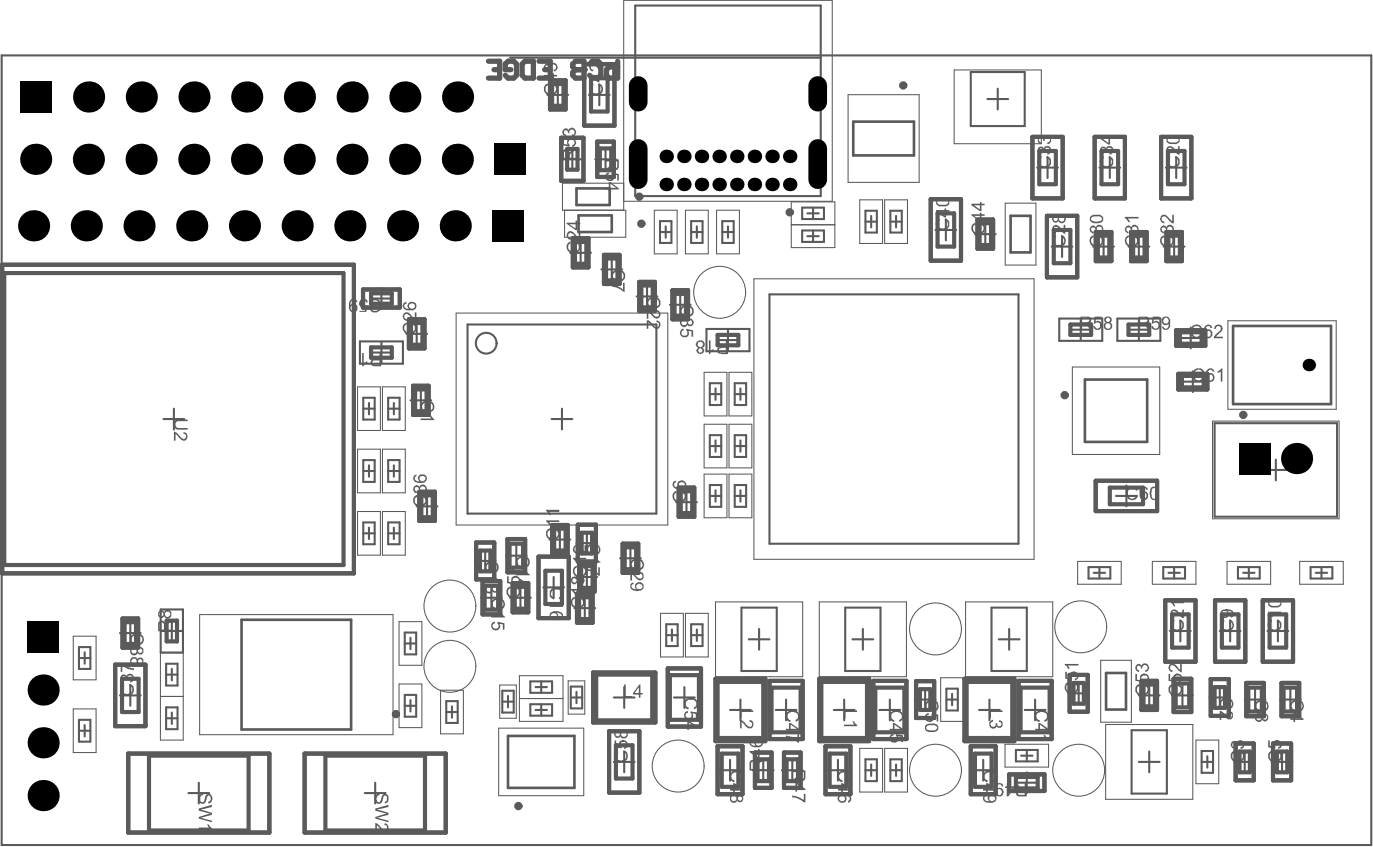
[picture p40: page 16]

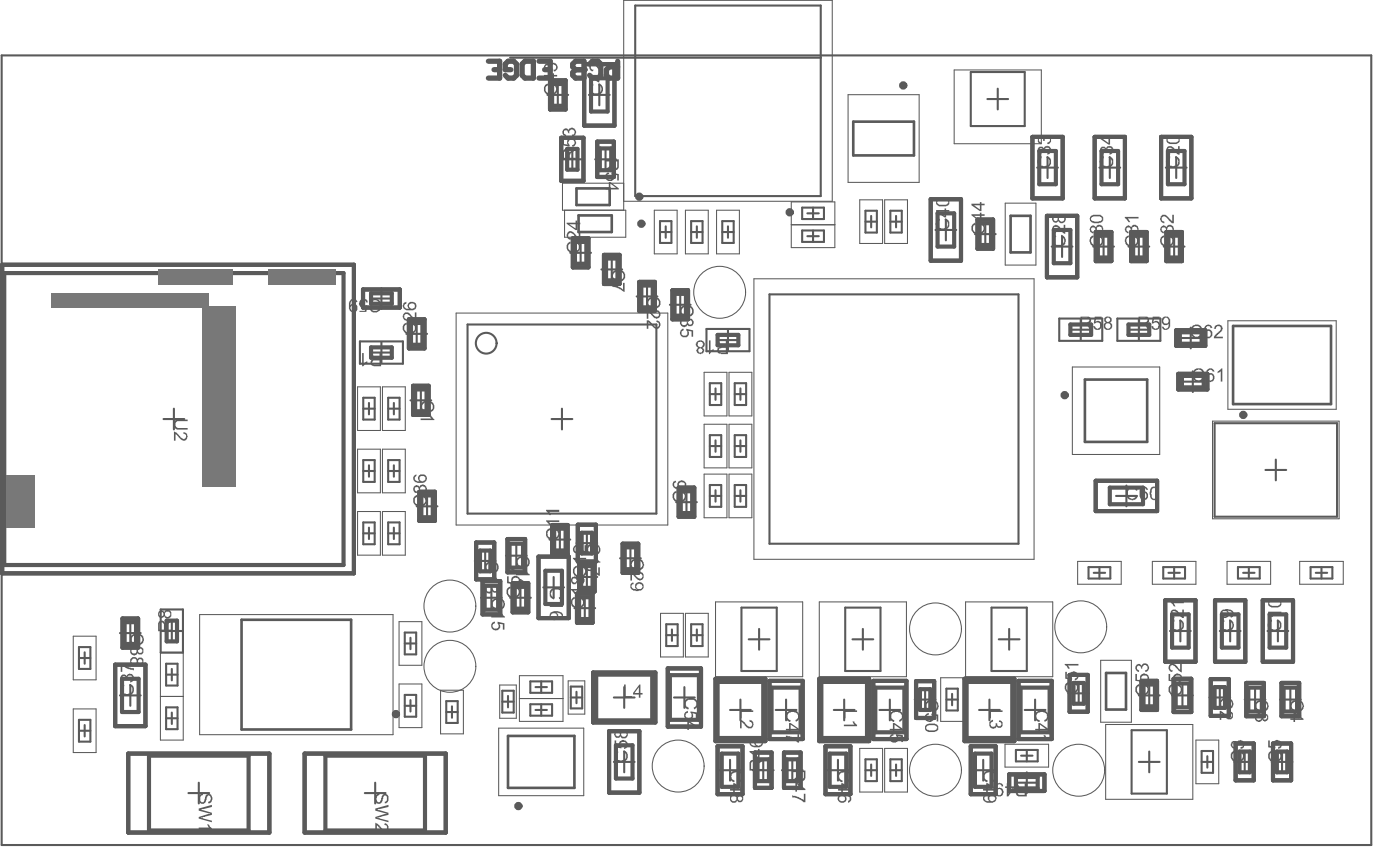
[picture p41: page 17]

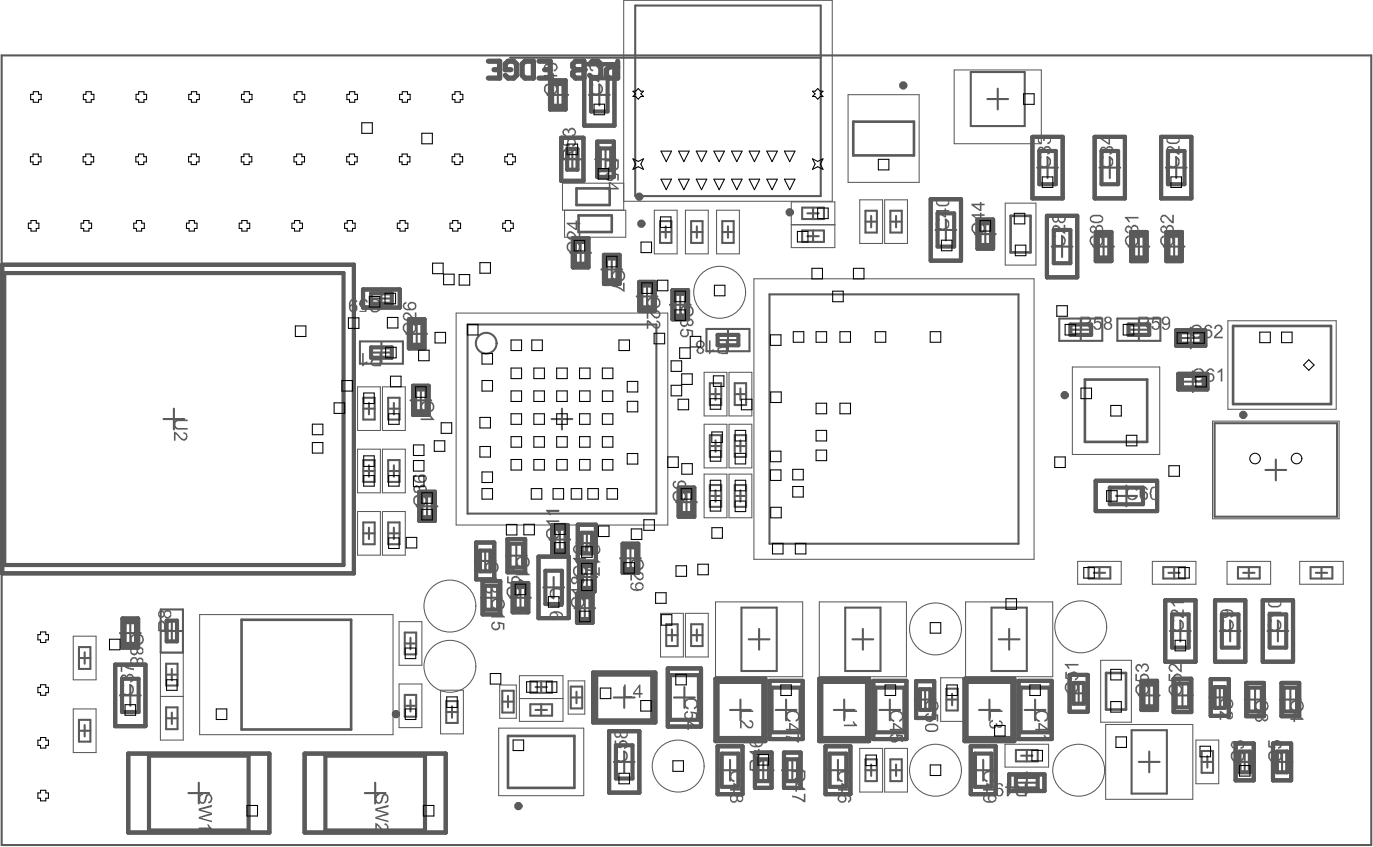
[picture p42: page 18]

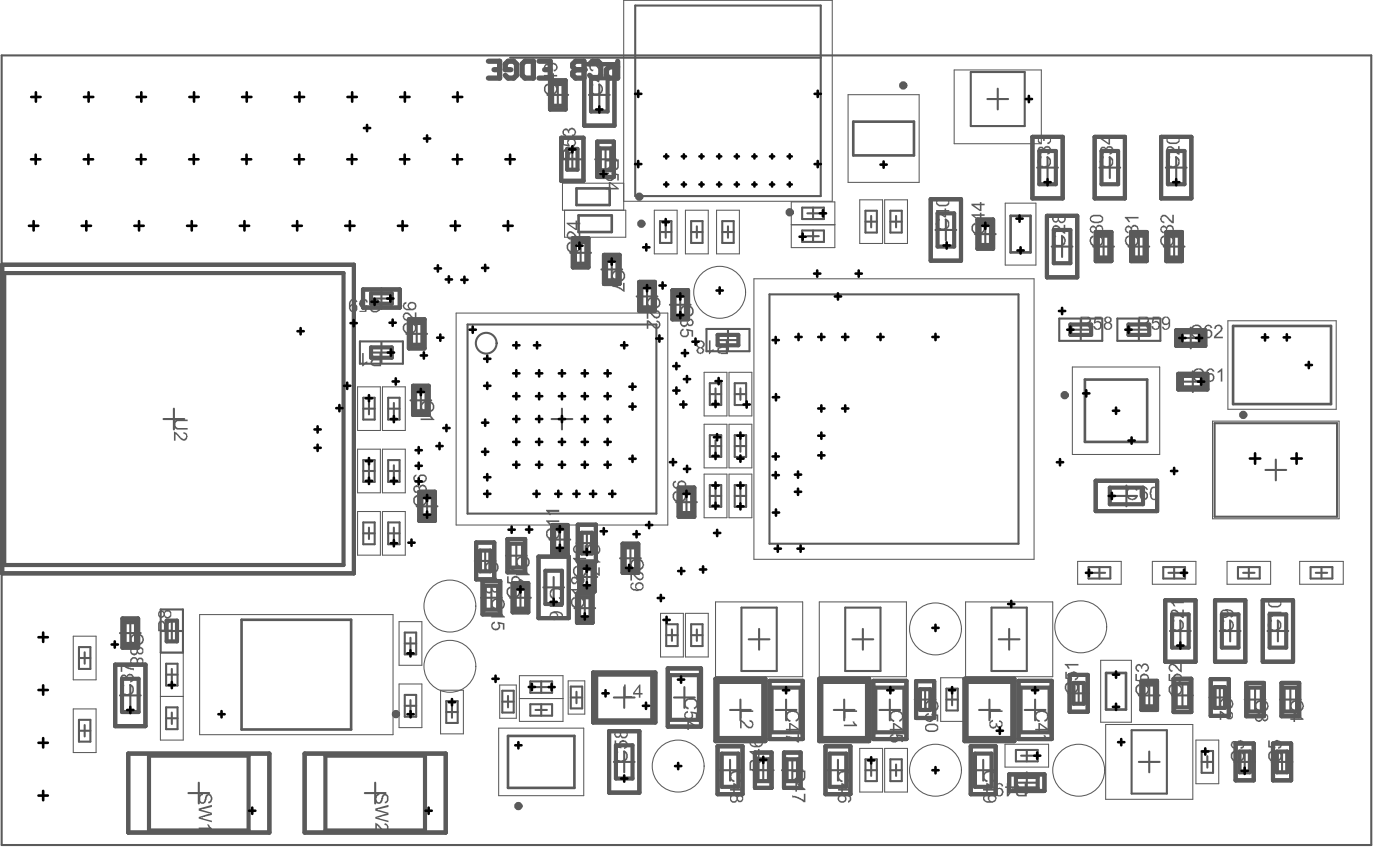
[picture p43: page 19]
