nilotpal-n7/NanoD1/Project Outputs for NanoD1/Assembly Assembly/PCBLIB Print/PCBLIB Prints.PDF

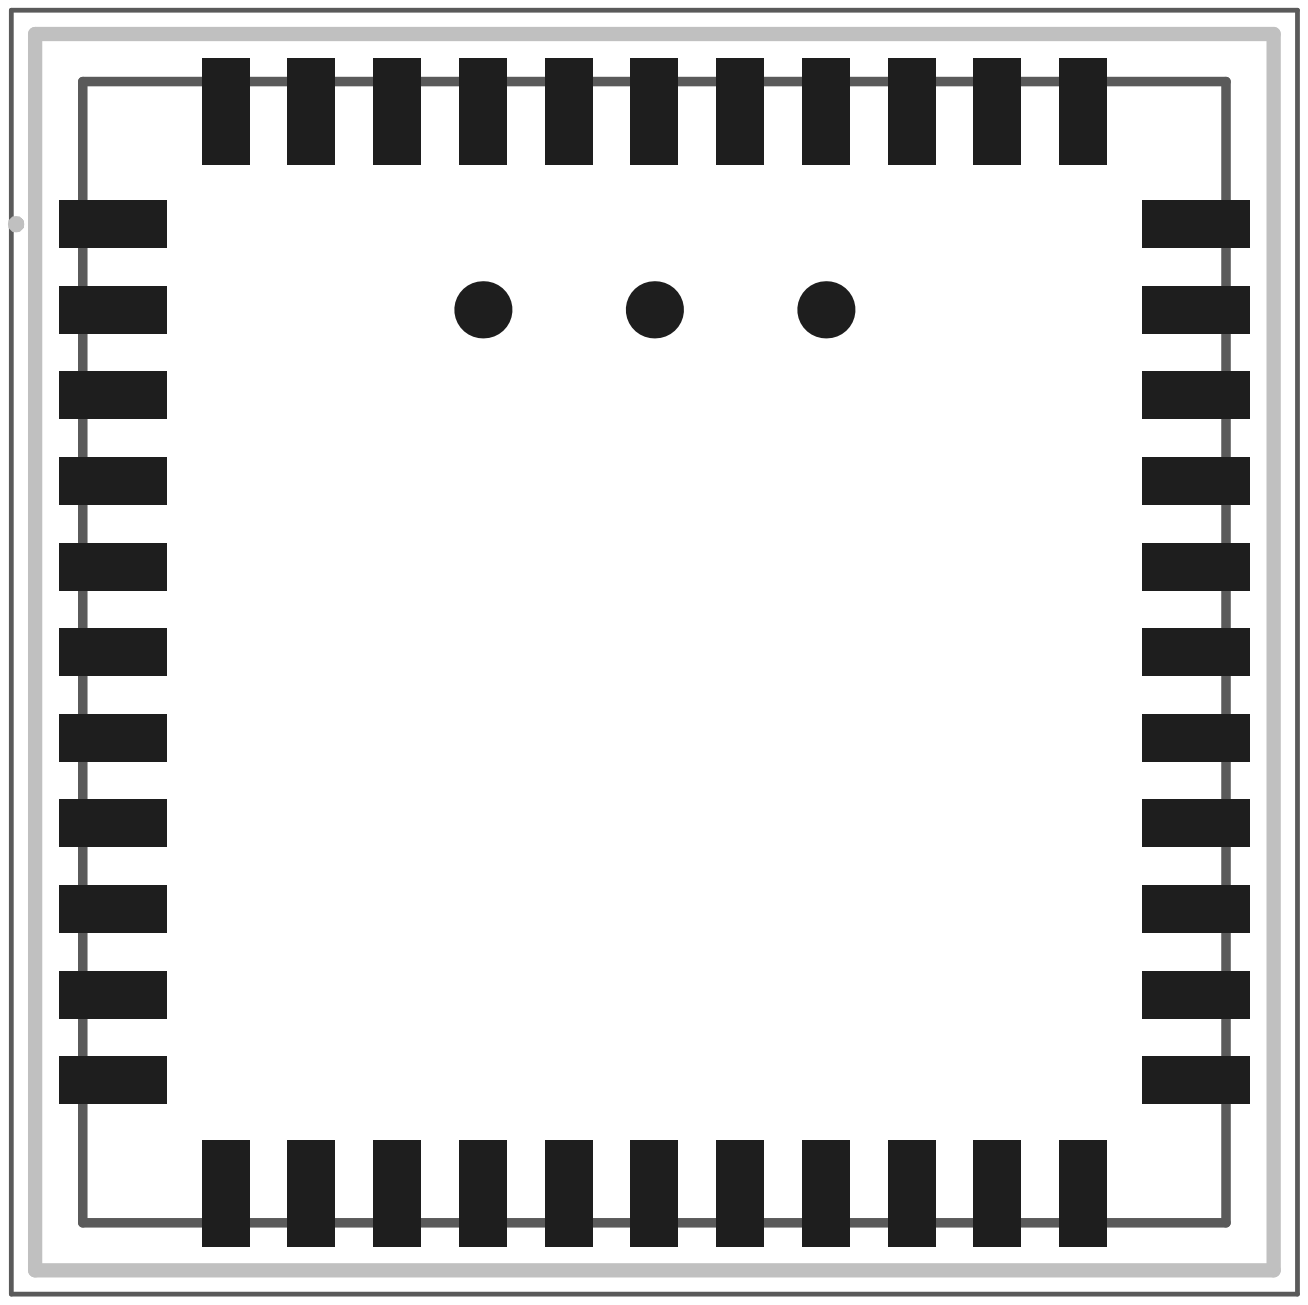
[picture p44: page 1]
