nilotpal-n7/NanoD1/Project Outputs for NanoD1/Assembly Assembly/Schematic Print/Schematic Prints.PDF

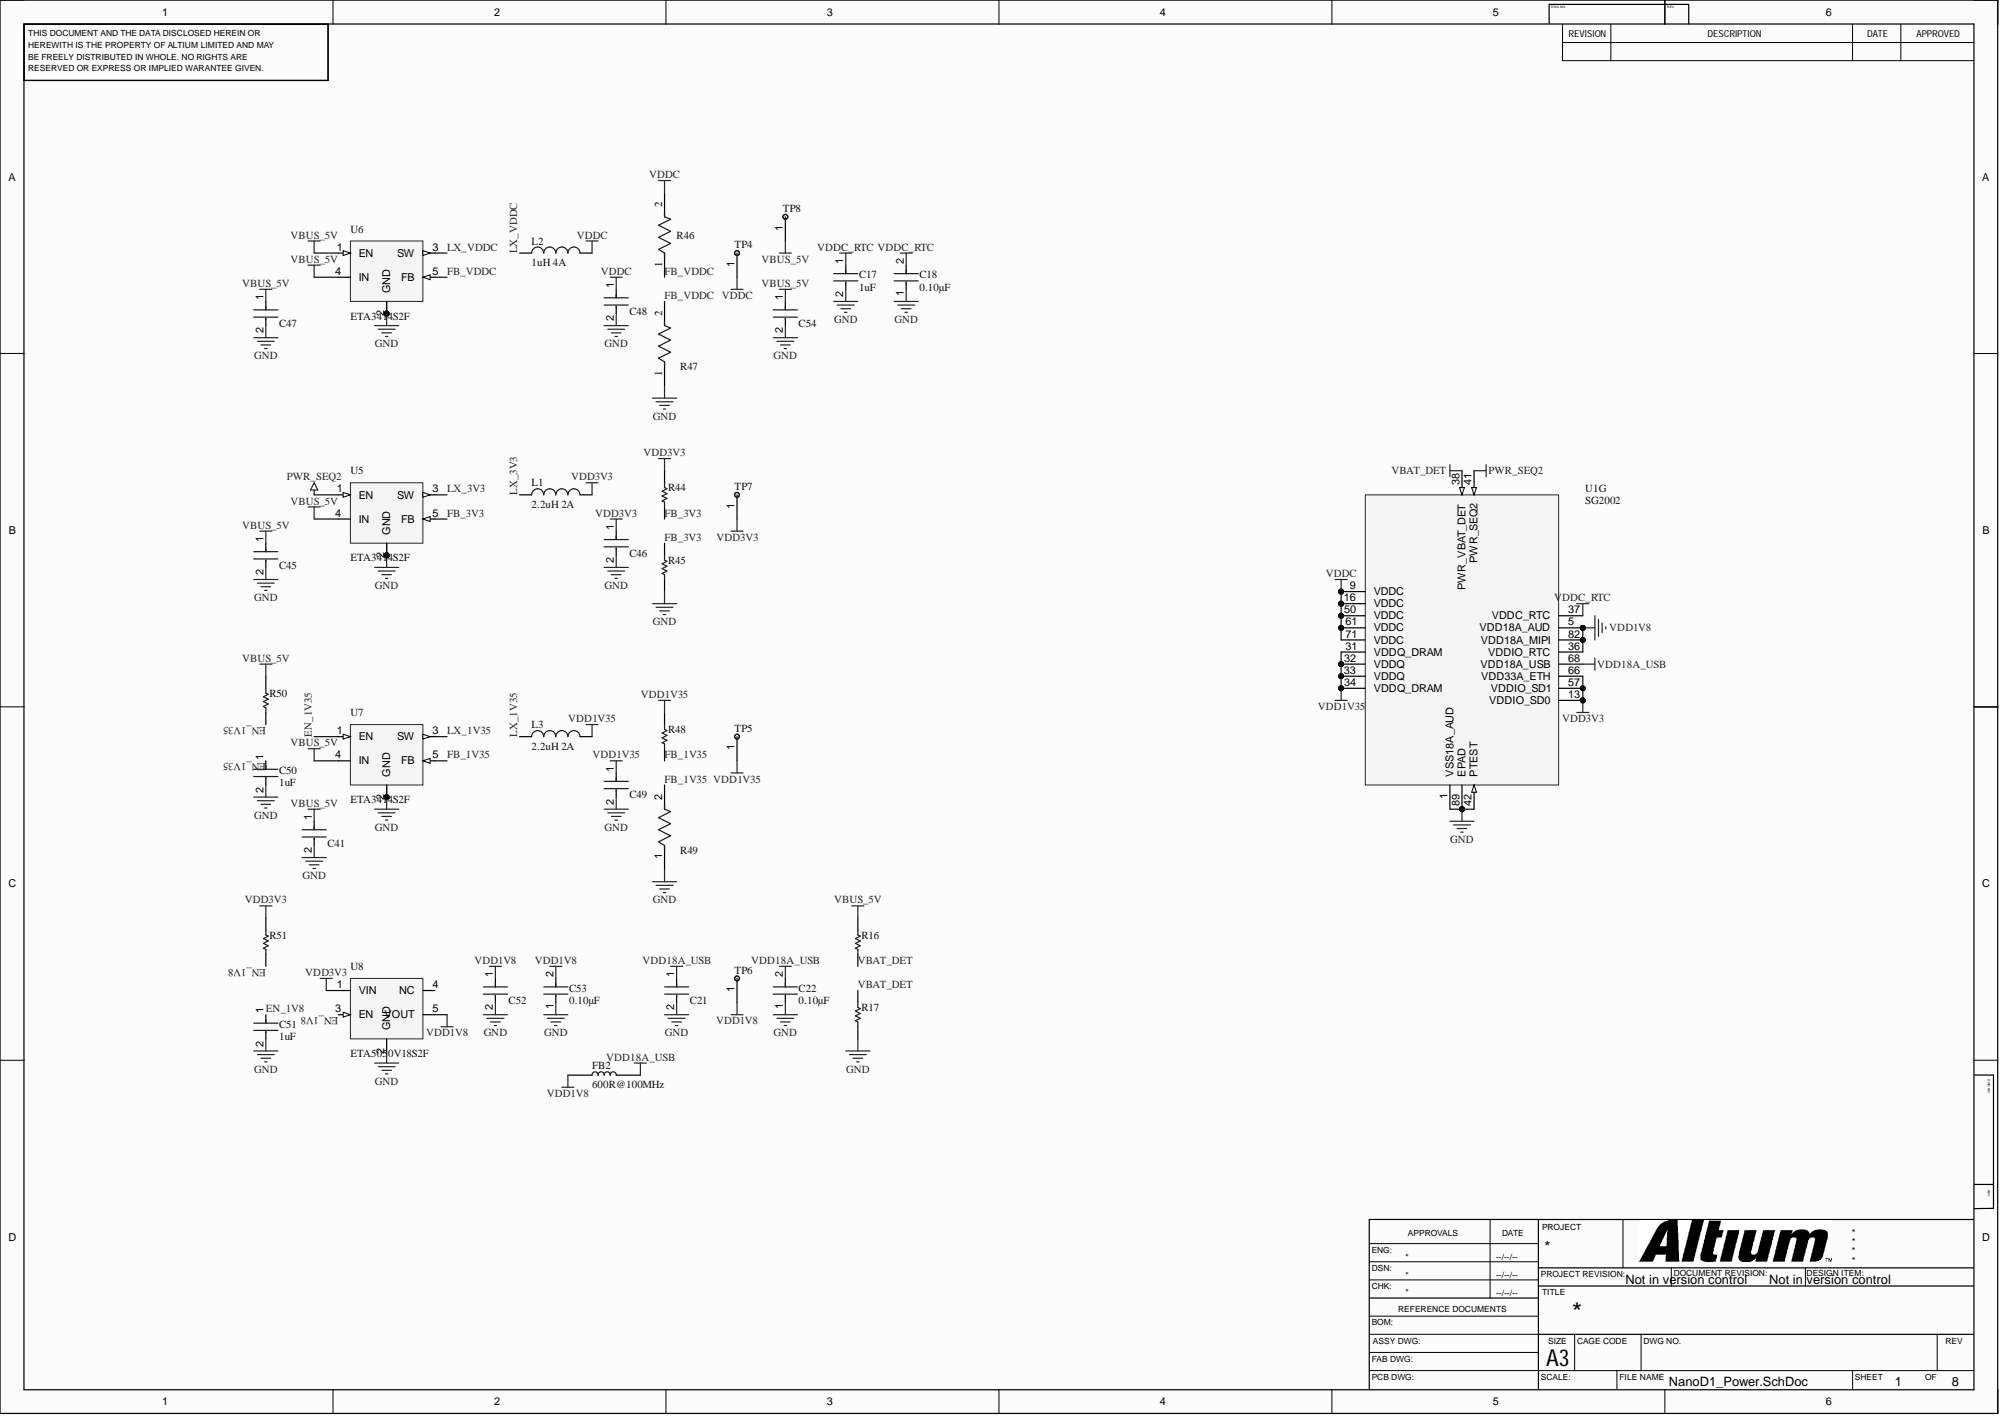
[picture p45: page 1]

THIS DOCUMENT AND THE DA TA DISCL OSED HEREIN O R HEREWITH IS THE PROPERTY OF ALTIUM LIMITED AND M AY BE FREELY DISTRIBUTED IN WHO LE. NO RIGHTS ARE RESERVED OR EXPRESS OR IMPLIED WARANTEE GIVEN. | D D | REVISI ON | DESCRIPTI N | DATE | APPROVED

DATE | PRO JECT * | **** APPROVALS

ENG : | --/--/--
** DSN: | --/--/--

CHK: | --/--/--

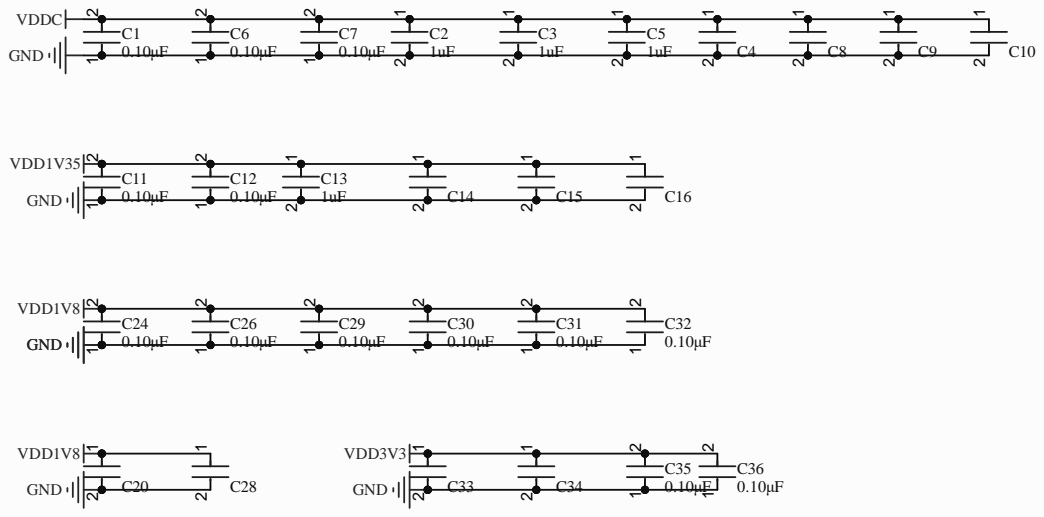
[picture p46: page 2]

DWG NO: | REV:

THIS DOCUMENT AND THE DATA DISCLOSED HEREIN OR HEREWITH IS THE PROPERTY OF ALTIUM LIMITED AND MAY BE FREELY DISTRIBUTED IN WHOLE. NO RIGHTS ARE | | REVISION | DESCRIPTION | DATE | APPROVED

DATE | PROJECT | * * APPROVALS * *

ENG: *

DSN: *

CHK:

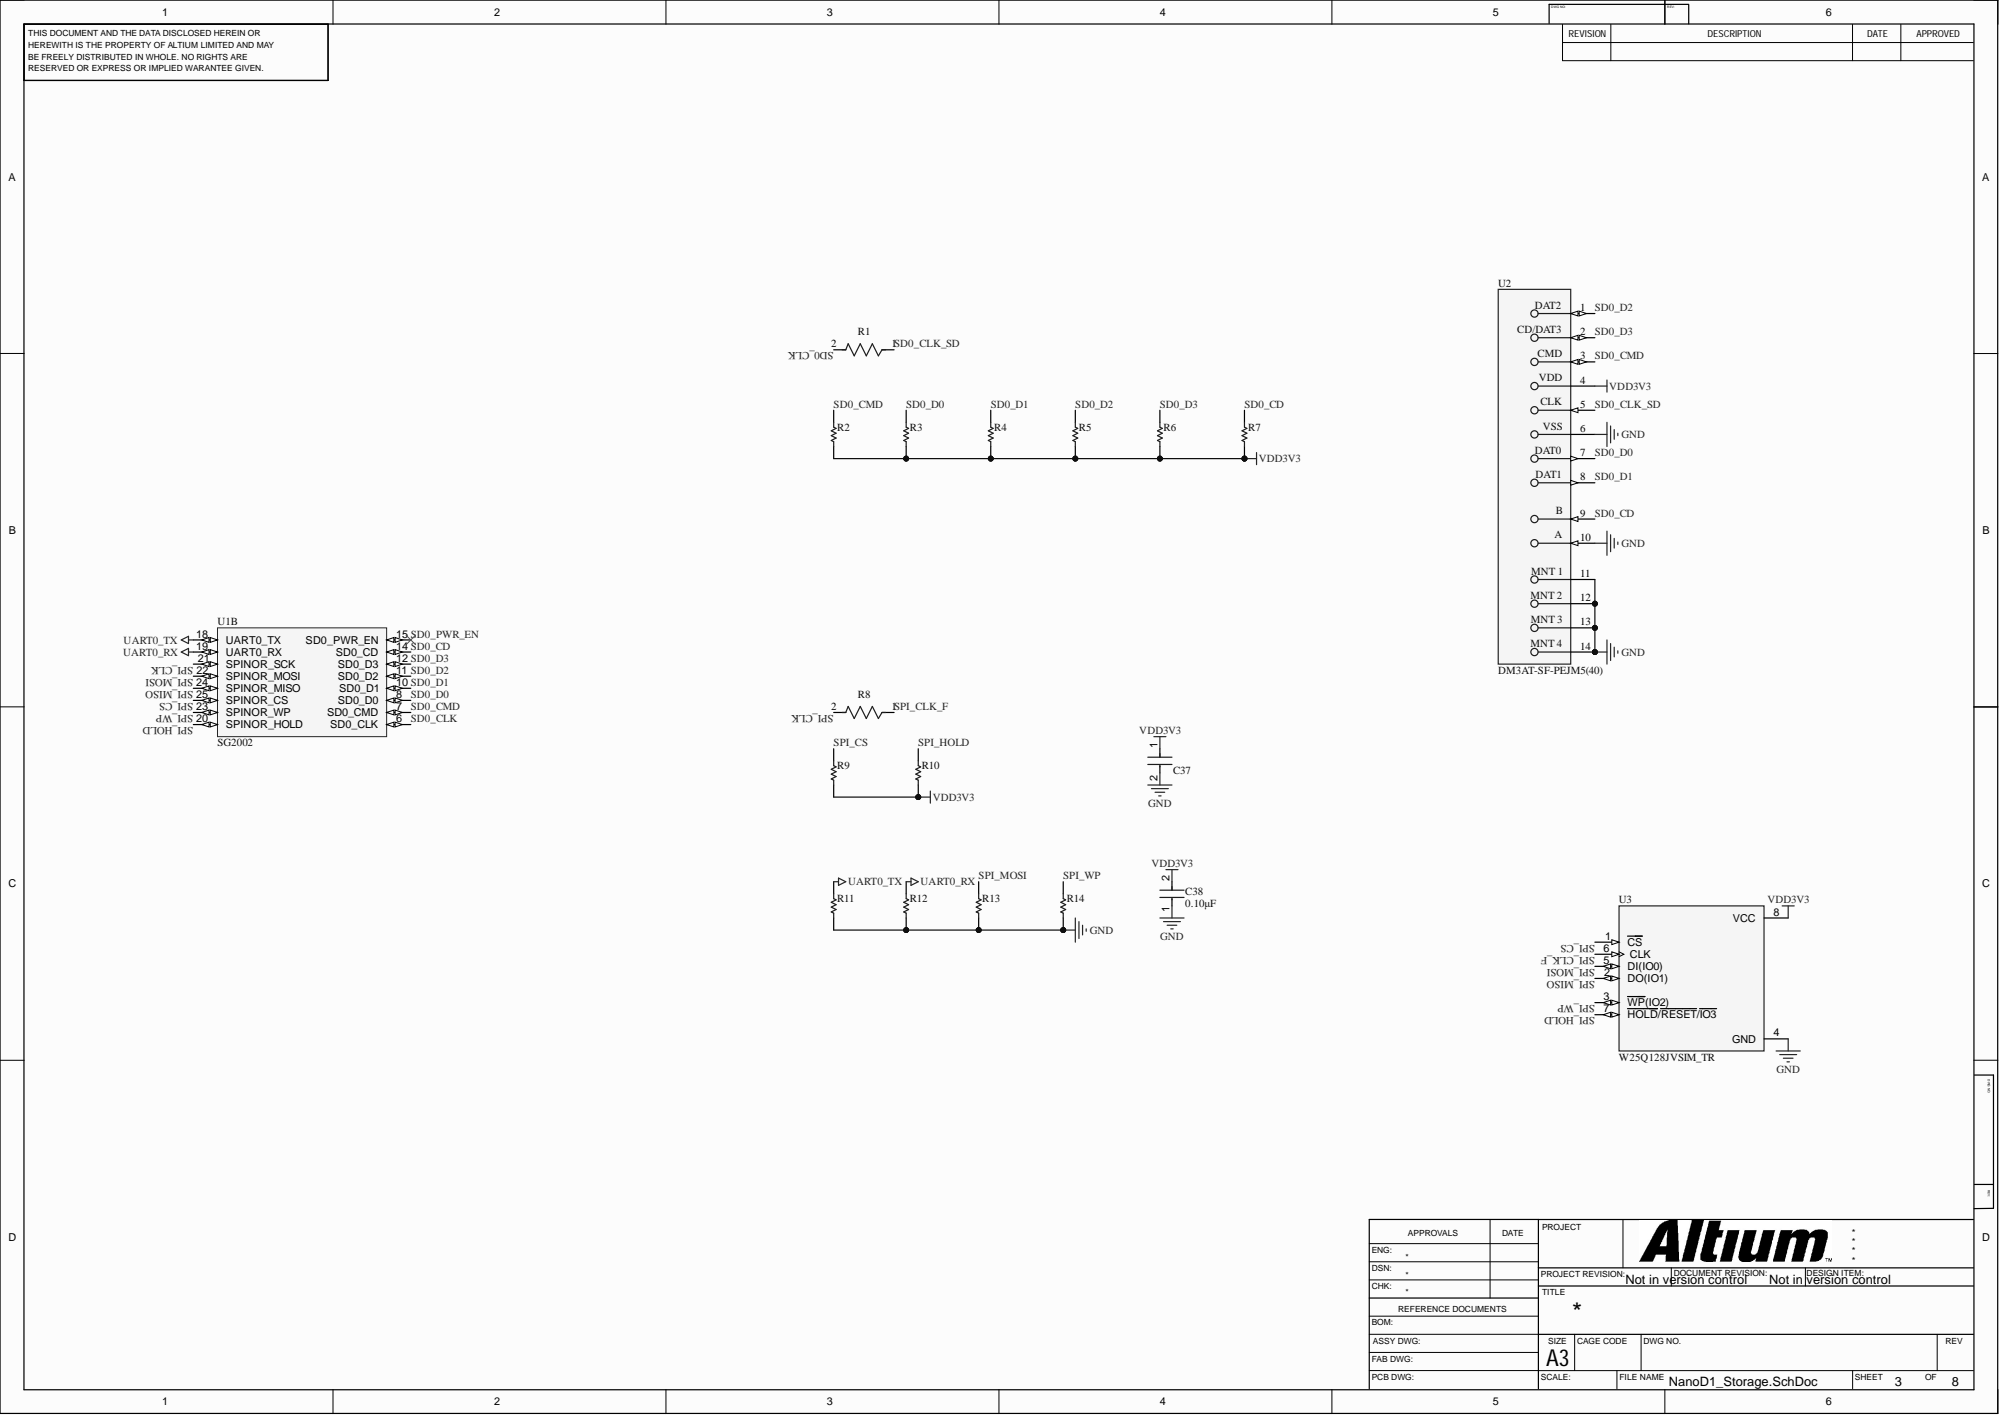
[picture p47: page 3]

DATE | PRO JECT | **** APPROVALS

ENG :
** DSN:

CHK:

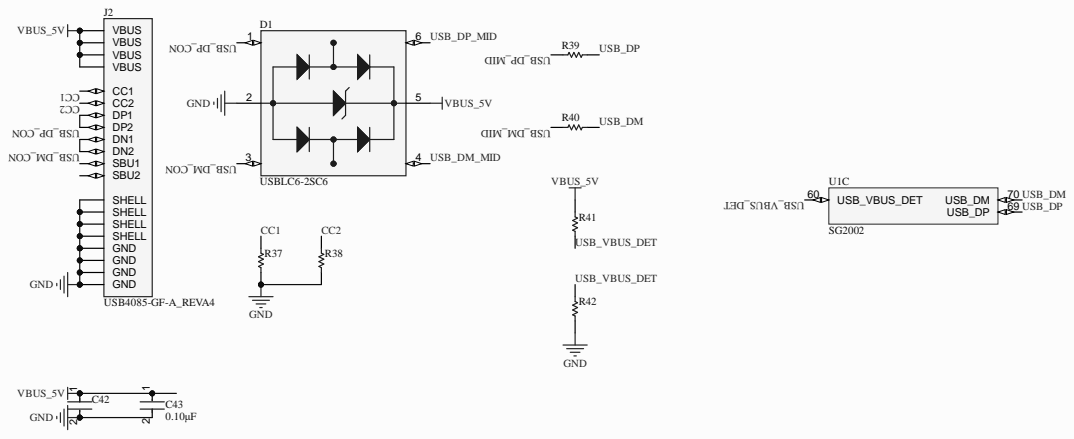
[picture p48: page 4]

DATE | PRO JECT | **** APPROVALS

ENG :
** DSN:

CHK:

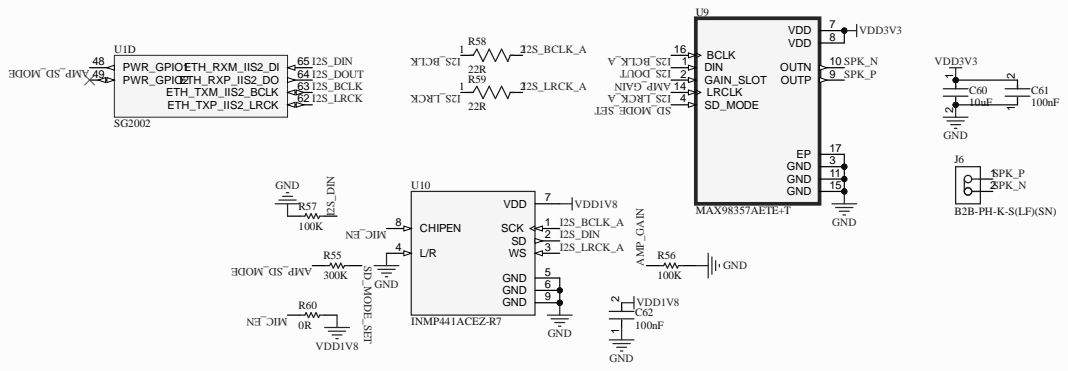
[picture p49: page 5]

DATE | PRO JECT | **** APPROVALS

ENG :
** DSN:

CHK:

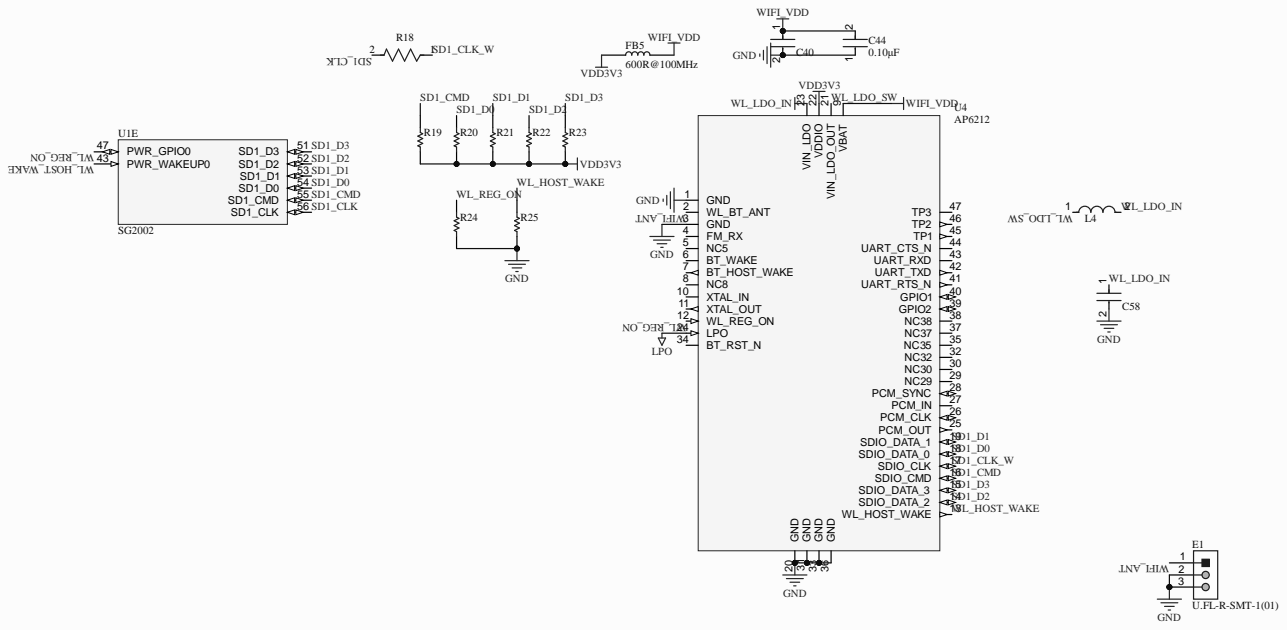
[picture p50: page 6]

DWG NO: | REV:

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

DATE | PROJECT | * * APPROVALS * *

ENG: *

DSN: *

CHK:

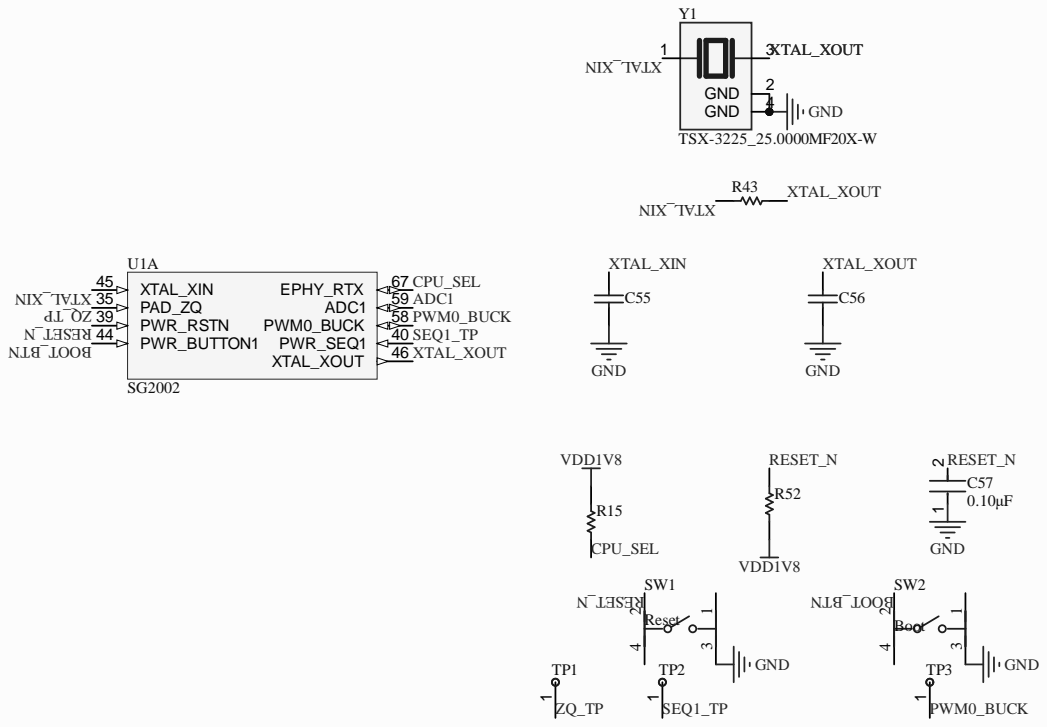
[picture p51: page 7]

DWG NO: | REV:

THIS DOCUMENT AND THE DATA DISCLOSED HEREIN OR HEREWITH IS THE PROPERTY OF ALTIUM LIMITED AND MAY BE FREELY DISTRIBUTED IN WHOLE. NO RIGHTS ARE | Y1 | REVISION | DESCRIPTION | DATE | APPROVED

DATE | PROJECT | * * APPROVALS * *

ENG: *

DSN: *

CHK:

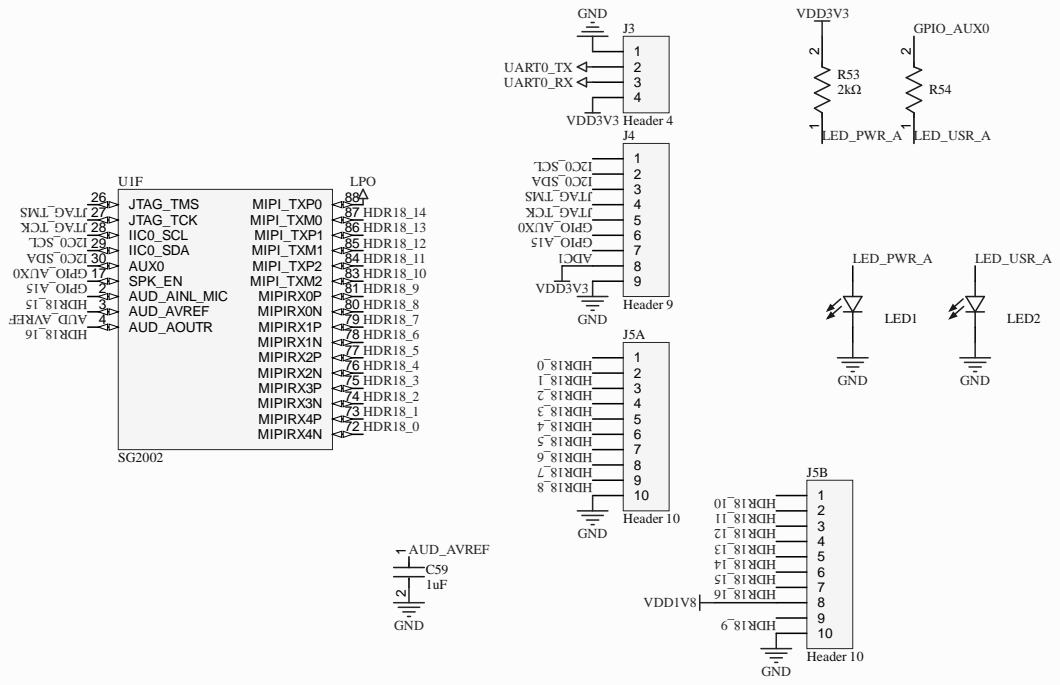
[picture p52: page 8]

DATE | PRO JECT | **** APPROVALS

ENG :
** DSN:

CHK:
