nilotpal-n7/NanoD1/Project Outputs for NanoD1/Assembly/PCB Print/Assembly Drawings.PDF

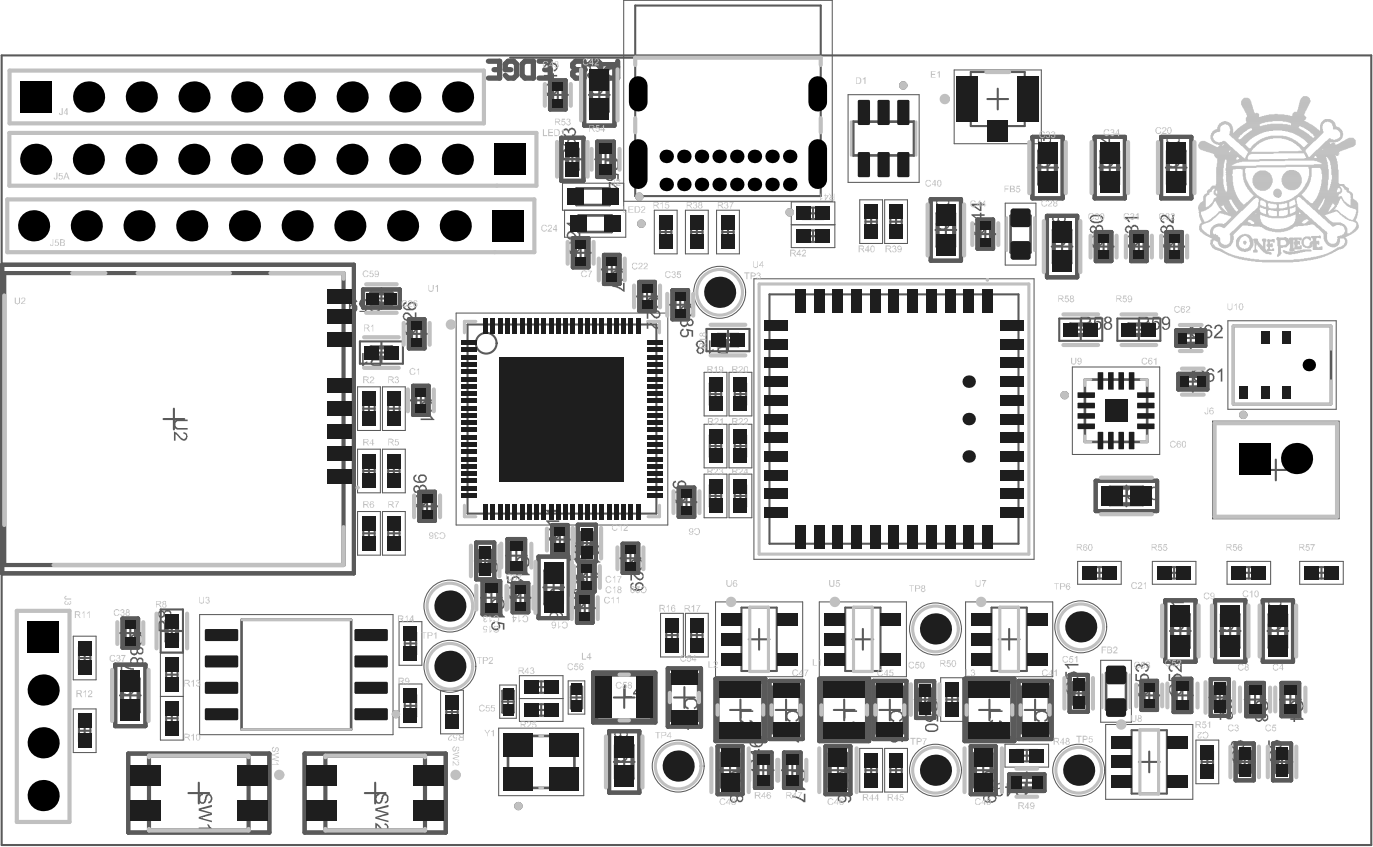
[picture p54: page 1]

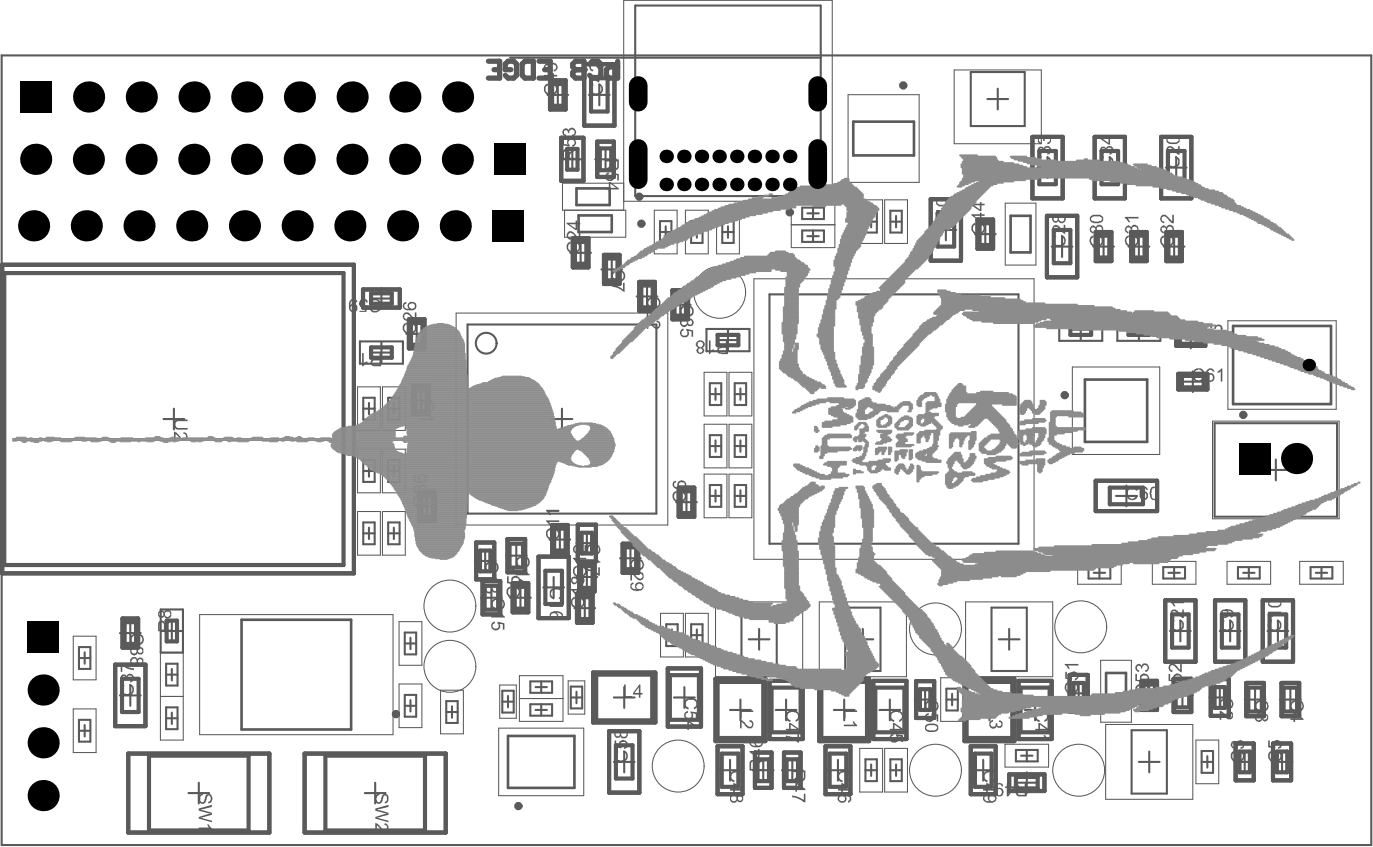
[picture p55: page 2]
