nilotpal-n7/NanoD1/Project Outputs for NanoD1/Assembly/PCB Print/Composite Drawing.PDF

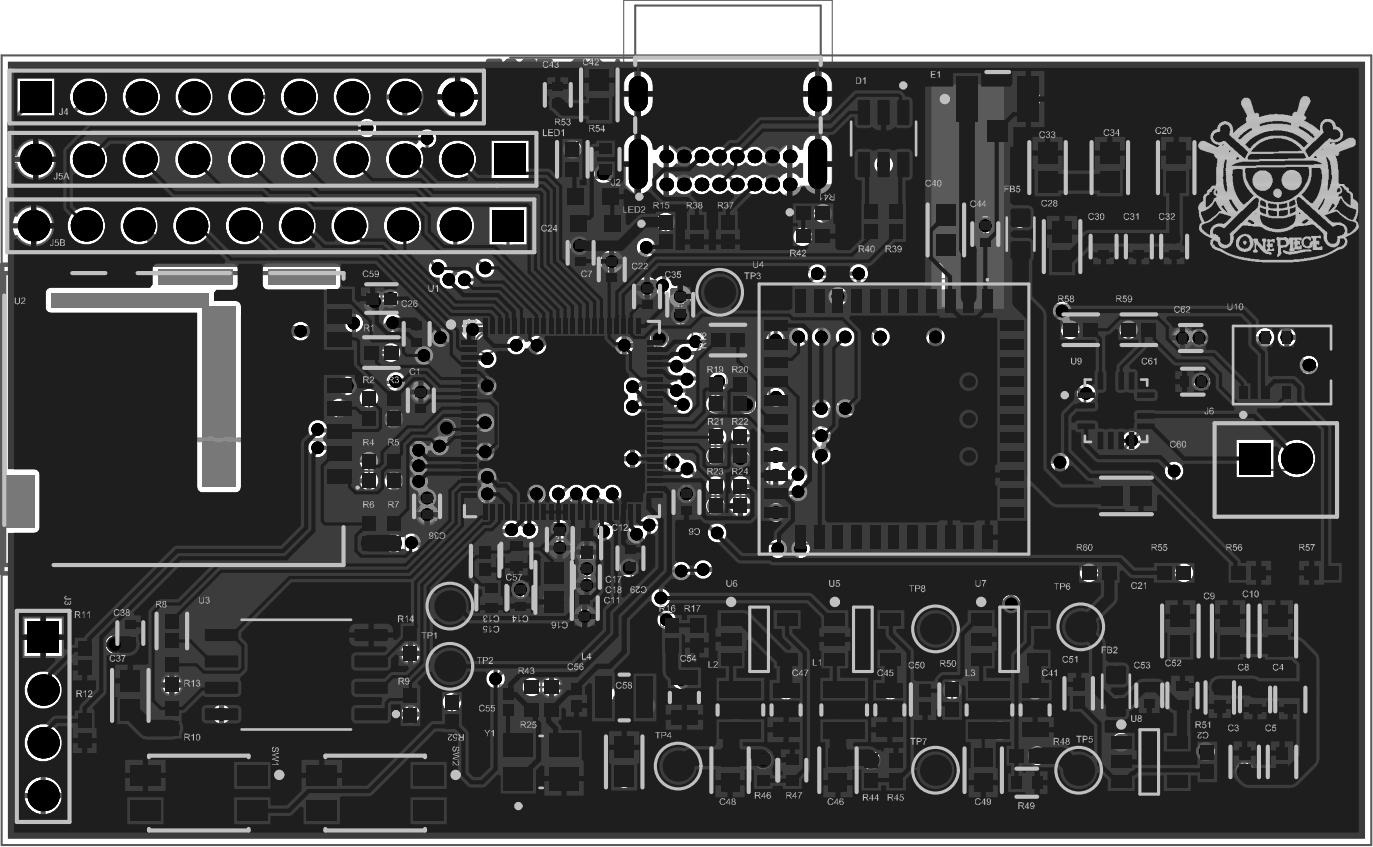
[picture p56: page 1]
