nilotpal-n7/NanoD1/Project Outputs for NanoD1/Sources/PCB 3D Print/PCB 3D Print.PDF

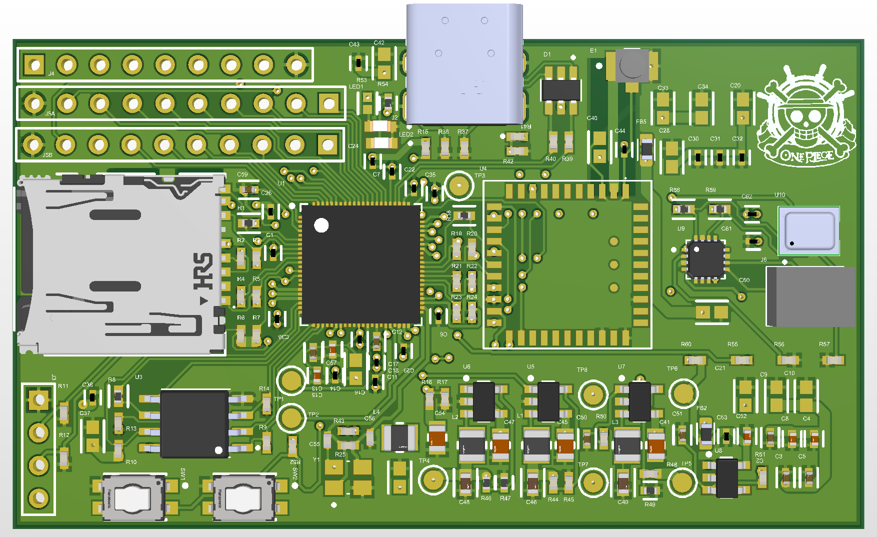
[picture p57: page 1]
