nilotpal-n7/NanoD1/Project Outputs for NanoD1/Assembly Assembly/PCB Print/Solder/Paste Mask Prints.PDF

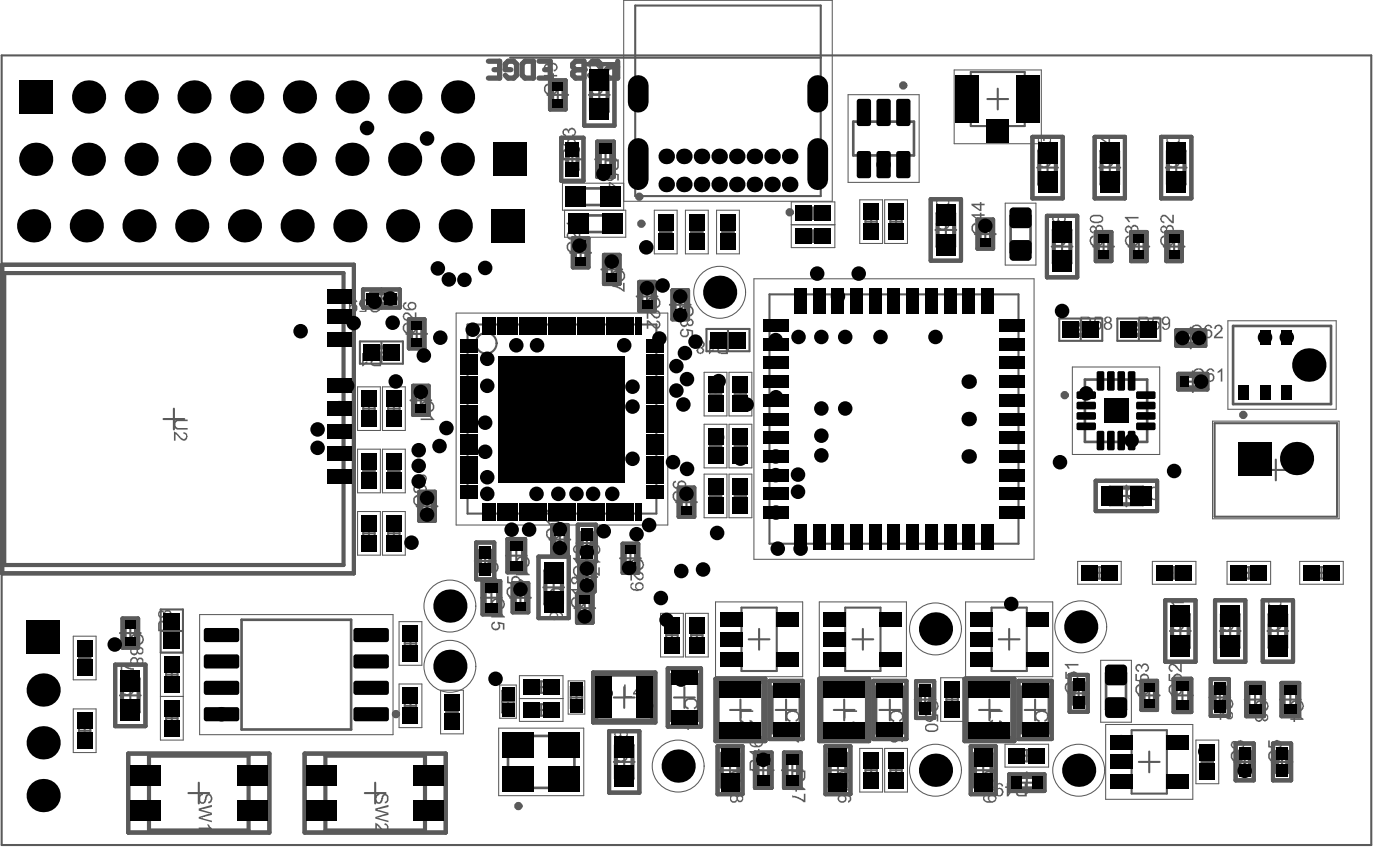
[picture p58: page 3]

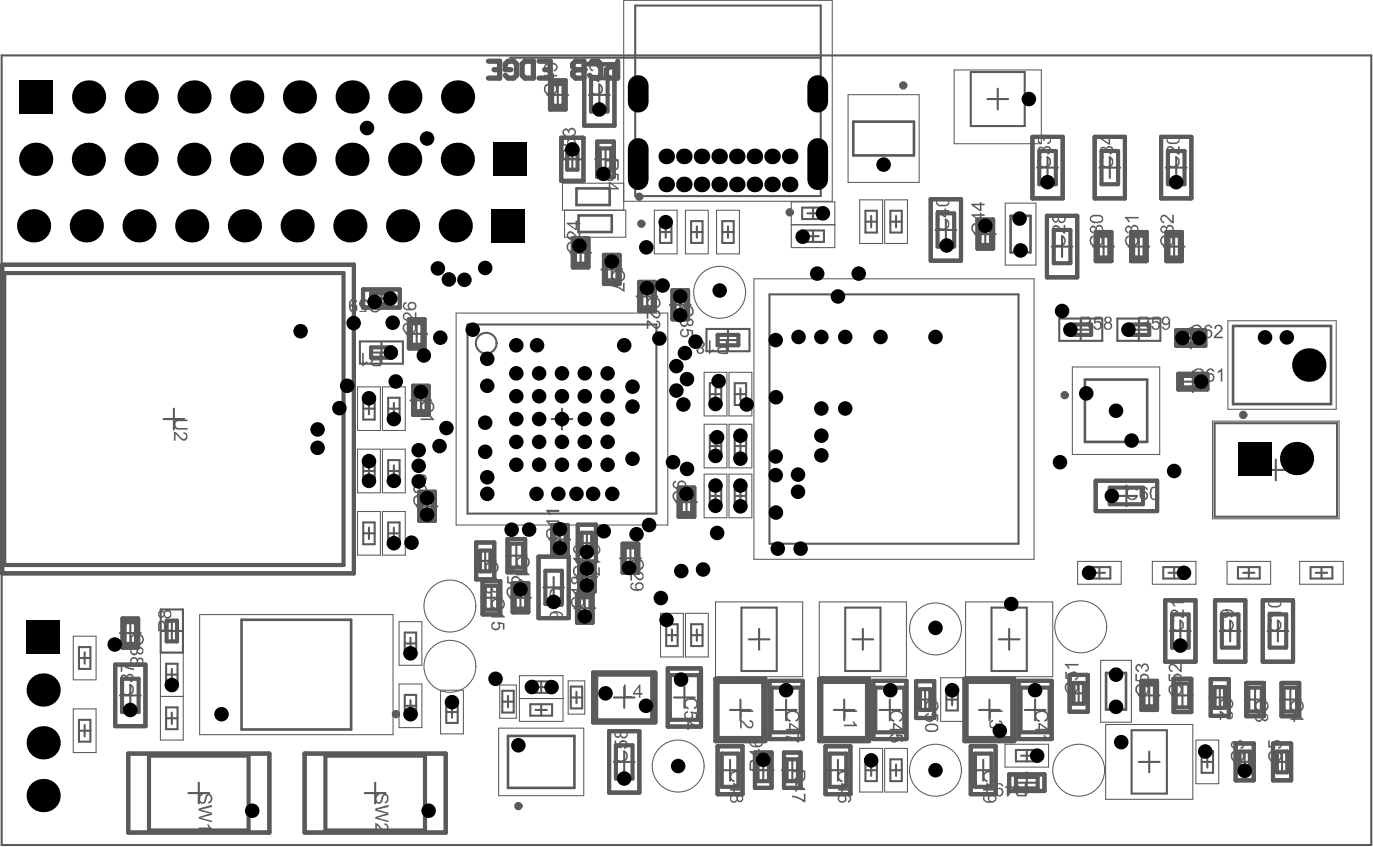
[picture p59: page 4]
