nilotpal-n7/NanoD1/(list of files, drawings)

Other design files:
NanoD1.PcbDoc
NanoD1.PrjPcb
Project Outputs for NanoD1/Sources/NanoD1.PrjPcb
Project Outputs for NanoD1/Sources/Schematics/NanoD1_Clk_Reset.SchDoc
Project Outputs for NanoD1/Sources/Schematics/NanoD1_Decoupling.SchDoc
Project Outputs for NanoD1/Sources/Schematics/NanoD1_IO.SchDoc
Project Outputs for NanoD1/Sources/Schematics/NanoD1_Power.SchDoc
SBC/cadence-imports/Imported Orcad Libraries.PrjPcb/Orcad Libraries.PrjPcb
SBC/cadence-imports/Imported Orcad Libraries.PrjPcb/SG2002_QFN88_Library.SchLib
SBC/cadence-imports/Imported SG2002_QFN88_38_20230301_4L_V1.3_16.2.PrjPcb/01_Cover.SchDoc
SBC/cadence-imports/Imported SG2002_QFN88_38_20230301_4L_V1.3_16.2.PrjPcb/02_Diagram.SchDoc
SBC/cadence-imports/Imported SG2002_QFN88_38_20230301_4L_V1.3_16.2.PrjPcb/03_Power tree.SchDoc
SBC/cadence-imports/Imported SG2002_QFN88_38_20230301_4L_V1.3_16.2.PrjPcb/04_Main.SchDoc
SBC/cadence-imports/Imported SG2002_QFN88_38_20230301_4L_V1.3_16.2.PrjPcb/05_SYS_Power.SchDoc
SBC/cadence-imports/Imported SG2002_QFN88_38_20230301_4L_V1.3_16.2.PrjPcb/06_eMMC_SDIO_SPINAND_SPINOR.SchDoc
SBC/cadence-imports/Imported SG2002_QFN88_38_20230301_4L_V1.3_16.2.PrjPcb/07_USB_LED.SchDoc
SBC/cadence-imports/Imported SG2002_QFN88_38_20230301_4L_V1.3_16.2.PrjPcb/08_RJ45.SchDoc
SBC/cadence-imports/Imported SG2002_QFN88_38_20230301_4L_V1.3_16.2.PrjPcb/09_AUDIO.SchDoc
SBC/cadence-imports/Imported SG2002_QFN88_38_20230301_4L_V1.3_16.2.PrjPcb/10_Sensor.SchDoc
SBC/cadence-imports/Imported SG2002_QFN88_38_20230301_4L_V1.3_16.2.PrjPcb/SG2002_QFN88_38_20230301_4L_V1.3_16.2.PrjPcb
SBC/cadence-imports/Imported SG2002_QFN88_38_20230301_4L_V1.3_16.2.PrjPcb/SG2002_QFN88_38_20230301_4L_V1.3_16.2_Library.SchLib
SBC/cadence-imports/Imported SG2002_work_174.PrjPcb/imports.PcbLib
SBC/cadence-imports/Imported SG2002_work_174.PrjPcb/SG2002_work_174.PcbDoc
SBC/cadence-imports/Imported SG2002_work_174.PrjPcb/SG2002_work_174.PrjPcb
SBC/cadence-imports/SG2002_QFN88_38_20230301_4L_V1.3_16.2.DSN
Schematics/NanoD1_Audio.SchDoc
Schematics/NanoD1_Storage.SchDoc
Schematics/NanoD1_USB.SchDoc
Schematics/NanoD1_Wireless.SchDoc
